AsherNoble/trueskate-ai-hardware/pcb/sources/user-encoder-installed.png

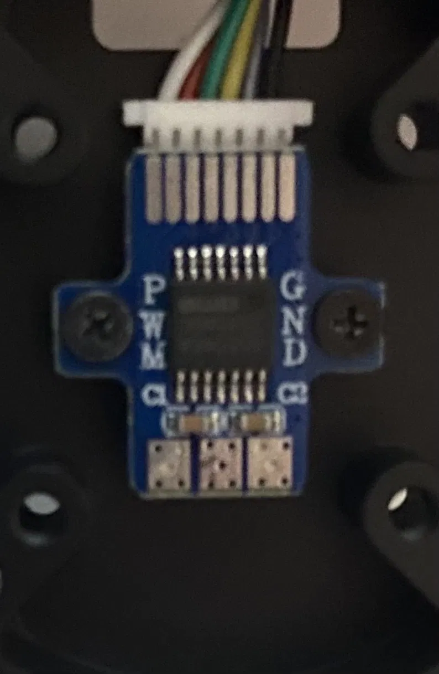
pcb/sources/user-encoder-installed.png
