AsherNoble/trueskate-ai-hardware/pcb/mockups/assembly-model/assembled-top-overview.png

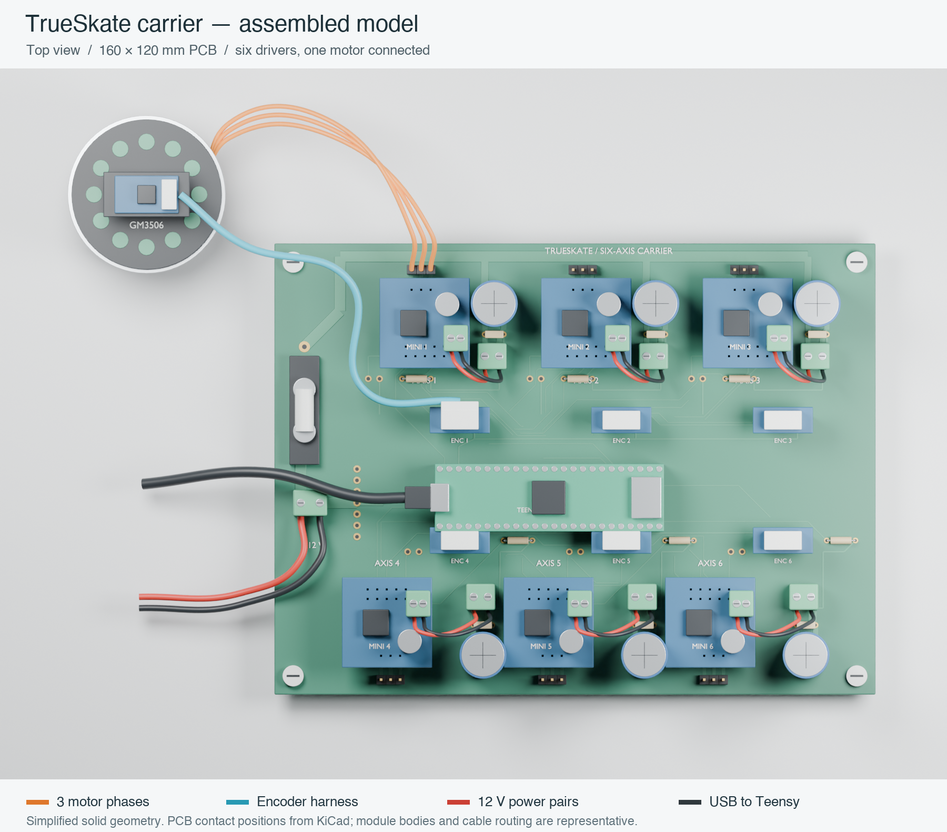
pcb/mockups/assembly-model/assembled-top-overview.png
