AsherNoble/trueskate-ai-hardware/pcb/review/README.md

# Current review package

- `drawings/`: schematic PDF, one-page net guide, 1:1 mechanical template and Mini drill overlay.
- `checks/`: ERC/DRC, connectivity, placement, safety-state and geometry evidence.
- [review-status.json](checks/review-status.json) records the checks and artifact hashes.

The editable source is in [design/](../design/README.md); images are in [renders/](../renders/README.md).
