AsherNoble/trueskate-ai-hardware/pcb/mockups/README.md

# Assembled carrier concept

**Historical revision:** these assembled mockups predate the exact 15-hole
Mini v1.0 direct-power footprint and relocated capacitors. Current board
geometry is in `pcb/trueskate-main-v1.kicad_pcb` and its review renders.

Superseded by the actual Blender assembly in `assembly-model/`. Use
`assembly-model/assembled-overview.png` and `assembly-model/trueskate-assembly.blend`.
The earlier image below is retained only as an abandoned concept.

Generated using the built-in image generation tool, 2026-10-18.
Reference inputs: ../3d-review.png, ../top-review.png,
../sources/user-mini-side.png, ../sources/user-encoder-installed.png.

Prompt brief: Create a realistic elevated three-quarter studio render of the
160 × 120 mm green TrueSkate carrier, populated with a Teensy 4.1, six
SimpleFOC Minis, six capacitors, sockets, headers, fuse, encoder adapters and
one GM3506 motor. Show USB, 12 V power, short paired driver power wires,
three motor phase wires and a separate six-conductor encoder cable.
Preserve reference board layout and use external labels. Caption it as an
illustrative concept, not a wiring guide. Revision prompt corrected USB mating,
encoder connection to ENC1 and removed capacitor-connected power wires.

This is an AI-generated visual mockup, not an assembled CAD model. Component
geometry, connector placement and some wire terminations are approximate.
In particular the top-row power terminals are duplicated/misplaced, motor phase
termination is partly obscured, and Teensy proportions are approximate.
Use the native KiCad files and docs/pcb/nets.md for assembly, not this image.
No manufacturing source or fabrication ZIP was changed.
