AsherNoble/trueskate-ai-hardware/docs/pcb/mechanical.md

# Current mechanical layout

150 × 140 × 1.6 mm; upper A2/A3/A5, lower A1/A4/A6 at 35 mm pitch. Four Ø3.2 mm M3 holes: (4,4), (146,4), (146,136), (4,136) mm. Teensy USB shell is flush at X=0, SD end at PCB X=61.66 mm. Reserve X=61.66…81.66, Y=62.5…77.5 mm for card access.

See the [3+3 report](3plus3-layout.md), [SD drawing](../../pcb/review/drawings/sd-access.svg) and [1:1 fit drawing](../../pcb/review/drawings/mechanical-fit-review.pdf). Actual socket, card, cable and enclosure fit still require checking.
