AsherNoble/trueskate-ai-hardware/pcb/manufacturing/validation/drill-report.txt

Drill report for trueskate-main-v1.kicad_pcb
Created on 2026-10-25T18:21:48

Copper Layer Stackup:
    =============================================================
    L1 :  F.Cu                      front
    L2 :  B.Cu                      back

Drill file 'trueskate-main-v1-PTH.drl' contains
    plated through holes:
    =============================================================
    T1  0.300mm  0.0118"  (500 holes))
    T2  0.600mm  0.0236"  (8 holes))
    T3  0.800mm  0.0315"  (84 holes))
    T4  1.000mm  0.0394"  (68 holes))
    T5  1.021mm  0.0402"  (18 holes))
    T6  1.100mm  0.0433"  (2 holes))
    T7  1.101mm  0.0433"  (72 holes))
    T8  1.200mm  0.0472"  (12 holes))
    T9  1.300mm  0.0512"  (2 holes))
    T10  1.400mm  0.0551"  (3 holes))
    T11  1.650mm  0.0650"  (4 holes))

    Total plated holes count 773

Drill file 'trueskate-main-v1-NPTH.drl' contains
    unplated through holes:
    =============================================================
    T1  3.200mm  0.1260"  (4 holes))

    Total unplated holes count 4
