AsherNoble/trueskate-ai-hardware/pcb/sources/README.md

# Design references

Manufacturer drawings, tagged SimpleFOC Mini source, derived Mini geometry and
user-supplied reference photographs are kept here. `jlc-two-layer-1oz/` contains
the current quote evidence and settings. Prior four-layer quotes and stopped
thermal calculations are in [archive/](../archive/README.md).

The source records retain their original file names, revision identifiers and
provenance. They are references, not manufacturing exports for this carrier.
