AsherNoble/trueskate-ai-hardware/pcb/3d-review.png

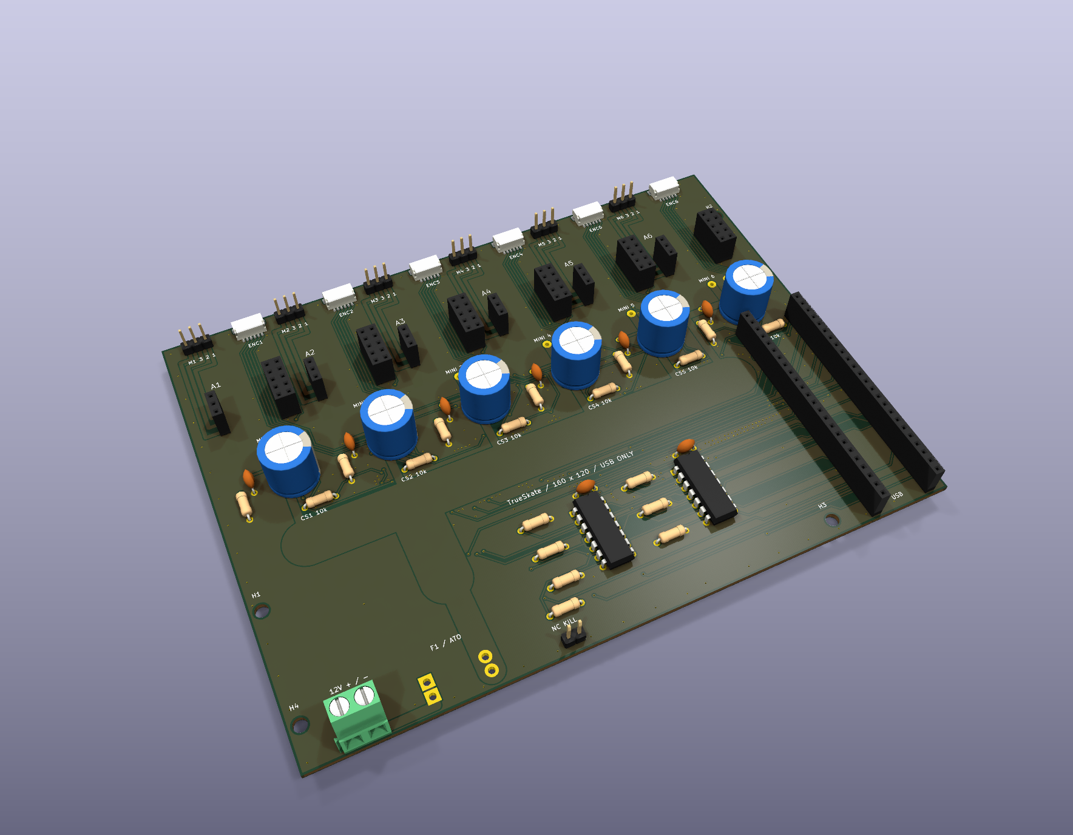
pcb/3d-review.png
