AsherNoble/trueskate-ai-hardware/pcb/bottom-review.png

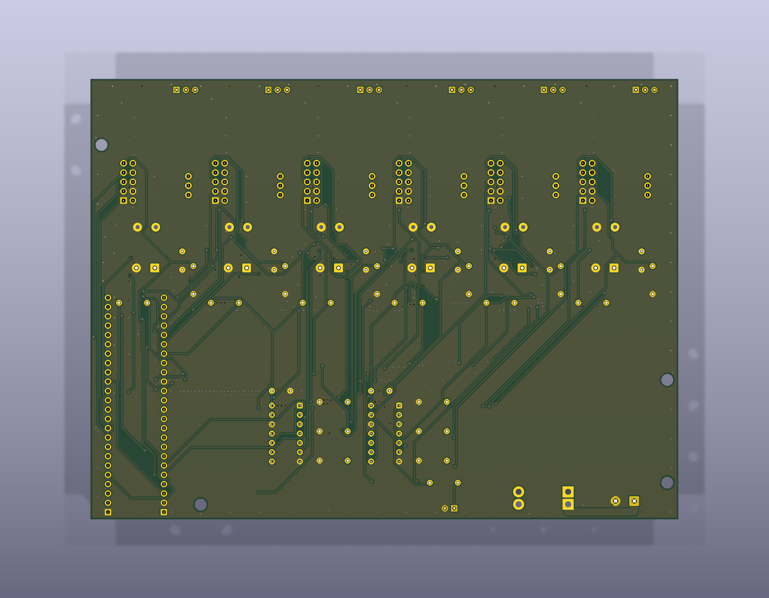
pcb/bottom-review.png
