AsherNoble/trueskate-ai-hardware/pcb/l2-ground-review.png

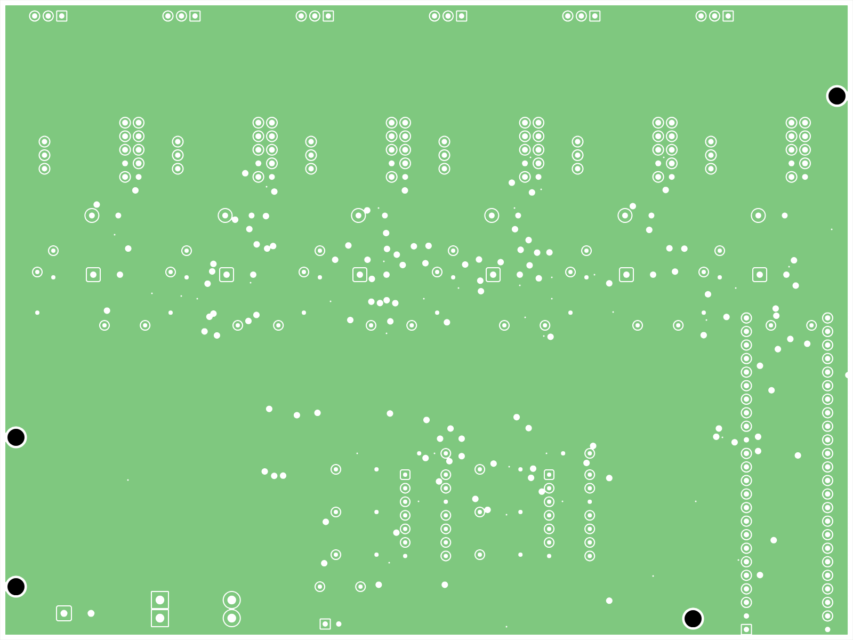
pcb/l2-ground-review.png
