AsherNoble/trueskate-ai-hardware/pcb/mini-drill-overlay.png

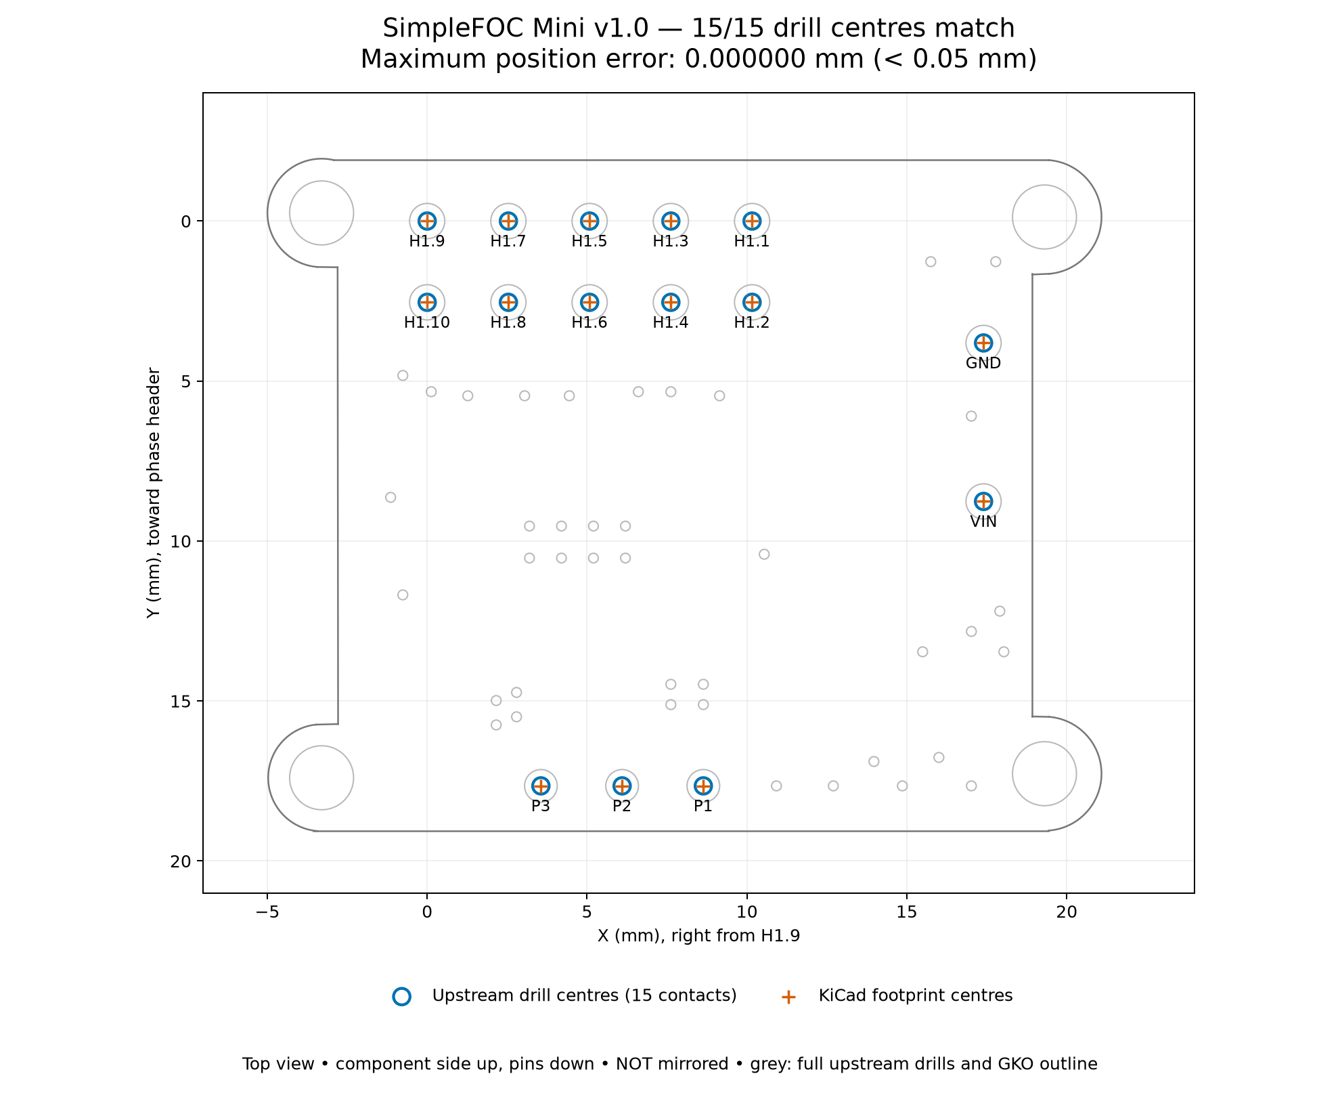
pcb/mini-drill-overlay.png
