AsherNoble/trueskate-ai-hardware/pcb/renders/bare/3d-review.png

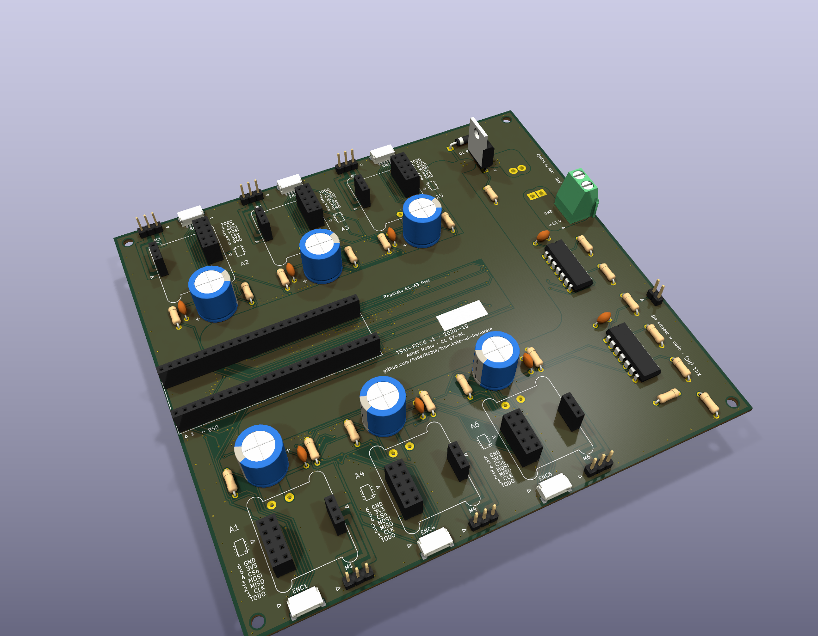
pcb/renders/bare/3d-review.png
