AsherNoble/trueskate-ai-hardware/pcb/renders/bare/bottom-review.png

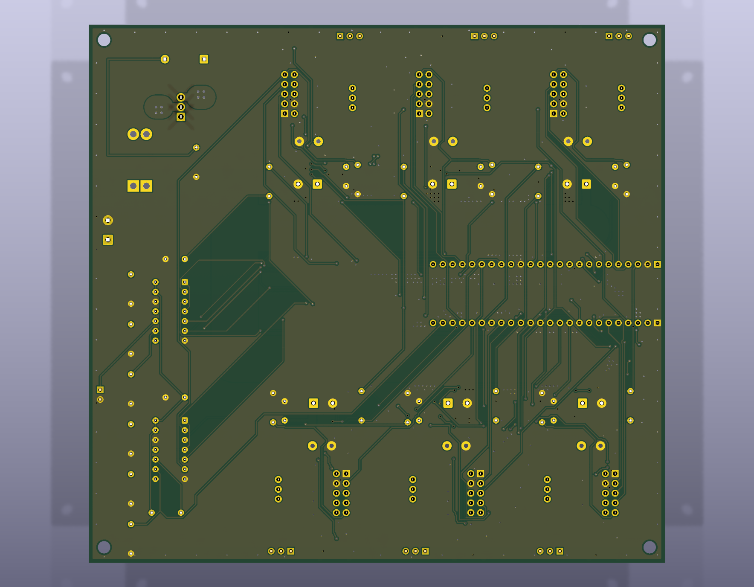
pcb/renders/bare/bottom-review.png
