AsherNoble/trueskate-ai-hardware/pcb/renders/bare/top-review.png

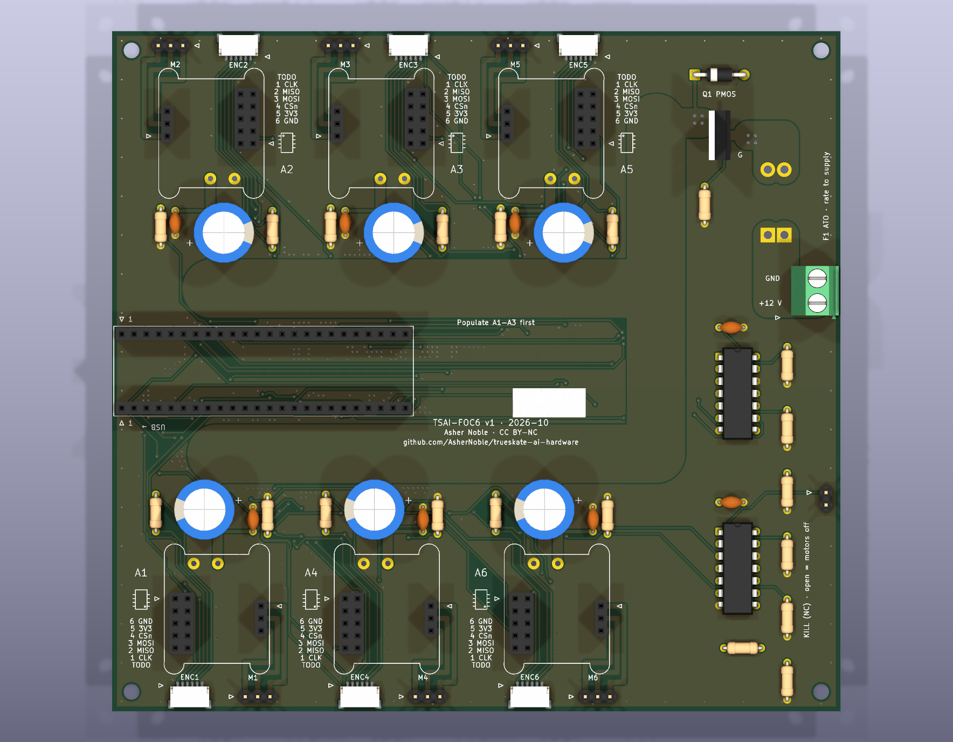
pcb/renders/bare/top-review.png
