AsherNoble/trueskate-ai-hardware/pcb/renders/copper/return-path-gaps.png

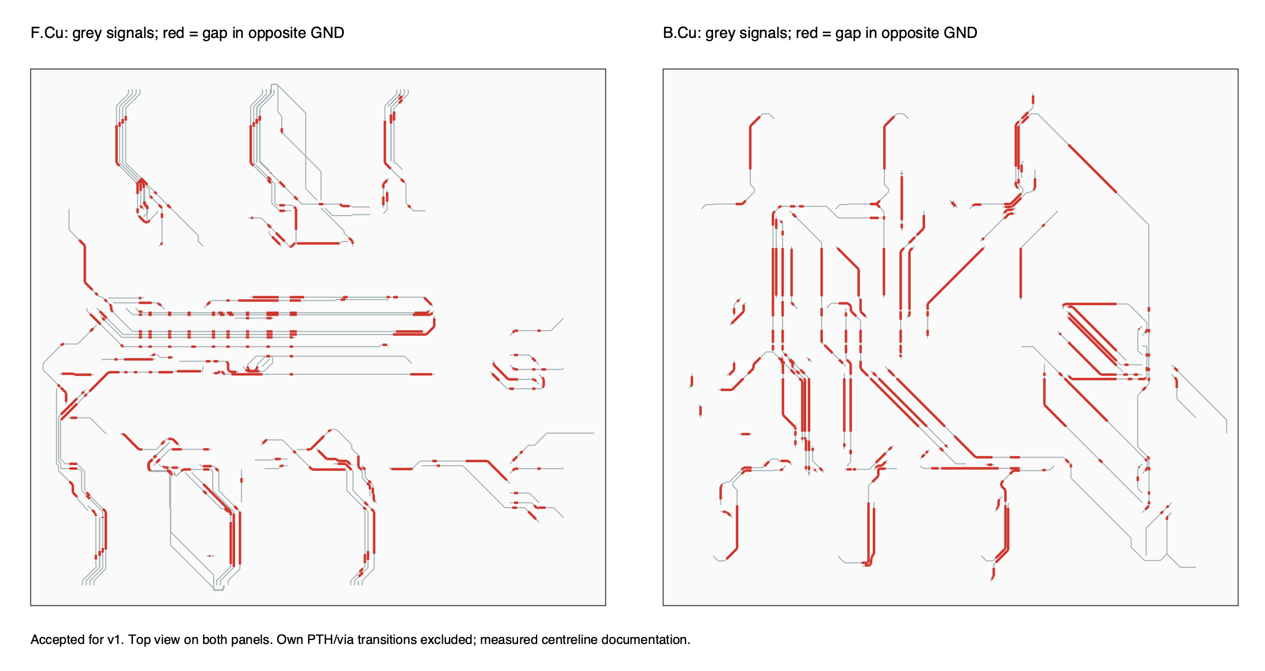
pcb/renders/copper/return-path-gaps.png
