AsherNoble/trueskate-ai-hardware/pcb/renders/populated-bottom.png

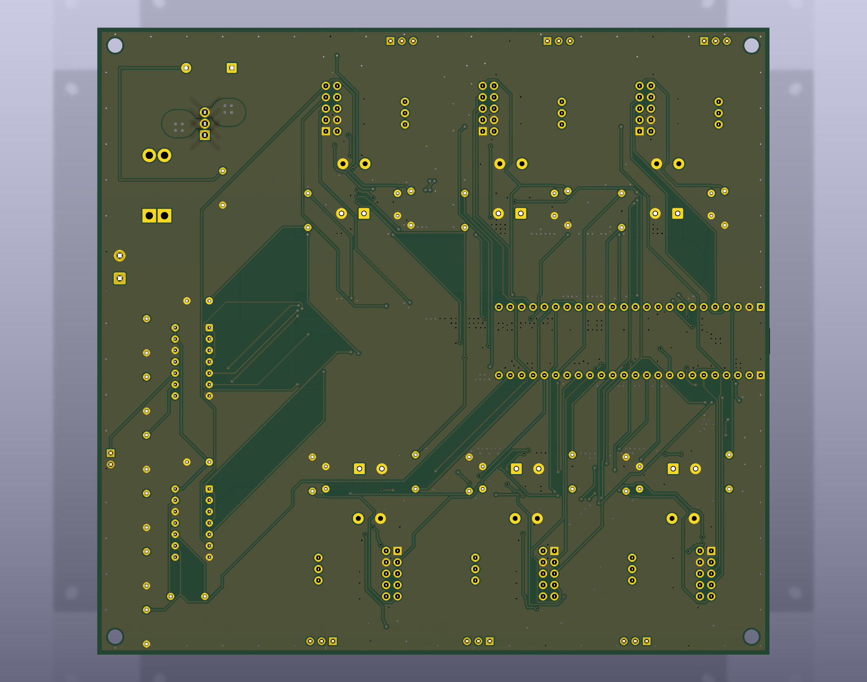
pcb/renders/populated-bottom.png
