AsherNoble/trueskate-ai-hardware/pcb/renders/populated-perspective.png

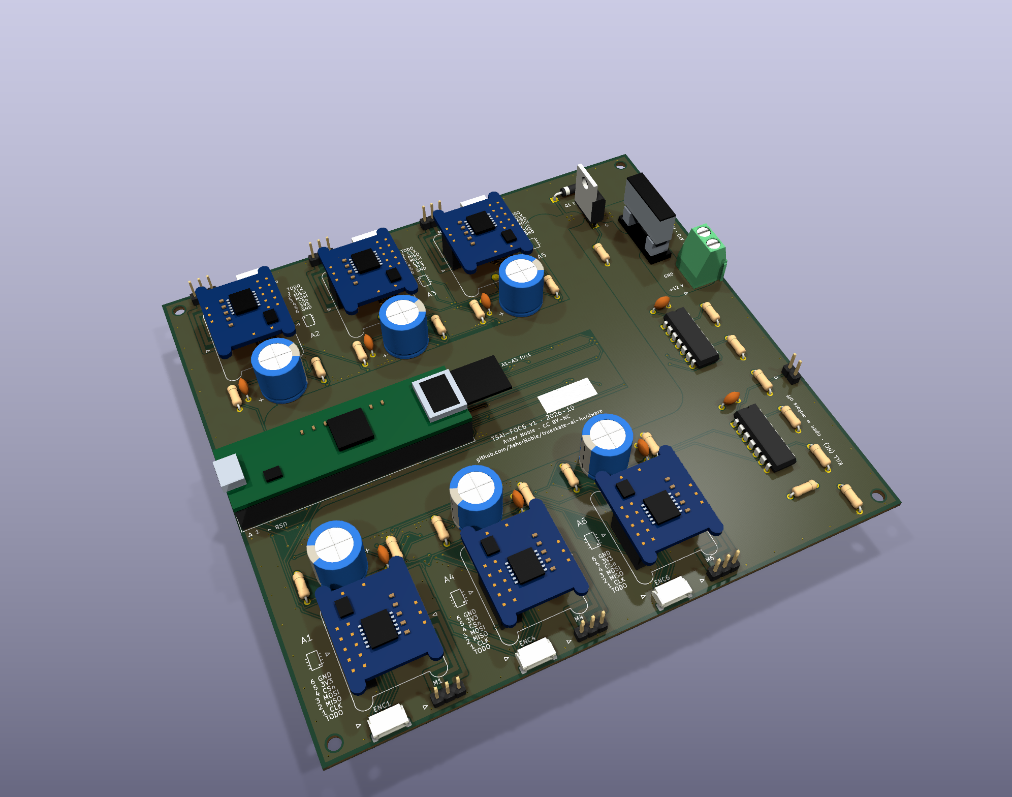
pcb/renders/populated-perspective.png
