AsherNoble/trueskate-ai-hardware/pcb/renders/populated-rear.png

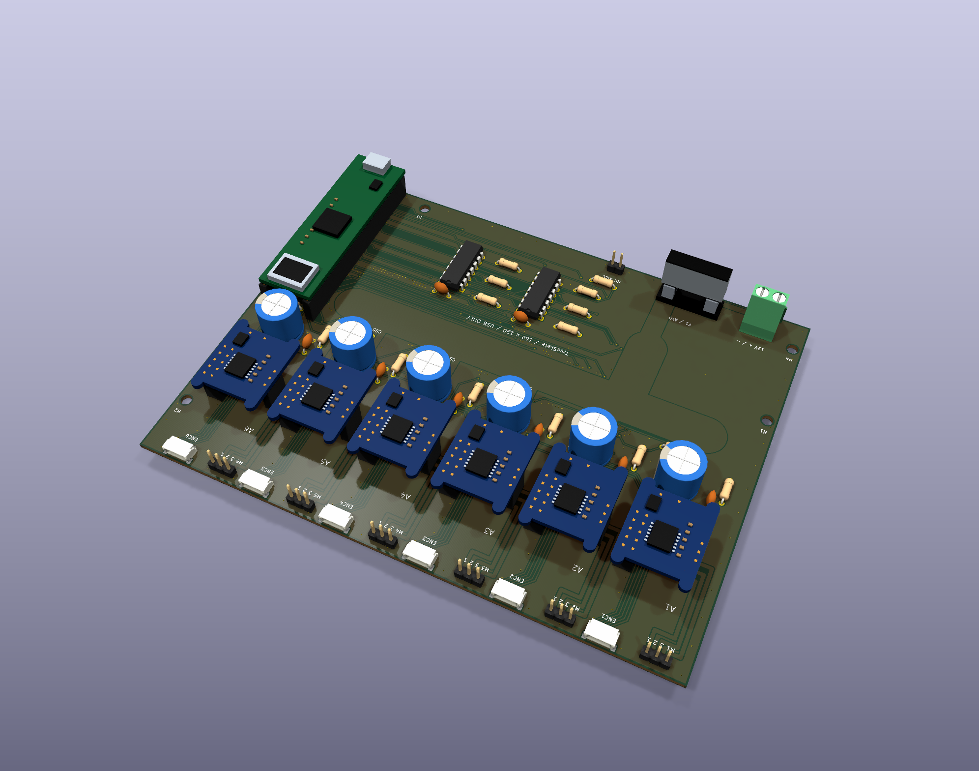
pcb/renders/populated-rear.png
