AsherNoble/trueskate-ai-hardware/pcb/renders/populated-top.png

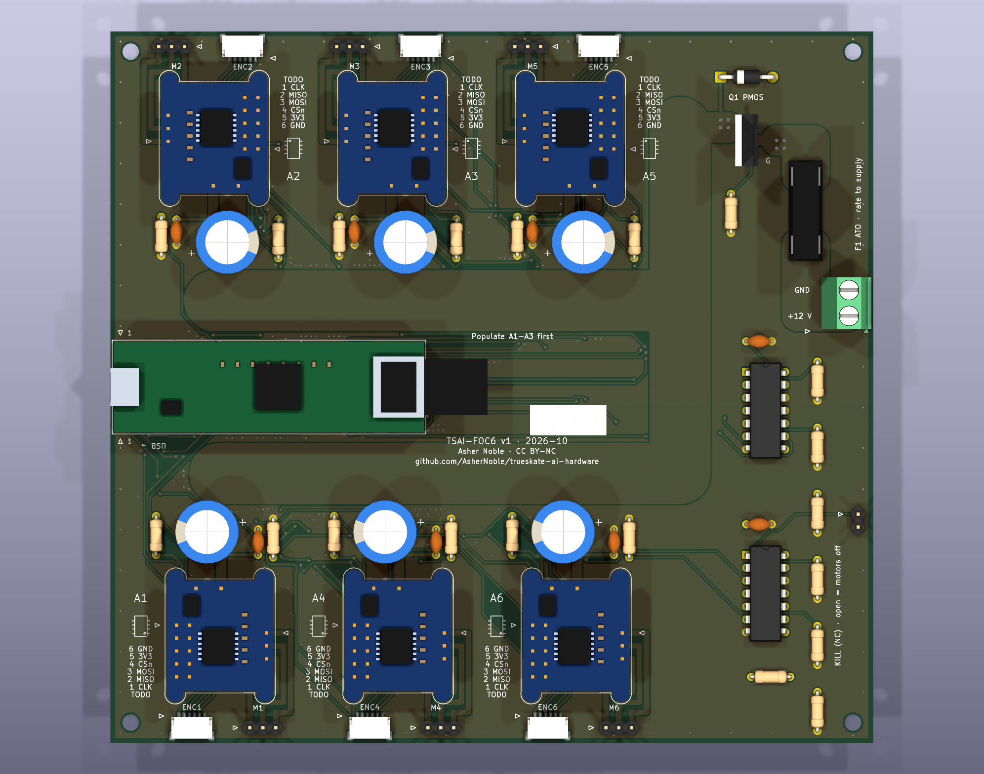
pcb/renders/populated-top.png
