AsherNoble/trueskate-ai-hardware/pcb/review/drawings/sd-access.png

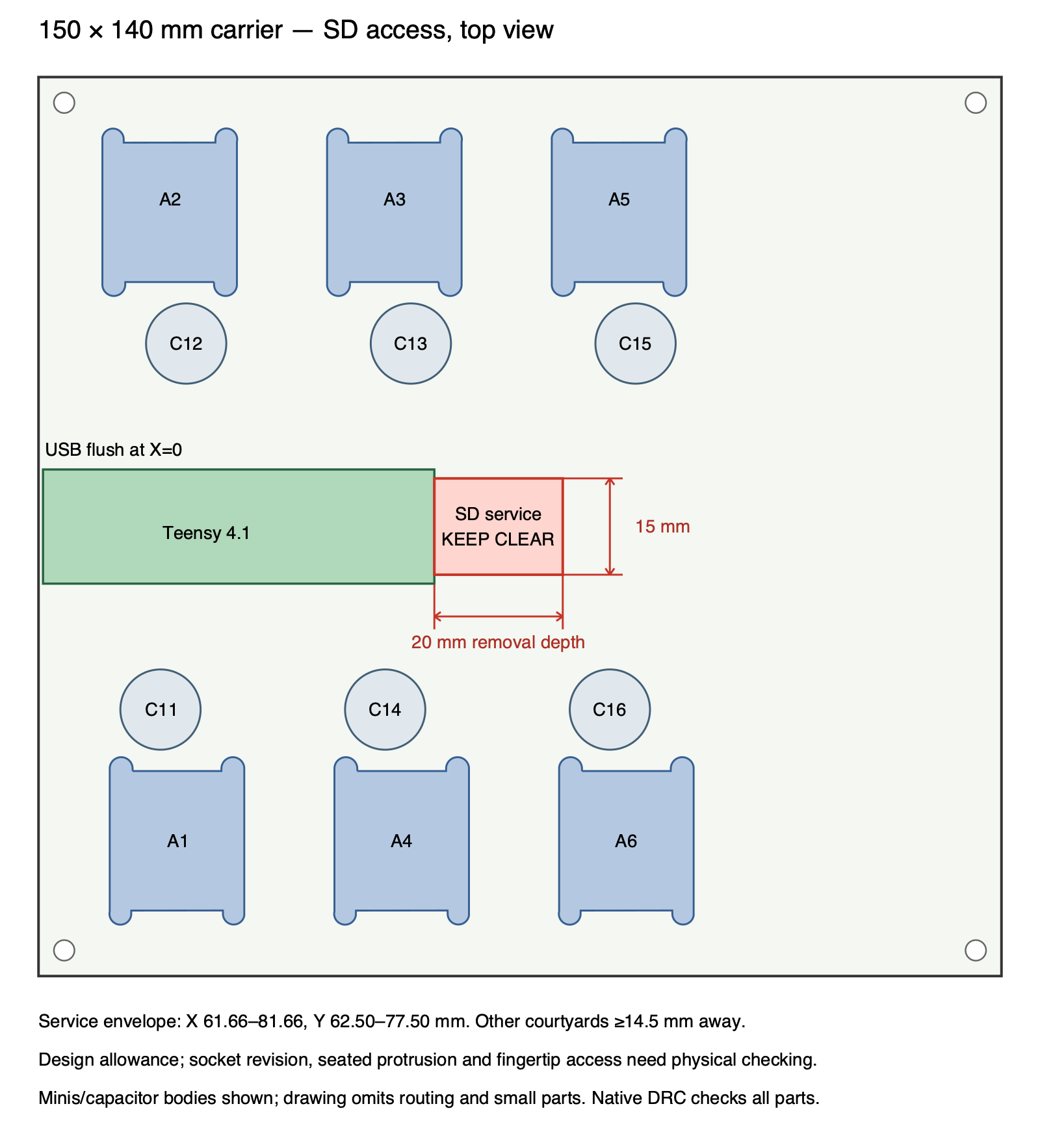
pcb/review/drawings/sd-access.png
