AsherNoble/trueskate-ai-hardware/pcb/sources/iflight-encoder-labels.png

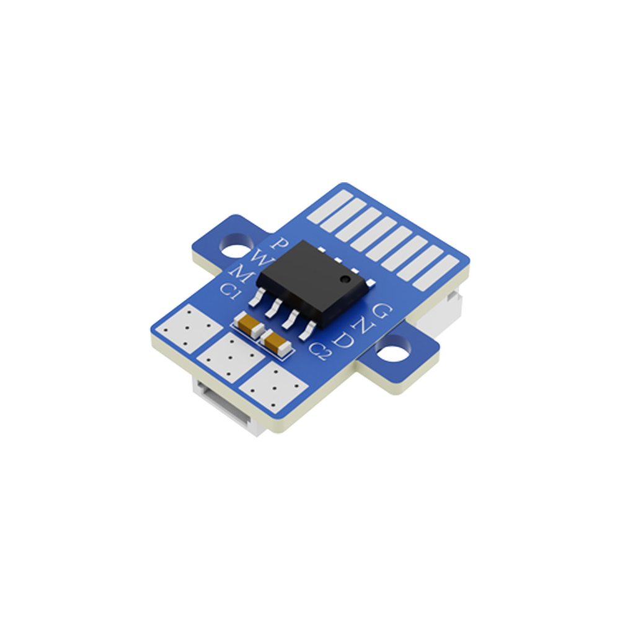
pcb/sources/iflight-encoder-labels.png
