AsherNoble/trueskate-ai-hardware/pcb/sources/iflight-encoder.png

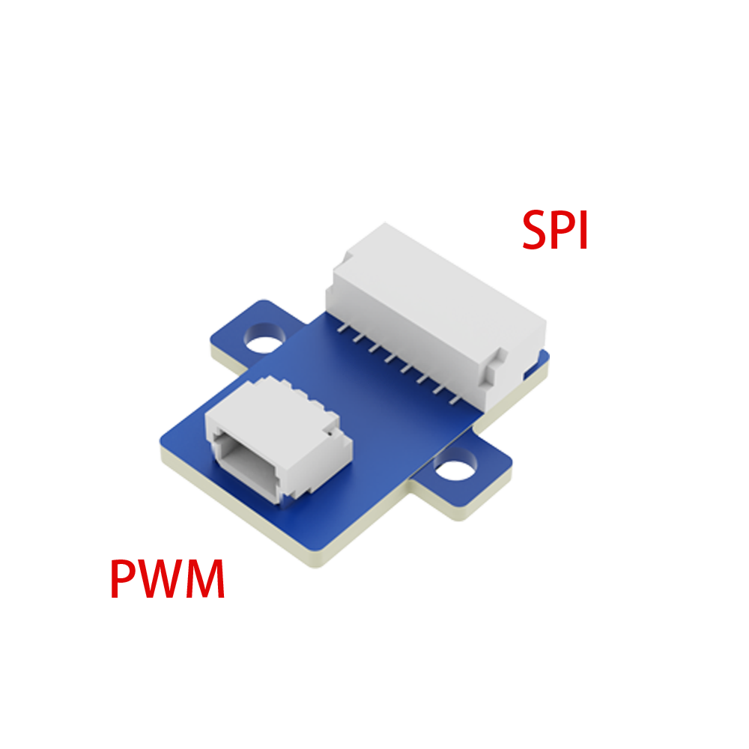
pcb/sources/iflight-encoder.png
