AsherNoble/trueskate-ai-hardware/pcb/sources/jlc-3plus3/150x100.png

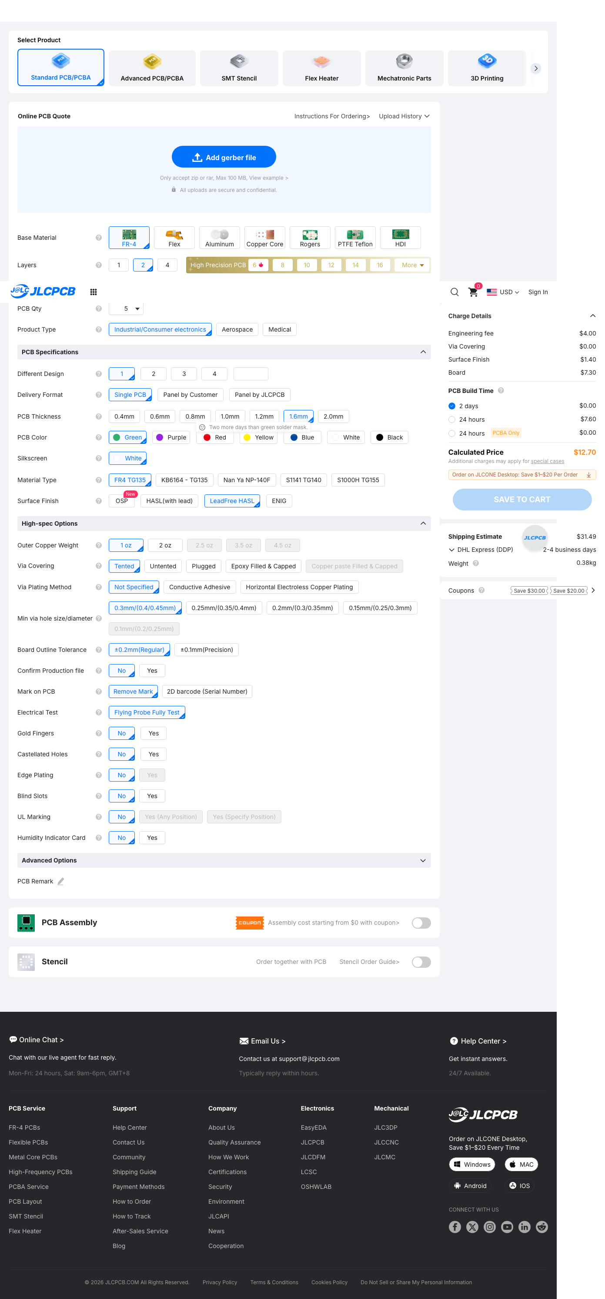
pcb/sources/jlc-3plus3/150x100.png
