AsherNoble/trueskate-ai-hardware/pcb/sources/user-encoder-chip.png

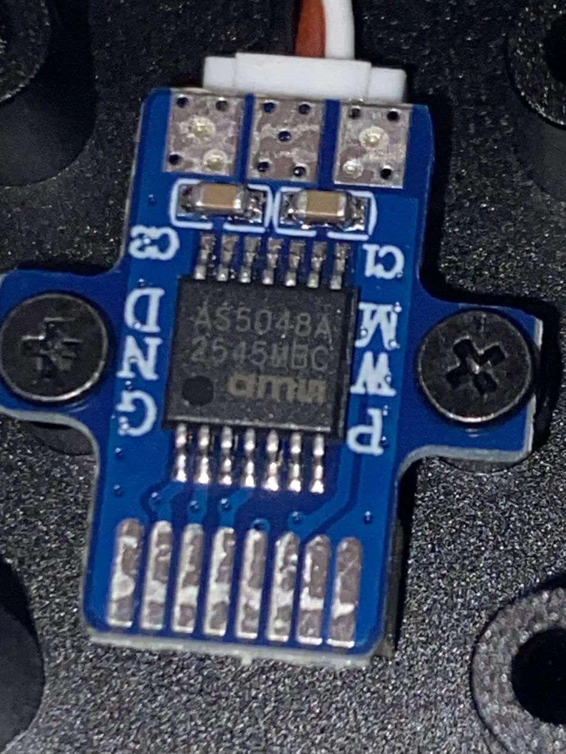
pcb/sources/user-encoder-chip.png
