AsherNoble/trueskate-ai-hardware/pcb/sources/user-encoder-connectors.png

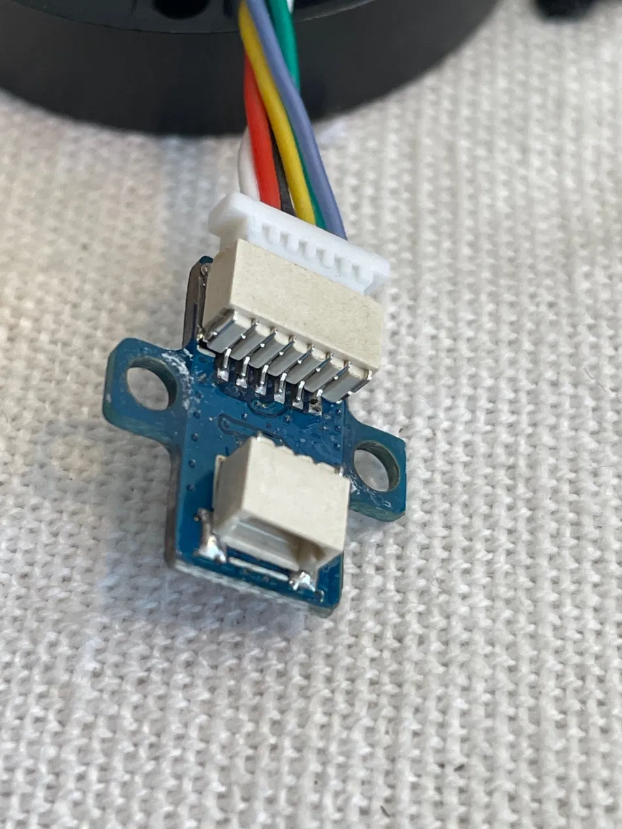
pcb/sources/user-encoder-connectors.png
