AsherNoble/trueskate-ai-hardware/pcb/sources/user-mini-side.png

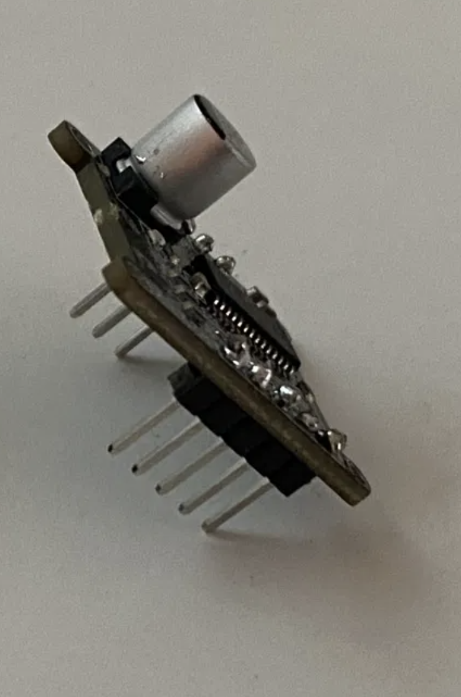
pcb/sources/user-mini-side.png
