AsherNoble/trueskate-ai-hardware/pcb/top-review.png

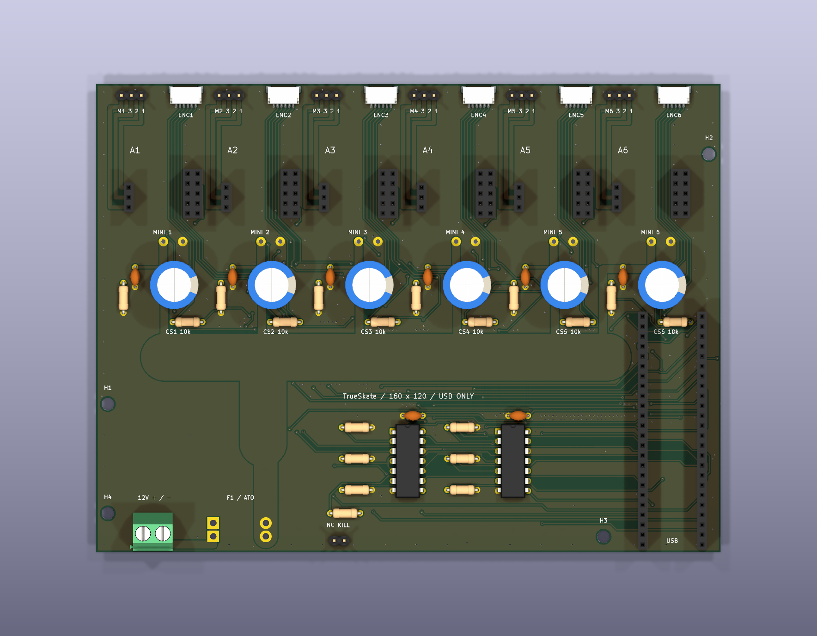
pcb/top-review.png
