AsherNoble/trueskate-ai-hardware/pcb/bom-diff.md

# BOM diff from f5fce90

| Change | Reference(s) | Details |
|---|---|---|
| Changed | F1 | ATO fuse holder / fuse TBD → Keystone 3557-2 ATO holder; Hand |

F1 changes to one Keystone3557-2 complete standard-ATO holder (C352820); both fuse contacts are included in that single part. No fuse amperage is specified. Six bulk capacitors and six ceramics move outside the GKO+0.5mm Mini courtyard; their quantities and MPNs do not change. CS pull-ups move behind the Minis to free the encoder lanes. Resistors are specified as 10k, 5% or better. No Teensy pin changes.
