AsherNoble/trueskate-ai-hardware/docs/pcb/sourcing.md

# Current sourcing

Current part references and assembly assignments are in [the BOM](../../pcb/bom/bom-review.csv).
J31–J36: JST SM06B-SRSS-TB, JLC part C7588156; verify availability and exact suffix
when quoting. U1/U2: TI SN74HC125N DIP-14, LCSC C2890 (quantity 2). Powered-off EN is not datasheet-guaranteed; see [carrier review](carrier.md). F1: Keystone3557-2 (C352820), quantity1 ATO holder.
All non-JST board components are hand-soldered THT. No order or manufacturing upload
has been made. The single power receptacle MPN and matched seating height still need
mechanical selection. Fuse rated to the connected supply.
