AsherNoble/trueskate-ai-hardware/docs/pcb/bom.md

# Current BOM

Use [bom-review.csv](../../pcb/bom/bom-review.csv) and [BOM diff](../../pcb/bom/bom-diff.md).
Only J31–J36 are JLC-assembled SMD. All remaining fitted board parts are hand-soldered THT.
F1 is now an ATO holder; no fuse rating is specified. Twelve single machine-pin receptacles
are retained as a separate procurement row. Plug-in boards, external NC switch and
verified mating encoder harnesses are additional system items. Cost entries are estimates.
