AsherNoble/trueskate-ai-hardware/pcb/bom/trueskate-main-v1-sourcing-BOM.xlsx

TrueSkate · Sourcing BOM
One complete six-axis carrier · 15 grouped items · 73 units · Unit costs are estimates in USD.
Edit column A: select a cell, then use its dropdown to choose Have or Don’t have. Blank = unchecked. Extra details: unhide H–I.
Have / Don’t have | Quantity | Item | LCSC | USD each | References | Notes | Assembly | Footprint
Have | 2 | Teensy 4.1 FEMALE 1x24 |  | $1.50 | J1, J2 | J1 (Teensy 4.1 FEMALE 1x24): Physical pin legend: GND,0,1,2,3,4,5,6,7,8,9,10,11,12,3V3,24,25,26,27,28,29,30,31,32 J2 (Teensy 4.1 FEMALE 1x24): Physical pin legend: VIN,GND,3V3,23,22,21,20,19,18,17,16,15,14,13,GND,41,40,39,38,37,36,35,34,33 | Hand | TrueSkate:Edge_PinSocket_1x24_P2.54mm_Vertical
Have | 6 | Mini v1.0 / 15-hole socket |  | $0.70 | J11, J12, J13, J14, J15, J16 | Optional axis; female 2x5 + female 1x3 + two >=3A single receptacles; matched mating height | Hand | TrueSkate:SimpleFOC_Mini_v1.0
 | 6 | MOTOR PHASES male 1x3 |  | $0.10 | J21, J22, J23, J24, J25, J26 | Optional axis; outward cable clearance at front edge | Hand | TrueSkate:Edge_PinHeader_1x03_P2.54mm_Vertical
 | 6 | SM06B-SRSS-TB | C160405 | $0.90 | J31, J32, J33, J34, J35, J36 | Optional axis; side entry opens toward front (-Y); SH harness pin order UNVERIFIED; JLC assembly uses JST SM06B-SRSS-TB(LF)(SN), replacing out-of-stock supplier code C7588156; same package; hand-soldered by user; no JLC assembly | Hand | TrueSkate:Edge_JST_SH_SM06B-SRSS-TB_1x06-1MP_P1.00mm_Horizontal
 | 19 | 10k resistor, 5% or better |  | $0.05 | R21, R31, R22, R32, R23, R33, R24, R34, R25, R35, R26, R36, R1, R41, R42, R43, R44, R45, R46 | R21, R22, R23, R24, R25, R26 (10k EN pull-down): Optional axis; fit with Mini; 10k, 5% or better R31, R32, R33, R34, R35, R36 (10k CS pull-up): Optional axis; fit with encoder; 10k, 5% or better R1 (10k /OE pull-up): ; 10k, 5% or better R41, R42, R43, R44, R45, R46 (10k EN command pull-down): Shared buffer input bias; may omit with corresponding axis; 10k, 5% or better | Hand | TrueSkate:Edge_R_Axial_DIN0207_L6.3mm_D2.5mm_P7.62mm_Horizontal
Have | 6 | 1000uF 35V EEUFR1V102B | C128476 | $0.00 | C11, C12, C13, C14, C15, C16 | Optional axis; owned Panasonic diameter12.5mm height20mm pitch5mm | Hand / owned | TrueSkate:Edge_CP_Radial_D12.5mm_P5.00mm
 | 8 | 100nF 50V ceramic | C2979769 | $0.13 | C21, C22, C23, C24, C25, C26, C1, C2 | Optional axis; Vishay K104K10X7RF5UH5 C1, C2: buffer bypass; grouped with the specified Vishay K104K10X7RF5UH5 for sourcing (original bypass rows specify 100nF and the same footprint, without an LCSC code). | Hand | TrueSkate:Edge_C_Disc_D5.0mm_W2.5mm_P5.00mm
 | 1 | 12V INPUT + / - |  | $2.00 | J5 | Phoenix1715721 17.5A nominal; verify wire size and applicable rating | Hand | TrueSkate:Edge_TerminalBlock_Phoenix_MKDS-1,5-2-5.08_1x02_P5.08mm_Horizontal
 | 1 | Keystone 3557-2 ATO holder | C352820 | $1.68 | F1 | One complete holder includes both contacts for one standard ATO fuse; fuse purchased separately | Hand | TrueSkate:Keystone_3557-2_ATO
 | 1 | NC KILL SWITCH |  | $0.10 | J6 | Open loop disables every Mini; closed loop permits firmware EN | Hand | TrueSkate:Edge_PinHeader_1x02_P2.54mm_Vertical
 | 2 | SN74LV125AN |  | $1.00 | U1, U2 | Shared mandatory kill buffer; pins1/4/10=/OE,13 disabled; TI SCES124O | Hand | TrueSkate:Edge_DIP-14_W7.62mm
 | 1 | IRF4905PBF | C2564 | $0.62 | Q1 | Infineon TO-220AB; G,D(tab),S; -55V; 20mOhm max at -10V; 74A case rating; no heat sink below ~5A continuous; 12A is copper sizing only | Hand | TrueSkate:Edge_TO-220-3_Vertical
 | 1 | 10k gate pull-down | C433778 | $0.01 | R2 | TyoHM RD1/4W10KJT/BA1; 0.25W,5%; gate bias; 10k, 5% or better | Hand | TrueSkate:Edge_R_Axial_DIN0207_L6.3mm_D2.5mm_P7.62mm_Horizontal
 | 1 | 1N4742A 12V | C2545 | $0.03 | D1 | ST(Semtech); DO-41 12V 1W; band/cathode pad1 to source, anode pad2 to gate | Hand | TrueSkate:Edge_D_DO-41_SOD81_P10.16mm_Horizontal
 | 12 | Single machine-pin receptacle |  | $0.50 | J11-J16 VIN/GND | >=3 A/contact; body/tail fits 1.101 mm finished hole; compatible pin and matching seated height; MPN pending mechanical selection | Hand | Included in SimpleFOC_Mini_v1.0
