AsherNoble/trueskate-ai-hardware/pcb/manufacturing/assembly-options/full-carrier-planning/BOM-NOT-FOR-UPLOAD.csv

Physical reference | PCB reference | Qty per board | Qty for 5 | Required part | Existing footprint | Selected stocked LCSC | Status | Existing or candidate code (not stock approval)
J1 | J1 | 1 | 5 | Teensy 4.1 FEMALE 1x24 | TrueSkate:Edge_PinSocket_1x24_P2.54mm_Vertical |  | UNRESOLVED: exact stocked compatible part not verified; do not order
J2 | J2 | 1 | 5 | Teensy 4.1 FEMALE 1x24 | TrueSkate:Edge_PinSocket_1x24_P2.54mm_Vertical |  | UNRESOLVED: exact stocked compatible part not verified; do not order
J11_CTRL | J11 | 1 | 5 | Female 2x5 2.54mm; matched Mini socket height | TrueSkate:SimpleFOC_Mini_v1.0 |  | UNRESOLVED: exact stocked compatible part not verified; do not order
J11_PHASE | J11 | 1 | 5 | Female 1x3 2.54mm; matched Mini socket height | TrueSkate:SimpleFOC_Mini_v1.0 |  | UNRESOLVED: exact stocked compatible part not verified; do not order
J11_VIN | J11 | 1 | 5 | Single machine-pin receptacle >=3A; matched height; 0.64mm square mating pin | TrueSkate:SimpleFOC_Mini_v1.0 |  | UNRESOLVED: exact stocked compatible part not verified; do not order
J11_GND | J11 | 1 | 5 | Single machine-pin receptacle >=3A; matched height; 0.64mm square mating pin | TrueSkate:SimpleFOC_Mini_v1.0 |  | UNRESOLVED: exact stocked compatible part not verified; do not order
J21 | J21 | 1 | 5 | MOTOR PHASES male 1x3 | TrueSkate:Edge_PinHeader_1x03_P2.54mm_Vertical |  | UNRESOLVED: exact stocked compatible part not verified; do not order
J31 | J31 | 1 | 5 | SM06B-SRSS-TB | TrueSkate:Edge_JST_SH_SM06B-SRSS-TB_1x06-1MP_P1.00mm_Horizontal | C160405 | Selected: stocked JST | C160405
R21 | R21 | 1 | 5 | 10k EN pull-down | TrueSkate:Edge_R_Axial_DIN0207_L6.3mm_D2.5mm_P7.62mm_Horizontal |  | UNRESOLVED: exact stocked compatible part not verified; do not order
R31 | R31 | 1 | 5 | 10k CS pull-up | TrueSkate:Edge_R_Axial_DIN0207_L6.3mm_D2.5mm_P7.62mm_Horizontal |  | UNRESOLVED: exact stocked compatible part not verified; do not order
C11 | C11 | 1 | 5 | 1000uF 35V EEUFR1V102B | TrueSkate:Edge_CP_Radial_D12.5mm_P5.00mm |  | UNRESOLVED: exact stocked compatible part not verified; do not order | C128476
C21 | C21 | 1 | 5 | 100nF 50V ceramic | TrueSkate:Edge_C_Disc_D5.0mm_W2.5mm_P5.00mm |  | UNRESOLVED: exact stocked compatible part not verified; do not order | C2979769
J12_CTRL | J12 | 1 | 5 | Female 2x5 2.54mm; matched Mini socket height | TrueSkate:SimpleFOC_Mini_v1.0 |  | UNRESOLVED: exact stocked compatible part not verified; do not order
J12_PHASE | J12 | 1 | 5 | Female 1x3 2.54mm; matched Mini socket height | TrueSkate:SimpleFOC_Mini_v1.0 |  | UNRESOLVED: exact stocked compatible part not verified; do not order
J12_VIN | J12 | 1 | 5 | Single machine-pin receptacle >=3A; matched height; 0.64mm square mating pin | TrueSkate:SimpleFOC_Mini_v1.0 |  | UNRESOLVED: exact stocked compatible part not verified; do not order
J12_GND | J12 | 1 | 5 | Single machine-pin receptacle >=3A; matched height; 0.64mm square mating pin | TrueSkate:SimpleFOC_Mini_v1.0 |  | UNRESOLVED: exact stocked compatible part not verified; do not order
J22 | J22 | 1 | 5 | MOTOR PHASES male 1x3 | TrueSkate:Edge_PinHeader_1x03_P2.54mm_Vertical |  | UNRESOLVED: exact stocked compatible part not verified; do not order
J32 | J32 | 1 | 5 | SM06B-SRSS-TB | TrueSkate:Edge_JST_SH_SM06B-SRSS-TB_1x06-1MP_P1.00mm_Horizontal | C160405 | Selected: stocked JST | C160405
R22 | R22 | 1 | 5 | 10k EN pull-down | TrueSkate:Edge_R_Axial_DIN0207_L6.3mm_D2.5mm_P7.62mm_Horizontal |  | UNRESOLVED: exact stocked compatible part not verified; do not order
R32 | R32 | 1 | 5 | 10k CS pull-up | TrueSkate:Edge_R_Axial_DIN0207_L6.3mm_D2.5mm_P7.62mm_Horizontal |  | UNRESOLVED: exact stocked compatible part not verified; do not order
C12 | C12 | 1 | 5 | 1000uF 35V EEUFR1V102B | TrueSkate:Edge_CP_Radial_D12.5mm_P5.00mm |  | UNRESOLVED: exact stocked compatible part not verified; do not order | C128476
C22 | C22 | 1 | 5 | 100nF 50V ceramic | TrueSkate:Edge_C_Disc_D5.0mm_W2.5mm_P5.00mm |  | UNRESOLVED: exact stocked compatible part not verified; do not order | C2979769
J13_CTRL | J13 | 1 | 5 | Female 2x5 2.54mm; matched Mini socket height | TrueSkate:SimpleFOC_Mini_v1.0 |  | UNRESOLVED: exact stocked compatible part not verified; do not order
J13_PHASE | J13 | 1 | 5 | Female 1x3 2.54mm; matched Mini socket height | TrueSkate:SimpleFOC_Mini_v1.0 |  | UNRESOLVED: exact stocked compatible part not verified; do not order
J13_VIN | J13 | 1 | 5 | Single machine-pin receptacle >=3A; matched height; 0.64mm square mating pin | TrueSkate:SimpleFOC_Mini_v1.0 |  | UNRESOLVED: exact stocked compatible part not verified; do not order
J13_GND | J13 | 1 | 5 | Single machine-pin receptacle >=3A; matched height; 0.64mm square mating pin | TrueSkate:SimpleFOC_Mini_v1.0 |  | UNRESOLVED: exact stocked compatible part not verified; do not order
J23 | J23 | 1 | 5 | MOTOR PHASES male 1x3 | TrueSkate:Edge_PinHeader_1x03_P2.54mm_Vertical |  | UNRESOLVED: exact stocked compatible part not verified; do not order
J33 | J33 | 1 | 5 | SM06B-SRSS-TB | TrueSkate:Edge_JST_SH_SM06B-SRSS-TB_1x06-1MP_P1.00mm_Horizontal | C160405 | Selected: stocked JST | C160405
R23 | R23 | 1 | 5 | 10k EN pull-down | TrueSkate:Edge_R_Axial_DIN0207_L6.3mm_D2.5mm_P7.62mm_Horizontal |  | UNRESOLVED: exact stocked compatible part not verified; do not order
R33 | R33 | 1 | 5 | 10k CS pull-up | TrueSkate:Edge_R_Axial_DIN0207_L6.3mm_D2.5mm_P7.62mm_Horizontal |  | UNRESOLVED: exact stocked compatible part not verified; do not order
C13 | C13 | 1 | 5 | 1000uF 35V EEUFR1V102B | TrueSkate:Edge_CP_Radial_D12.5mm_P5.00mm |  | UNRESOLVED: exact stocked compatible part not verified; do not order | C128476
C23 | C23 | 1 | 5 | 100nF 50V ceramic | TrueSkate:Edge_C_Disc_D5.0mm_W2.5mm_P5.00mm |  | UNRESOLVED: exact stocked compatible part not verified; do not order | C2979769
J14_CTRL | J14 | 1 | 5 | Female 2x5 2.54mm; matched Mini socket height | TrueSkate:SimpleFOC_Mini_v1.0 |  | UNRESOLVED: exact stocked compatible part not verified; do not order
J14_PHASE | J14 | 1 | 5 | Female 1x3 2.54mm; matched Mini socket height | TrueSkate:SimpleFOC_Mini_v1.0 |  | UNRESOLVED: exact stocked compatible part not verified; do not order
J14_VIN | J14 | 1 | 5 | Single machine-pin receptacle >=3A; matched height; 0.64mm square mating pin | TrueSkate:SimpleFOC_Mini_v1.0 |  | UNRESOLVED: exact stocked compatible part not verified; do not order
J14_GND | J14 | 1 | 5 | Single machine-pin receptacle >=3A; matched height; 0.64mm square mating pin | TrueSkate:SimpleFOC_Mini_v1.0 |  | UNRESOLVED: exact stocked compatible part not verified; do not order
J24 | J24 | 1 | 5 | MOTOR PHASES male 1x3 | TrueSkate:Edge_PinHeader_1x03_P2.54mm_Vertical |  | UNRESOLVED: exact stocked compatible part not verified; do not order
J34 | J34 | 1 | 5 | SM06B-SRSS-TB | TrueSkate:Edge_JST_SH_SM06B-SRSS-TB_1x06-1MP_P1.00mm_Horizontal | C160405 | Selected: stocked JST | C160405
R24 | R24 | 1 | 5 | 10k EN pull-down | TrueSkate:Edge_R_Axial_DIN0207_L6.3mm_D2.5mm_P7.62mm_Horizontal |  | UNRESOLVED: exact stocked compatible part not verified; do not order
R34 | R34 | 1 | 5 | 10k CS pull-up | TrueSkate:Edge_R_Axial_DIN0207_L6.3mm_D2.5mm_P7.62mm_Horizontal |  | UNRESOLVED: exact stocked compatible part not verified; do not order
C14 | C14 | 1 | 5 | 1000uF 35V EEUFR1V102B | TrueSkate:Edge_CP_Radial_D12.5mm_P5.00mm |  | UNRESOLVED: exact stocked compatible part not verified; do not order | C128476
C24 | C24 | 1 | 5 | 100nF 50V ceramic | TrueSkate:Edge_C_Disc_D5.0mm_W2.5mm_P5.00mm |  | UNRESOLVED: exact stocked compatible part not verified; do not order | C2979769
J15_CTRL | J15 | 1 | 5 | Female 2x5 2.54mm; matched Mini socket height | TrueSkate:SimpleFOC_Mini_v1.0 |  | UNRESOLVED: exact stocked compatible part not verified; do not order
J15_PHASE | J15 | 1 | 5 | Female 1x3 2.54mm; matched Mini socket height | TrueSkate:SimpleFOC_Mini_v1.0 |  | UNRESOLVED: exact stocked compatible part not verified; do not order
J15_VIN | J15 | 1 | 5 | Single machine-pin receptacle >=3A; matched height; 0.64mm square mating pin | TrueSkate:SimpleFOC_Mini_v1.0 |  | UNRESOLVED: exact stocked compatible part not verified; do not order
J15_GND | J15 | 1 | 5 | Single machine-pin receptacle >=3A; matched height; 0.64mm square mating pin | TrueSkate:SimpleFOC_Mini_v1.0 |  | UNRESOLVED: exact stocked compatible part not verified; do not order
J25 | J25 | 1 | 5 | MOTOR PHASES male 1x3 | TrueSkate:Edge_PinHeader_1x03_P2.54mm_Vertical |  | UNRESOLVED: exact stocked compatible part not verified; do not order
J35 | J35 | 1 | 5 | SM06B-SRSS-TB | TrueSkate:Edge_JST_SH_SM06B-SRSS-TB_1x06-1MP_P1.00mm_Horizontal | C160405 | Selected: stocked JST | C160405
R25 | R25 | 1 | 5 | 10k EN pull-down | TrueSkate:Edge_R_Axial_DIN0207_L6.3mm_D2.5mm_P7.62mm_Horizontal |  | UNRESOLVED: exact stocked compatible part not verified; do not order
R35 | R35 | 1 | 5 | 10k CS pull-up | TrueSkate:Edge_R_Axial_DIN0207_L6.3mm_D2.5mm_P7.62mm_Horizontal |  | UNRESOLVED: exact stocked compatible part not verified; do not order
C15 | C15 | 1 | 5 | 1000uF 35V EEUFR1V102B | TrueSkate:Edge_CP_Radial_D12.5mm_P5.00mm |  | UNRESOLVED: exact stocked compatible part not verified; do not order | C128476
C25 | C25 | 1 | 5 | 100nF 50V ceramic | TrueSkate:Edge_C_Disc_D5.0mm_W2.5mm_P5.00mm |  | UNRESOLVED: exact stocked compatible part not verified; do not order | C2979769
J16_CTRL | J16 | 1 | 5 | Female 2x5 2.54mm; matched Mini socket height | TrueSkate:SimpleFOC_Mini_v1.0 |  | UNRESOLVED: exact stocked compatible part not verified; do not order
J16_PHASE | J16 | 1 | 5 | Female 1x3 2.54mm; matched Mini socket height | TrueSkate:SimpleFOC_Mini_v1.0 |  | UNRESOLVED: exact stocked compatible part not verified; do not order
J16_VIN | J16 | 1 | 5 | Single machine-pin receptacle >=3A; matched height; 0.64mm square mating pin | TrueSkate:SimpleFOC_Mini_v1.0 |  | UNRESOLVED: exact stocked compatible part not verified; do not order
J16_GND | J16 | 1 | 5 | Single machine-pin receptacle >=3A; matched height; 0.64mm square mating pin | TrueSkate:SimpleFOC_Mini_v1.0 |  | UNRESOLVED: exact stocked compatible part not verified; do not order
J26 | J26 | 1 | 5 | MOTOR PHASES male 1x3 | TrueSkate:Edge_PinHeader_1x03_P2.54mm_Vertical |  | UNRESOLVED: exact stocked compatible part not verified; do not order
J36 | J36 | 1 | 5 | SM06B-SRSS-TB | TrueSkate:Edge_JST_SH_SM06B-SRSS-TB_1x06-1MP_P1.00mm_Horizontal | C160405 | Selected: stocked JST | C160405
R26 | R26 | 1 | 5 | 10k EN pull-down | TrueSkate:Edge_R_Axial_DIN0207_L6.3mm_D2.5mm_P7.62mm_Horizontal |  | UNRESOLVED: exact stocked compatible part not verified; do not order
R36 | R36 | 1 | 5 | 10k CS pull-up | TrueSkate:Edge_R_Axial_DIN0207_L6.3mm_D2.5mm_P7.62mm_Horizontal |  | UNRESOLVED: exact stocked compatible part not verified; do not order
C16 | C16 | 1 | 5 | 1000uF 35V EEUFR1V102B | TrueSkate:Edge_CP_Radial_D12.5mm_P5.00mm |  | UNRESOLVED: exact stocked compatible part not verified; do not order | C128476
C26 | C26 | 1 | 5 | 100nF 50V ceramic | TrueSkate:Edge_C_Disc_D5.0mm_W2.5mm_P5.00mm |  | UNRESOLVED: exact stocked compatible part not verified; do not order | C2979769
J5 | J5 | 1 | 5 | 12V INPUT + / - | TrueSkate:Edge_TerminalBlock_Phoenix_MKDS-1,5-2-5.08_1x02_P5.08mm_Horizontal |  | UNRESOLVED: exact stocked compatible part not verified; do not order
F1 | F1 | 1 | 5 | Keystone 3557-2 ATO holder | TrueSkate:Keystone_3557-2_ATO |  | UNRESOLVED: exact stocked compatible part not verified; do not order | C352820
J6 | J6 | 1 | 5 | NC KILL SWITCH | TrueSkate:Edge_PinHeader_1x02_P2.54mm_Vertical |  | UNRESOLVED: exact stocked compatible part not verified; do not order
R1 | R1 | 1 | 5 | 10k /OE pull-up | TrueSkate:Edge_R_Axial_DIN0207_L6.3mm_D2.5mm_P7.62mm_Horizontal |  | UNRESOLVED: exact stocked compatible part not verified; do not order
U1 | U1 | 1 | 5 | SN74HC125N | TrueSkate:Edge_DIP-14_W7.62mm |  | UNRESOLVED: exact stocked compatible part not verified; do not order | C2890
C1 | C1 | 1 | 5 | 100nF buffer bypass | TrueSkate:Edge_C_Disc_D5.0mm_W2.5mm_P5.00mm |  | UNRESOLVED: exact stocked compatible part not verified; do not order
R41 | R41 | 1 | 5 | 10k EN command pull-down | TrueSkate:Edge_R_Axial_DIN0207_L6.3mm_D2.5mm_P7.62mm_Horizontal |  | UNRESOLVED: exact stocked compatible part not verified; do not order
R42 | R42 | 1 | 5 | 10k EN command pull-down | TrueSkate:Edge_R_Axial_DIN0207_L6.3mm_D2.5mm_P7.62mm_Horizontal |  | UNRESOLVED: exact stocked compatible part not verified; do not order
R43 | R43 | 1 | 5 | 10k EN command pull-down | TrueSkate:Edge_R_Axial_DIN0207_L6.3mm_D2.5mm_P7.62mm_Horizontal |  | UNRESOLVED: exact stocked compatible part not verified; do not order
U2 | U2 | 1 | 5 | SN74HC125N | TrueSkate:Edge_DIP-14_W7.62mm |  | UNRESOLVED: exact stocked compatible part not verified; do not order | C2890
C2 | C2 | 1 | 5 | 100nF buffer bypass | TrueSkate:Edge_C_Disc_D5.0mm_W2.5mm_P5.00mm |  | UNRESOLVED: exact stocked compatible part not verified; do not order
R44 | R44 | 1 | 5 | 10k EN command pull-down | TrueSkate:Edge_R_Axial_DIN0207_L6.3mm_D2.5mm_P7.62mm_Horizontal |  | UNRESOLVED: exact stocked compatible part not verified; do not order
R45 | R45 | 1 | 5 | 10k EN command pull-down | TrueSkate:Edge_R_Axial_DIN0207_L6.3mm_D2.5mm_P7.62mm_Horizontal |  | UNRESOLVED: exact stocked compatible part not verified; do not order
R46 | R46 | 1 | 5 | 10k EN command pull-down | TrueSkate:Edge_R_Axial_DIN0207_L6.3mm_D2.5mm_P7.62mm_Horizontal |  | UNRESOLVED: exact stocked compatible part not verified; do not order
Q1 | Q1 | 1 | 5 | IRF4905PBF | TrueSkate:Edge_TO-220-3_Vertical |  | UNRESOLVED: exact stocked compatible part not verified; do not order | C2564
R2 | R2 | 1 | 5 | 10k gate pull-down | TrueSkate:Edge_R_Axial_DIN0207_L6.3mm_D2.5mm_P7.62mm_Horizontal |  | UNRESOLVED: exact stocked compatible part not verified; do not order | C433778
D1 | D1 | 1 | 5 | 1N4742A 12V | TrueSkate:Edge_D_DO-41_SOD81_P10.16mm_Horizontal |  | UNRESOLVED: exact stocked compatible part not verified; do not order | C2545
