AsherNoble/trueskate-ai-hardware/pcb/manufacturing/assembly-options/jst-only/BOM.csv

Comment | Designator | Footprint | LCSC Part #
SM06B-SRSS-TB(LF)(SN) | J31,J32,J33,J34,J35,J36 | JST_SH_SM06B-SRSS-TB_1x06-1MP_P1.00mm_Horizontal | C160405
