AsherNoble/trueskate-ai-hardware/pcb/manufacturing/assembly-options/full-carrier-planning/PLACEMENTS-NOT-FOR-UPLOAD.csv

Physical reference | PCB reference | Pad centroid X mm | Pad centroid Y mm | Native rotation CCW deg | Layer | Native pad numbers | Qualification
J1 | J1 | 31.1800 | -77.6200 | 90 | Top | 1,2,3,4,5,6,7,8,9,10,11,12,13,14,15,16,17,18,19,20,21,22,23,24 | Pad centroid only; body centroid and JLC zero-angle NOT validated
J2 | J2 | 31.1800 | -62.3800 | 90 | Top | 1,2,3,4,5,6,7,8,9,10,11,12,13,14,15,16,17,18,19,20,21,22,23,24 | Pad centroid only; body centroid and JLC zero-angle NOT validated
J11_CTRL | J11 | 14.2700 | -121.9200 | 90 | Top | 1,2,3,4,5,6,7,8,9,10 | Pad centroid only; body centroid and JLC zero-angle NOT validated
J11_PHASE | J11 | 30.6530 | -120.9040 | 90 | Top | P1,P2,P3 | Pad centroid only; body centroid and JLC zero-angle NOT validated
J11_VIN | J11 | 21.7630 | -109.6010 | 90 | Top | VIN | Pad centroid only; body centroid and JLC zero-angle NOT validated
J11_GND | J11 | 16.8100 | -109.6010 | 90 | Top | GND | Pad centroid only; body centroid and JLC zero-angle NOT validated
J21 | J21 | 29.9600 | -137.0000 | 90 | Top | 1,2,3 | Pad centroid only; body centroid and JLC zero-angle NOT validated
J31 | J31 | 16.0000 | -135.6688 | 0 | Top | 1,2,3,4,5,6,MP,MP | Pad centroid only; body centroid and JLC zero-angle NOT validated
R21 | R21 | 32.0000 | -99.6900 | 90 | Top | 1,2 | Pad centroid only; body centroid and JLC zero-angle NOT validated
R31 | R31 | 9.0000 | -99.1900 | 90 | Top | 1,2 | Pad centroid only; body centroid and JLC zero-angle NOT validated
C11 | C11 | 19.0000 | -98.5000 | 180 | Top | 1,2 | Pad centroid only; body centroid and JLC zero-angle NOT validated
C21 | C21 | 29.0000 | -100.5000 | 90 | Top | 1,2 | Pad centroid only; body centroid and JLC zero-angle NOT validated
J12_CTRL | J12 | 27.7300 | -18.0800 | 270 | Top | 1,2,3,4,5,6,7,8,9,10 | Pad centroid only; body centroid and JLC zero-angle NOT validated
J12_PHASE | J12 | 11.3470 | -19.0960 | 270 | Top | P1,P2,P3 | Pad centroid only; body centroid and JLC zero-angle NOT validated
J12_VIN | J12 | 20.2370 | -30.3990 | 270 | Top | VIN | Pad centroid only; body centroid and JLC zero-angle NOT validated
J12_GND | J12 | 25.1900 | -30.3990 | 270 | Top | GND | Pad centroid only; body centroid and JLC zero-angle NOT validated
J22 | J22 | 12.0400 | -3.0000 | 270 | Top | 1,2,3 | Pad centroid only; body centroid and JLC zero-angle NOT validated
J32 | J32 | 26.0000 | -4.3312 | 180 | Top | 1,2,3,4,5,6,MP,MP | Pad centroid only; body centroid and JLC zero-angle NOT validated
R22 | R22 | 10.0000 | -40.3100 | 270 | Top | 1,2 | Pad centroid only; body centroid and JLC zero-angle NOT validated
R32 | R32 | 33.0000 | -40.8100 | 270 | Top | 1,2 | Pad centroid only; body centroid and JLC zero-angle NOT validated
C12 | C12 | 23.0000 | -41.5000 | 0 | Top | 1,2 | Pad centroid only; body centroid and JLC zero-angle NOT validated
C22 | C22 | 13.0000 | -39.5000 | 270 | Top | 1,2 | Pad centroid only; body centroid and JLC zero-angle NOT validated
J13_CTRL | J13 | 62.7300 | -18.0800 | 270 | Top | 1,2,3,4,5,6,7,8,9,10 | Pad centroid only; body centroid and JLC zero-angle NOT validated
J13_PHASE | J13 | 46.3470 | -19.0960 | 270 | Top | P1,P2,P3 | Pad centroid only; body centroid and JLC zero-angle NOT validated
J13_VIN | J13 | 55.2370 | -30.3990 | 270 | Top | VIN | Pad centroid only; body centroid and JLC zero-angle NOT validated
J13_GND | J13 | 60.1900 | -30.3990 | 270 | Top | GND | Pad centroid only; body centroid and JLC zero-angle NOT validated
J23 | J23 | 47.0400 | -3.0000 | 270 | Top | 1,2,3 | Pad centroid only; body centroid and JLC zero-angle NOT validated
J33 | J33 | 61.0000 | -4.3312 | 180 | Top | 1,2,3,4,5,6,MP,MP | Pad centroid only; body centroid and JLC zero-angle NOT validated
R23 | R23 | 45.0000 | -40.3100 | 270 | Top | 1,2 | Pad centroid only; body centroid and JLC zero-angle NOT validated
R33 | R33 | 68.0000 | -40.8100 | 270 | Top | 1,2 | Pad centroid only; body centroid and JLC zero-angle NOT validated
C13 | C13 | 58.0000 | -41.5000 | 0 | Top | 1,2 | Pad centroid only; body centroid and JLC zero-angle NOT validated
C23 | C23 | 48.0000 | -39.5000 | 270 | Top | 1,2 | Pad centroid only; body centroid and JLC zero-angle NOT validated
J14_CTRL | J14 | 49.2700 | -121.9200 | 90 | Top | 1,2,3,4,5,6,7,8,9,10 | Pad centroid only; body centroid and JLC zero-angle NOT validated
J14_PHASE | J14 | 65.6530 | -120.9040 | 90 | Top | P1,P2,P3 | Pad centroid only; body centroid and JLC zero-angle NOT validated
J14_VIN | J14 | 56.7630 | -109.6010 | 90 | Top | VIN | Pad centroid only; body centroid and JLC zero-angle NOT validated
J14_GND | J14 | 51.8100 | -109.6010 | 90 | Top | GND | Pad centroid only; body centroid and JLC zero-angle NOT validated
J24 | J24 | 64.9600 | -137.0000 | 90 | Top | 1,2,3 | Pad centroid only; body centroid and JLC zero-angle NOT validated
J34 | J34 | 51.0000 | -135.6688 | 0 | Top | 1,2,3,4,5,6,MP,MP | Pad centroid only; body centroid and JLC zero-angle NOT validated
R24 | R24 | 67.0000 | -99.6900 | 90 | Top | 1,2 | Pad centroid only; body centroid and JLC zero-angle NOT validated
R34 | R34 | 44.0000 | -99.1900 | 90 | Top | 1,2 | Pad centroid only; body centroid and JLC zero-angle NOT validated
C14 | C14 | 54.0000 | -98.5000 | 180 | Top | 1,2 | Pad centroid only; body centroid and JLC zero-angle NOT validated
C24 | C24 | 64.0000 | -100.5000 | 90 | Top | 1,2 | Pad centroid only; body centroid and JLC zero-angle NOT validated
J15_CTRL | J15 | 97.7300 | -18.0800 | 270 | Top | 1,2,3,4,5,6,7,8,9,10 | Pad centroid only; body centroid and JLC zero-angle NOT validated
J15_PHASE | J15 | 81.3470 | -19.0960 | 270 | Top | P1,P2,P3 | Pad centroid only; body centroid and JLC zero-angle NOT validated
J15_VIN | J15 | 90.2370 | -30.3990 | 270 | Top | VIN | Pad centroid only; body centroid and JLC zero-angle NOT validated
J15_GND | J15 | 95.1900 | -30.3990 | 270 | Top | GND | Pad centroid only; body centroid and JLC zero-angle NOT validated
J25 | J25 | 82.0400 | -3.0000 | 270 | Top | 1,2,3 | Pad centroid only; body centroid and JLC zero-angle NOT validated
J35 | J35 | 96.0000 | -4.3312 | 180 | Top | 1,2,3,4,5,6,MP,MP | Pad centroid only; body centroid and JLC zero-angle NOT validated
R25 | R25 | 80.0000 | -40.3100 | 270 | Top | 1,2 | Pad centroid only; body centroid and JLC zero-angle NOT validated
R35 | R35 | 103.0000 | -40.8100 | 270 | Top | 1,2 | Pad centroid only; body centroid and JLC zero-angle NOT validated
C15 | C15 | 93.0000 | -41.5000 | 0 | Top | 1,2 | Pad centroid only; body centroid and JLC zero-angle NOT validated
C25 | C25 | 83.0000 | -39.5000 | 270 | Top | 1,2 | Pad centroid only; body centroid and JLC zero-angle NOT validated
J16_CTRL | J16 | 84.2700 | -121.9200 | 90 | Top | 1,2,3,4,5,6,7,8,9,10 | Pad centroid only; body centroid and JLC zero-angle NOT validated
J16_PHASE | J16 | 100.6530 | -120.9040 | 90 | Top | P1,P2,P3 | Pad centroid only; body centroid and JLC zero-angle NOT validated
J16_VIN | J16 | 91.7630 | -109.6010 | 90 | Top | VIN | Pad centroid only; body centroid and JLC zero-angle NOT validated
J16_GND | J16 | 86.8100 | -109.6010 | 90 | Top | GND | Pad centroid only; body centroid and JLC zero-angle NOT validated
J26 | J26 | 99.9600 | -137.0000 | 90 | Top | 1,2,3 | Pad centroid only; body centroid and JLC zero-angle NOT validated
J36 | J36 | 86.0000 | -135.6688 | 0 | Top | 1,2,3,4,5,6,MP,MP | Pad centroid only; body centroid and JLC zero-angle NOT validated
R26 | R26 | 102.0000 | -99.6900 | 90 | Top | 1,2 | Pad centroid only; body centroid and JLC zero-angle NOT validated
R36 | R36 | 79.0000 | -99.1900 | 90 | Top | 1,2 | Pad centroid only; body centroid and JLC zero-angle NOT validated
C16 | C16 | 89.0000 | -98.5000 | 180 | Top | 1,2 | Pad centroid only; body centroid and JLC zero-angle NOT validated
C26 | C26 | 99.0000 | -100.5000 | 90 | Top | 1,2 | Pad centroid only; body centroid and JLC zero-angle NOT validated
J5 | J5 | 145.0000 | -53.4600 | 90 | Top | 1,2 | Pad centroid only; body centroid and JLC zero-angle NOT validated
F1 | F1 | 136.7000 | -35.2650 | 90 | Top | 1,1,2,2 | Pad centroid only; body centroid and JLC zero-angle NOT validated
J6 | J6 | 147.0000 | -96.2700 | 0 | Top | 1,2 | Pad centroid only; body centroid and JLC zero-angle NOT validated
R1 | R1 | 129.8100 | -127.0000 | 0 | Top | 1,2 | Pad centroid only; body centroid and JLC zero-angle NOT validated
U1 | U1 | 128.8100 | -74.6200 | 0 | Top | 1,2,3,4,5,6,7,8,9,10,11,12,13,14 | Pad centroid only; body centroid and JLC zero-angle NOT validated
C1 | C1 | 127.5000 | -61.0000 | 0 | Top | 1,2 | Pad centroid only; body centroid and JLC zero-angle NOT validated
R41 | R41 | 139.0000 | -68.8100 | 270 | Top | 1,2 | Pad centroid only; body centroid and JLC zero-angle NOT validated
R42 | R42 | 139.0000 | -81.8100 | 270 | Top | 1,2 | Pad centroid only; body centroid and JLC zero-angle NOT validated
R43 | R43 | 139.0000 | -94.8100 | 270 | Top | 1,2 | Pad centroid only; body centroid and JLC zero-angle NOT validated
U2 | U2 | 128.8100 | -110.6200 | 0 | Top | 1,2,3,4,5,6,7,8,9,10,11,12,13,14 | Pad centroid only; body centroid and JLC zero-angle NOT validated
C2 | C2 | 127.5000 | -97.0000 | 0 | Top | 1,2 | Pad centroid only; body centroid and JLC zero-angle NOT validated
R44 | R44 | 139.0000 | -107.8100 | 270 | Top | 1,2 | Pad centroid only; body centroid and JLC zero-angle NOT validated
R45 | R45 | 139.0000 | -120.8100 | 270 | Top | 1,2 | Pad centroid only; body centroid and JLC zero-angle NOT validated
R46 | R46 | 139.0000 | -133.8100 | 270 | Top | 1,2 | Pad centroid only; body centroid and JLC zero-angle NOT validated
Q1 | Q1 | 126.0000 | -21.4600 | 90 | Top | 1,2,3 | Pad centroid only; body centroid and JLC zero-angle NOT validated
R2 | R2 | 122.0000 | -35.8100 | 270 | Top | 1,2 | Pad centroid only; body centroid and JLC zero-angle NOT validated
D1 | D1 | 125.0800 | -9.0000 | 0 | Top | 1,2 | Pad centroid only; body centroid and JLC zero-angle NOT validated
