AsherNoble/trueskate-ai-hardware/(list of files, cad)

Other CAD files:
pcb/archive/mockups/assembly-model/trueskate-assembly.blend
