AsherNoble/trueskate-ai-hardware/pcb/manufacturing/assembly-options/bare-pcb/README.md

Use the shared ../../trueskate-main-v1-2layer-1oz-JLCPCB.zip. Select PCB assembly OFF; no BOM/CPL is needed.
