AsherNoble/trueskate-ai-hardware/pcb/archive/fabrication/README.md

# Historical fabrication snapshots

`2026-10-18/` predates the SimpleFOC_Mini_v1.0 direct-power footprint.
Its Gerbers, drills and order package do not represent the current board.
Do not use them for the new revision. No manufacturing package was regenerated
as part of the direct-power change; use the current review artifacts first.
