AsherNoble/trueskate-ai-hardware/firmware/bench/flick_test/data/step_2v.png

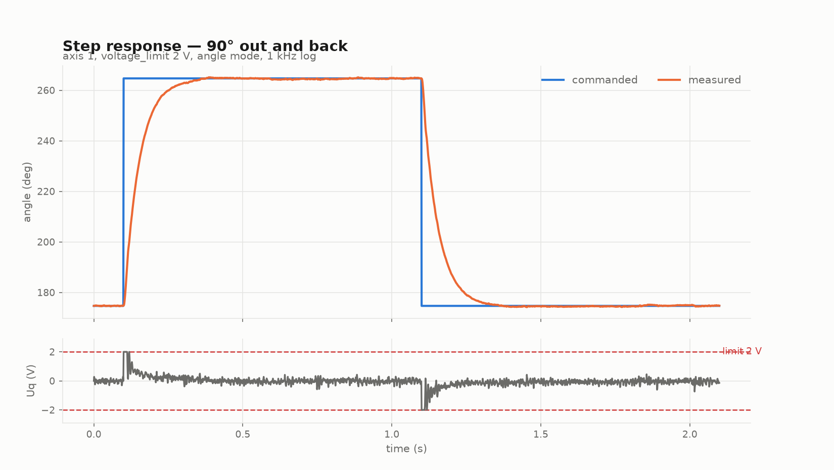
firmware/bench/flick_test/data/step_2v.png
