AsherNoble/trueskate-ai-hardware/pcb/manufacturing/preview/bottom.png

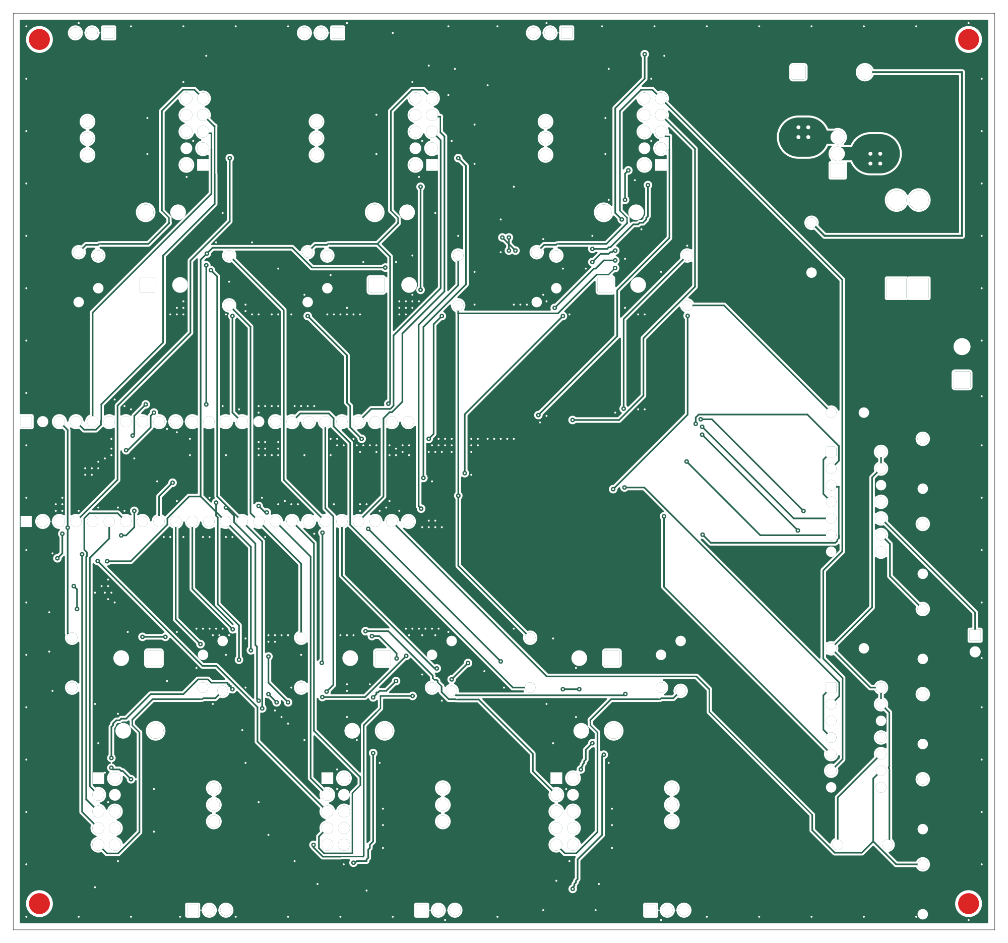
pcb/manufacturing/preview/bottom.png
