AsherNoble/trueskate-ai-hardware/pcb/manufacturing/preview/top.png

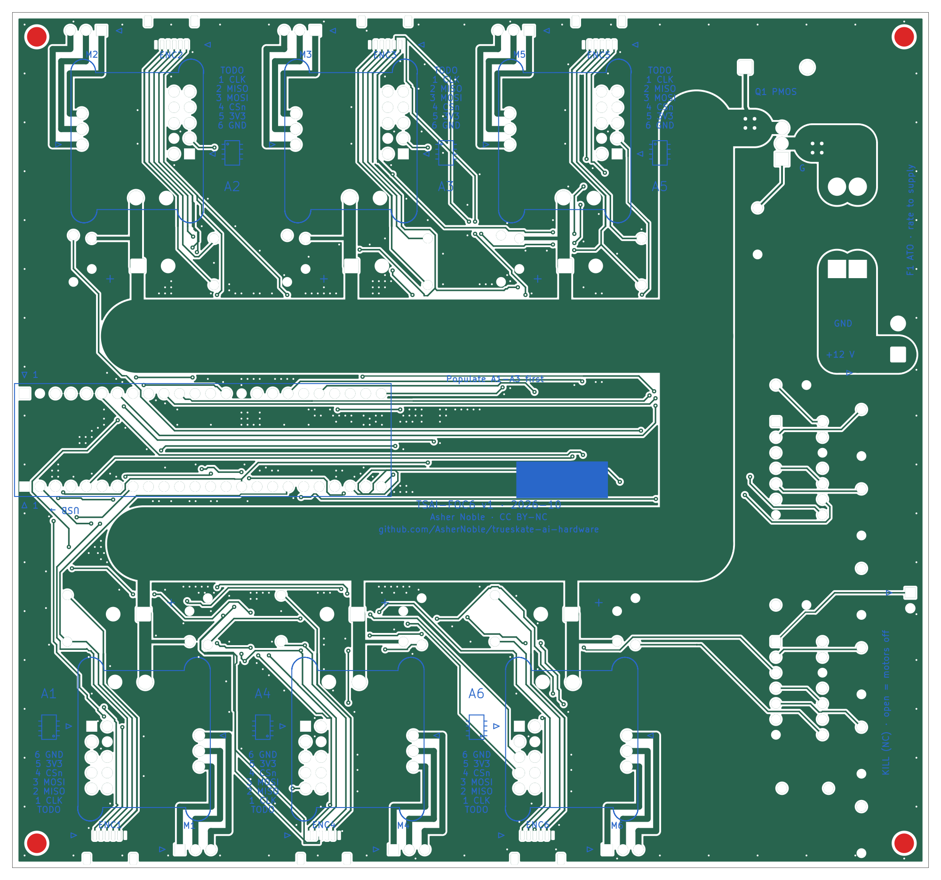
pcb/manufacturing/preview/top.png
