AsherNoble/trueskate-ai-hardware/pcb/mockups/assembled-carrier-one-motor.png

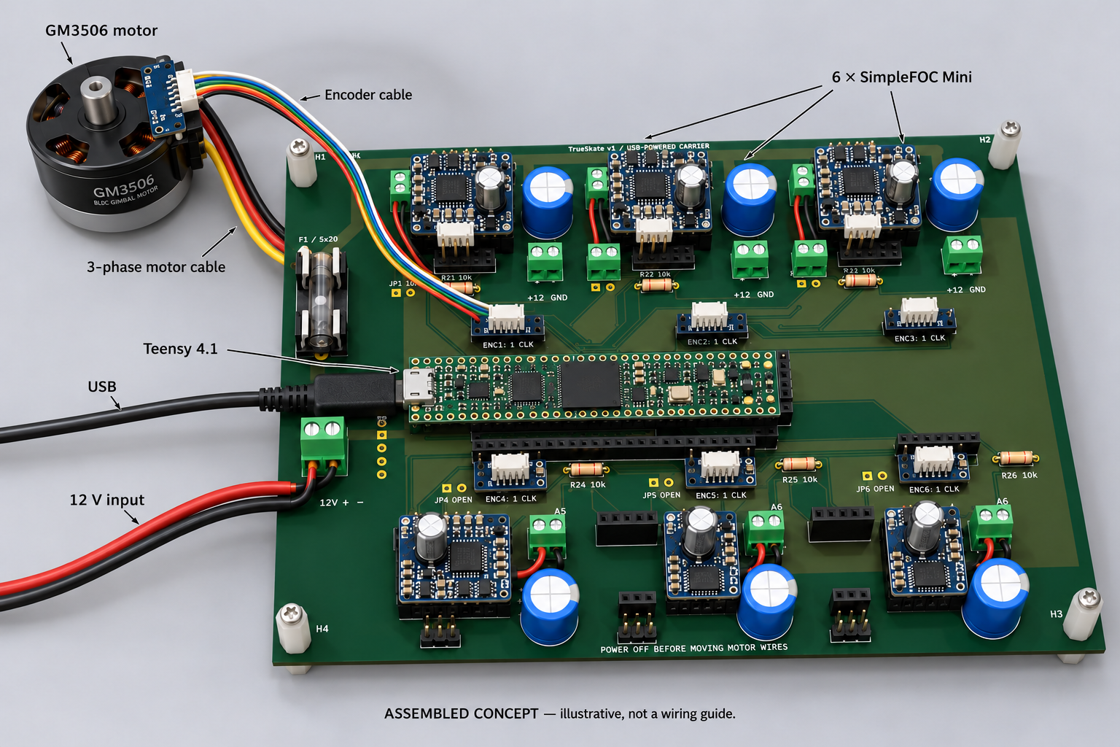
pcb/mockups/assembled-carrier-one-motor.png
