AsherNoble/trueskate-ai-hardware/pcb/mockups/assembly-model/assembled-components-labelled.png

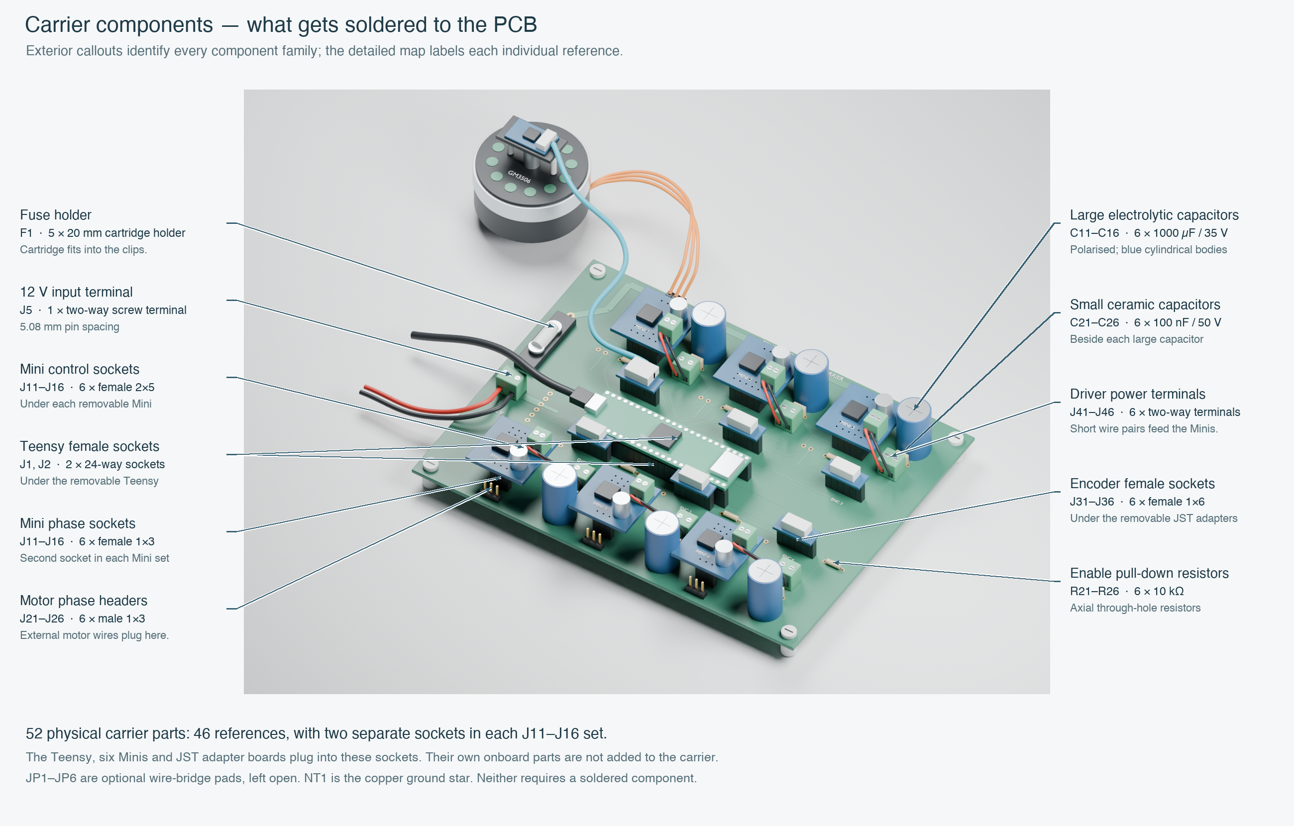
pcb/mockups/assembly-model/assembled-components-labelled.png
