AsherNoble/trueskate-ai-hardware/pcb/mockups/assembly-model/assembly-perspective.png

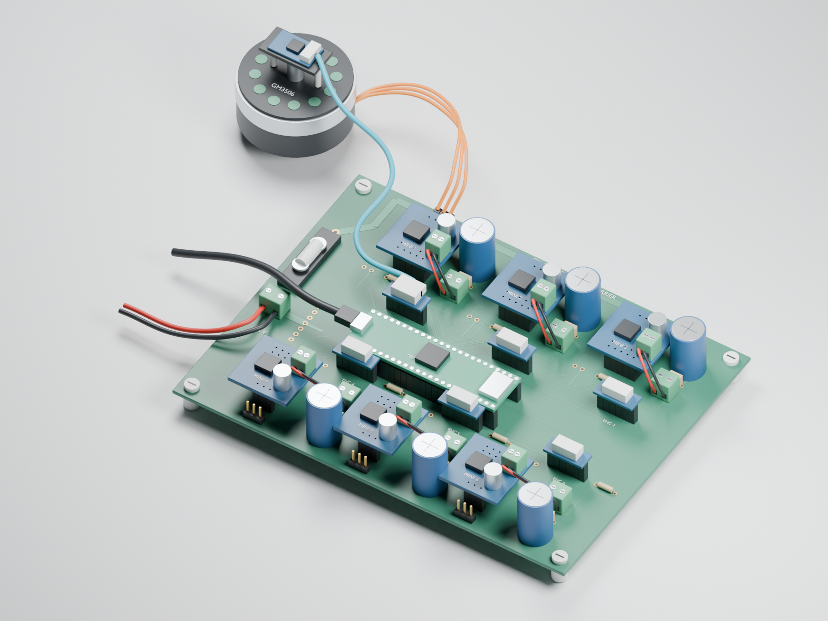
pcb/mockups/assembly-model/assembly-perspective.png
