AsherNoble/trueskate-ai-hardware/pcb/mockups/assembly-model/soldered-components-map.png

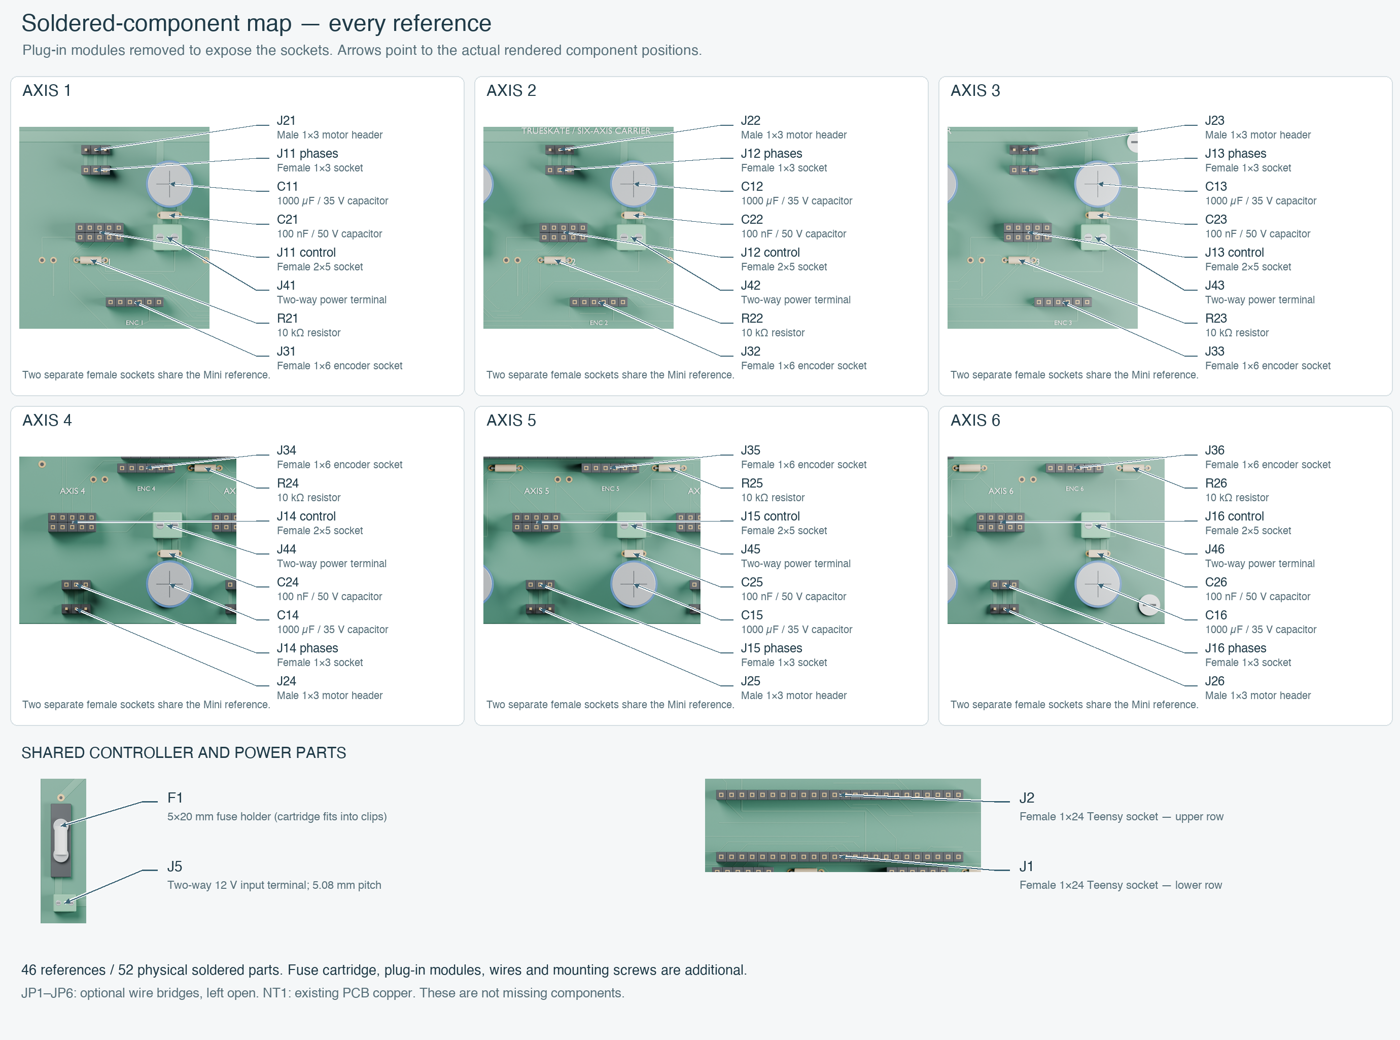
pcb/mockups/assembly-model/soldered-components-map.png
