AsherNoble/trueskate-ai-hardware/firmware/bench/flick_test/data/flick20_2v.csv

R: 20 flicks back to back | voltage_limit 2.00 V
# run=flick20 voltage_limit=2.00 velocity_limit=50.0 samples=13469 rate=1000Hz
t_ms | phase | flick | target_deg | angle_deg | vel_rpm | uq_v
0.040 | 3 | 0 | 175.5176 | 175.5395 | 0.639 | -0.2310
1.001 | 3 | 0 | 175.5176 | 175.4956 | 0.837 | -0.0589
2.000 | 3 | 0 | 175.5176 | 175.4956 | 0.456 | -0.0572
3.038 | 3 | 0 | 175.5176 | 175.4956 | 4.189 | -0.1828
4.037 | 3 | 0 | 175.5176 | 175.5395 | 2.397 | -0.0842
5.037 | 3 | 0 | 175.5176 | 175.4297 | 1.195 | -0.0832
6.036 | 3 | 0 | 175.5176 | 175.4297 | -2.931 | 0.1889
7.035 | 3 | 0 | 175.5176 | 175.4297 | 0.064 | 0.0228
8.035 | 3 | 0 | 175.5176 | 175.3638 | -0.864 | 0.0282
9.034 | 3 | 0 | 175.5176 | 175.4077 | 0.957 | -0.0740
10.034 | 3 | 0 | 175.5176 | 175.4077 | 3.528 | -0.1770
11.033 | 3 | 0 | 175.5176 | 175.4297 | 5.973 | -0.3335
12.032 | 3 | 0 | 175.5176 | 175.3638 | 1.951 | -0.1038
13.032 | 3 | 0 | 175.5176 | 175.3858 | 2.251 | -0.1004
14.031 | 3 | 0 | 175.5176 | 175.4077 | 3.374 | -0.1502
15.030 | 3 | 0 | 175.5176 | 175.2979 | 0.727 | -0.0342
16.030 | 3 | 0 | 175.5176 | 175.2539 | -0.932 | 0.0522
17.029 | 3 | 0 | 175.5176 | 175.3638 | 0.432 | 0.0141
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
