AsherNoble/trueskate-ai-hardware/firmware/bench/flick_test/data/flick20_p160_4v.csv

R: 20 flicks back to back | voltage_limit 4.00 V
# run=flick20 voltage_limit=4.00 velocity_limit=200.0 p_angle=160.0 samples=7026 rate=1000Hz
t_ms | phase | flick | target_deg | angle_deg | vel_rpm | uq_v
0.039 | 3 | 0 | 174.9902 | 174.9683 | 0.940 | 0.7778
1.000 | 3 | 0 | 174.9902 | 174.9902 | 0.635 | -0.0747
2.038 | 3 | 0 | 174.9902 | 174.9902 | -0.733 | 0.0475
3.037 | 3 | 0 | 174.9902 | 174.9902 | -2.328 | 0.1254
4.036 | 3 | 0 | 174.9902 | 174.9683 | 2.502 | -0.1072
5.036 | 3 | 0 | 174.9902 | 174.9463 | 2.166 | -0.1099
6.035 | 3 | 0 | 174.9902 | 174.9683 | 2.296 | -0.0885
7.034 | 3 | 0 | 174.9902 | 174.9463 | 1.119 | -0.0430
8.034 | 3 | 0 | 174.9902 | 174.9902 | 0.605 | -0.0008
9.033 | 3 | 0 | 174.9902 | 174.9463 | 0.655 | -0.0061
10.032 | 3 | 0 | 174.9902 | 174.9243 | -0.043 | 0.0744
11.031 | 3 | 0 | 174.9902 | 174.9683 | -1.127 | 0.0998
12.030 | 3 | 0 | 174.9902 | 174.9683 | -0.687 | 0.0773
13.029 | 3 | 0 | 174.9902 | 175.0122 | -0.288 | -0.0351
14.029 | 3 | 0 | 174.9902 | 175.0562 | 3.569 | -0.3197
15.028 | 3 | 0 | 174.9902 | 174.9902 | 1.208 | -0.1149
16.027 | 3 | 0 | 174.9902 | 175.0122 | -0.987 | 0.0388
17.026 | 3 | 0 | 174.9902 | 174.9683 | 0.552 | -0.0326
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
