AsherNoble/trueskate-ai-hardware/firmware/bench/flick_test/data/flick_2v.csv

F: single flick | +60 deg out and back | voltage_limit 2.00 V
# run=flick voltage_limit=2.00 velocity_limit=50.0 samples=764 rate=1000Hz
t_ms | phase | flick | target_deg | angle_deg | vel_rpm | uq_v
0.040 | 3 | 0 | 175.1441 | 175.1441 | 3.273 | -0.1337
1.001 | 3 | 0 | 175.1441 | 175.1001 | 1.748 | -0.0975
2.000 | 3 | 0 | 175.1441 | 175.1001 | 2.381 | -0.1109
3.038 | 3 | 0 | 175.1441 | 175.1001 | 4.822 | -0.2283
4.037 | 3 | 0 | 175.1441 | 175.0342 | 4.669 | -0.2549
5.037 | 3 | 0 | 175.1441 | 175.0342 | 5.501 | -0.2968
6.036 | 3 | 0 | 175.1441 | 174.8804 | 0.670 | -0.0737
7.035 | 3 | 0 | 175.1441 | 174.8364 | -1.672 | 0.0980
8.035 | 3 | 0 | 175.1441 | 174.8804 | 0.883 | -0.0050
9.034 | 3 | 0 | 175.1441 | 174.8145 | -2.498 | 0.1644
10.034 | 3 | 0 | 175.1441 | 174.8804 | 2.263 | -0.0957
11.033 | 3 | 0 | 175.1441 | 174.8584 | 1.281 | -0.0598
12.032 | 3 | 0 | 175.1441 | 174.9023 | 4.767 | -0.2040
13.032 | 3 | 0 | 175.1441 | 174.9023 | 3.996 | -0.1639
14.031 | 3 | 0 | 175.1441 | 174.7925 | 2.578 | -0.1248
15.031 | 3 | 0 | 175.1441 | 174.7925 | 4.884 | -0.2637
16.030 | 3 | 0 | 175.1441 | 174.7705 | 1.423 | -0.0271
17.029 | 3 | 0 | 175.1441 | 174.7486 | -1.040 | 0.1322
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
