AsherNoble/trueskate-ai-hardware/firmware/bench/flick_test/data/flick_p160_2v.csv

F: single flick | +60 deg out and back | voltage_limit 2.00 V
# run=flick voltage_limit=2.00 velocity_limit=200.0 p_angle=160.0 samples=469 rate=1000Hz
t_ms | phase | flick | target_deg | angle_deg | vel_rpm | uq_v
0.040 | 3 | 0 | 174.9902 | 174.9683 | -1.469 | 0.0102
1.000 | 3 | 0 | 174.9902 | 174.9243 | -2.209 | 0.1879
2.000 | 3 | 0 | 174.9902 | 174.9902 | 0.302 | 0.0051
3.037 | 3 | 0 | 174.9902 | 174.9683 | -0.115 | 0.0189
4.036 | 3 | 0 | 174.9902 | 175.0342 | 1.120 | -0.1278
5.036 | 3 | 0 | 174.9902 | 175.0122 | -1.265 | 0.0533
6.035 | 3 | 0 | 174.9902 | 174.9902 | -0.404 | 0.0161
7.034 | 3 | 0 | 174.9902 | 175.0122 | 0.495 | -0.0806
8.033 | 3 | 0 | 174.9902 | 174.9683 | -0.783 | 0.0051
9.032 | 3 | 0 | 174.9902 | 174.9902 | -0.534 | -0.0068
10.032 | 3 | 0 | 174.9902 | 175.0122 | 0.114 | 0.0050
11.031 | 3 | 0 | 174.9902 | 174.9902 | 0.433 | -0.0051
12.030 | 3 | 0 | 174.9902 | 174.9902 | -0.634 | 0.0505
13.029 | 3 | 0 | 174.9902 | 174.9683 | -0.505 | 0.0499
14.028 | 3 | 0 | 174.9902 | 175.0122 | -1.010 | 0.0160
15.028 | 3 | 0 | 174.9902 | 175.0342 | -3.128 | 0.1203
16.027 | 3 | 0 | 174.9902 | 174.9902 | -3.818 | 0.1501
17.026 | 3 | 0 | 174.9902 | 175.0781 | -0.610 | -0.0374
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
