AsherNoble/trueskate-ai-hardware/firmware/bench/flick_test/data/flick_p160_4v.csv

F: single flick | +60 deg out and back | voltage_limit 4.00 V
# run=flick voltage_limit=4.00 velocity_limit=200.0 p_angle=160.0 samples=441 rate=1000Hz
t_ms | phase | flick | target_deg | angle_deg | vel_rpm | uq_v
0.039 | 3 | 0 | 175.1001 | 175.1001 | 0.072 | -0.0127
1.000 | 3 | 0 | 175.1001 | 175.1221 | -1.544 | 0.0535
2.038 | 3 | 0 | 175.1001 | 175.1221 | -0.724 | 0.0457
3.037 | 3 | 0 | 175.1001 | 175.1441 | 0.956 | -0.0840
4.036 | 3 | 0 | 175.1001 | 175.1441 | 1.923 | -0.1501
5.035 | 3 | 0 | 175.1001 | 175.1221 | 0.636 | -0.0781
6.034 | 3 | 0 | 175.1001 | 175.1001 | 0.158 | -0.0298
7.033 | 3 | 0 | 175.1001 | 175.1001 | 0.455 | -0.0401
8.033 | 3 | 0 | 175.1001 | 175.1221 | 0.047 | -0.0227
9.032 | 3 | 0 | 175.1001 | 175.0562 | -1.515 | 0.1271
10.031 | 3 | 0 | 175.1001 | 175.1880 | 1.051 | -0.0907
11.030 | 3 | 0 | 175.1001 | 175.1001 | -1.871 | 0.1119
12.029 | 3 | 0 | 175.1001 | 175.1441 | 2.555 | -0.2041
13.029 | 3 | 0 | 175.1001 | 175.1660 | 2.625 | -0.1944
14.028 | 3 | 0 | 175.1001 | 175.0781 | 0.541 | 0.0471
15.027 | 3 | 0 | 175.1001 | 175.0781 | 2.716 | -0.1334
16.026 | 3 | 0 | 175.1001 | 175.0562 | 0.133 | 0.0297
17.025 | 3 | 0 | 175.1001 | 175.0342 | 1.892 | -0.0504
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
