AsherNoble/trueskate-ai-hardware/firmware/bench/flick_test/data/flick_p160_6v.csv

F: single flick | +60 deg out and back | voltage_limit 6.00 V
# run=flick voltage_limit=6.00 velocity_limit=200.0 p_angle=160.0 samples=446 rate=1000Hz
t_ms | phase | flick | target_deg | angle_deg | vel_rpm | uq_v
0.040 | 3 | 0 | 175.1441 | 175.1441 | 0.017 | -0.3146
1.001 | 3 | 0 | 175.1441 | 175.1221 | 0.095 | 0.0297
2.000 | 3 | 0 | 175.1441 | 175.1441 | -1.713 | 0.1031
3.038 | 3 | 0 | 175.1441 | 175.1001 | -3.943 | 0.1898
4.037 | 3 | 0 | 175.1441 | 175.1660 | -4.081 | 0.2272
5.036 | 3 | 0 | 175.1441 | 175.1880 | -0.626 | -0.0642
6.036 | 3 | 0 | 175.1441 | 175.2319 | -3.530 | 0.1440
7.035 | 3 | 0 | 175.1441 | 175.2319 | -5.449 | 0.1617
8.034 | 3 | 0 | 175.1441 | 175.2979 | -1.042 | -0.1239
9.033 | 3 | 0 | 175.1441 | 175.3418 | 1.658 | -0.3317
10.032 | 3 | 0 | 175.1441 | 175.2979 | 0.123 | -0.1937
11.032 | 3 | 0 | 175.1441 | 175.1660 | -2.335 | 0.0554
12.031 | 3 | 0 | 175.1441 | 175.2100 | 1.538 | -0.2142
13.030 | 3 | 0 | 175.1441 | 175.1880 | -1.430 | 0.0929
14.030 | 3 | 0 | 175.1441 | 175.1221 | 1.554 | -0.1851
15.029 | 3 | 0 | 175.1441 | 175.1001 | -7.725 | 0.4658
16.028 | 3 | 0 | 175.1441 | 175.1880 | -1.803 | 0.0190
17.027 | 3 | 0 | 175.1441 | 175.2979 | 0.229 | -0.2045
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
