AsherNoble/trueskate-ai-hardware/firmware/bench/flick_test/data/flick20_2v.png

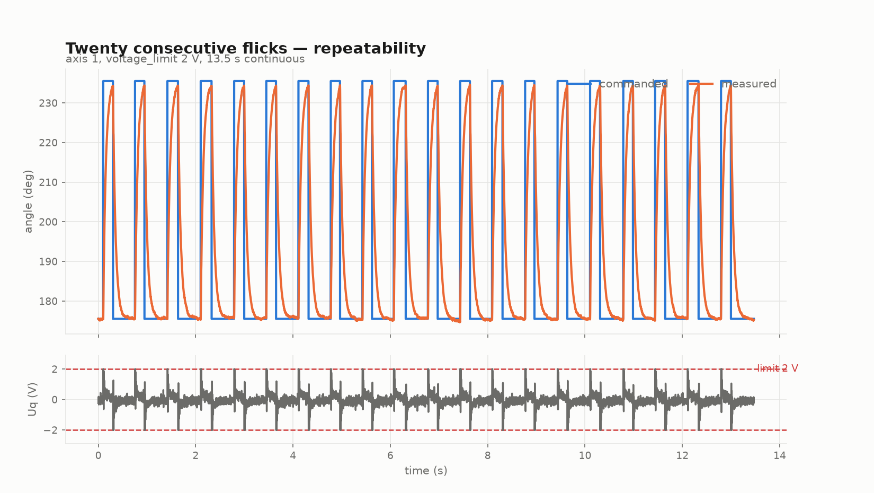
firmware/bench/flick_test/data/flick20_2v.png
