AsherNoble/trueskate-ai-hardware/firmware/bench/flick_test/data/flick_1_vs_20_p160.png

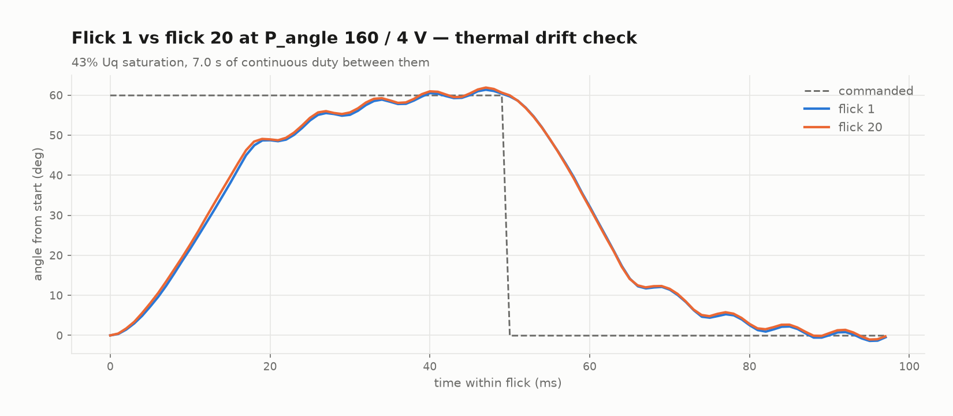
firmware/bench/flick_test/data/flick_1_vs_20_p160.png
