AsherNoble/trueskate-ai-hardware/firmware/bench/flick_test/data/flick_2v.png

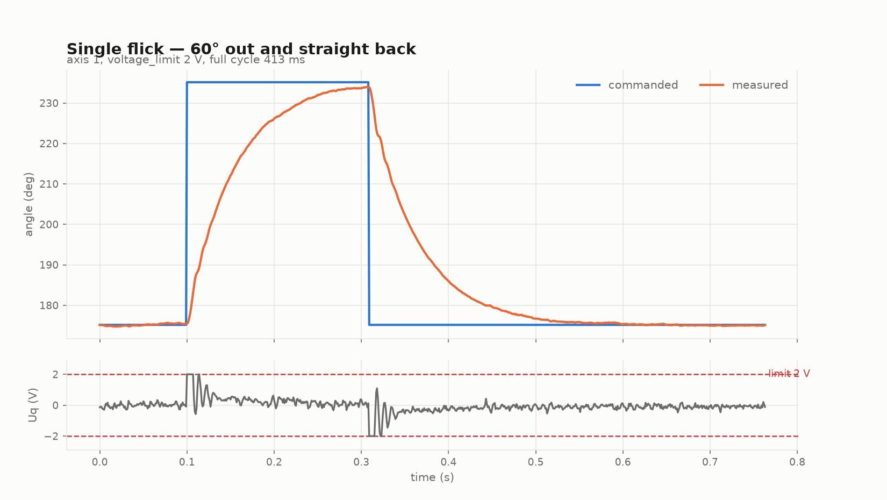
firmware/bench/flick_test/data/flick_2v.png
