AsherNoble/trueskate-ai-hardware/firmware/bench/flick_test/data/flick_p40_2v.png

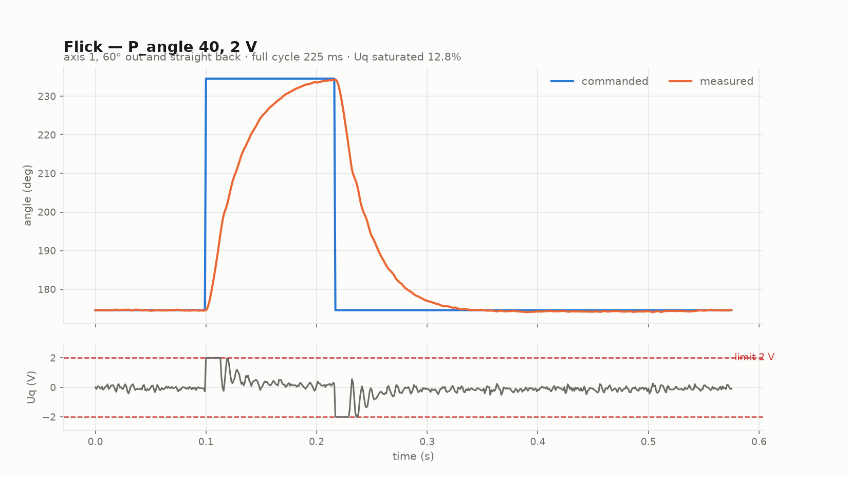
firmware/bench/flick_test/data/flick_p40_2v.png
