AsherNoble/trueskate-ai-hardware/firmware/bench/flick_test/data/flick_p40_4v.png

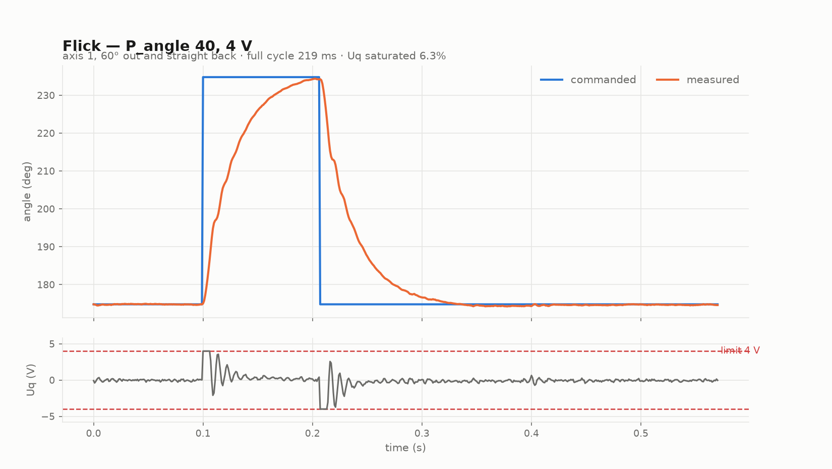
firmware/bench/flick_test/data/flick_p40_4v.png
