AsherNoble/trueskate-ai-hardware/firmware/bench/flick_test/data/flick_p160_2v.png

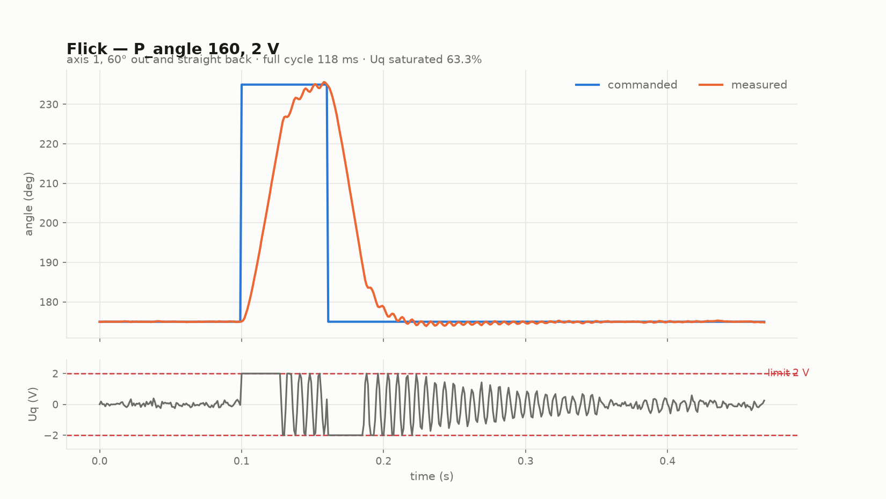
firmware/bench/flick_test/data/flick_p160_2v.png
