AsherNoble/trueskate-ai-hardware/firmware/bench/flick_test/data/flick_p160_4v.png

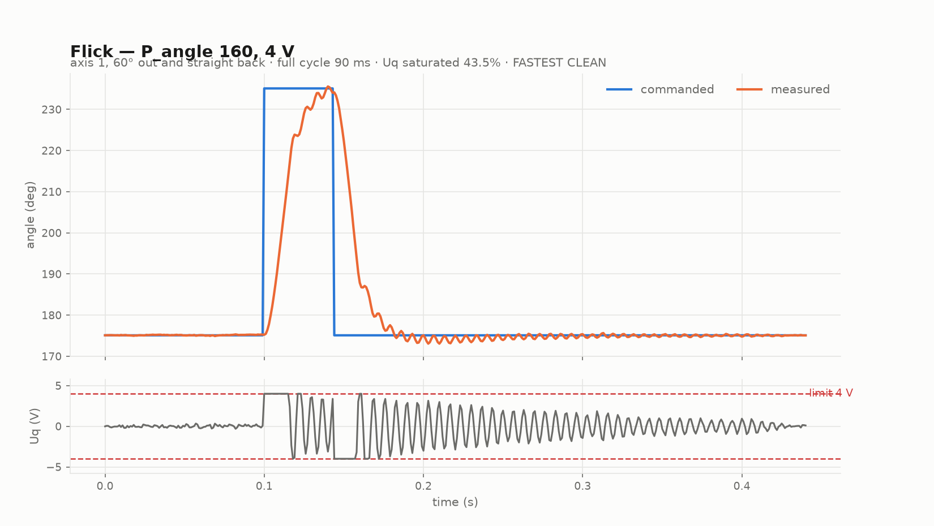
firmware/bench/flick_test/data/flick_p160_4v.png
