AsherNoble/trueskate-ai-hardware/firmware/bench/flick_test/data/sweep_overlay.png

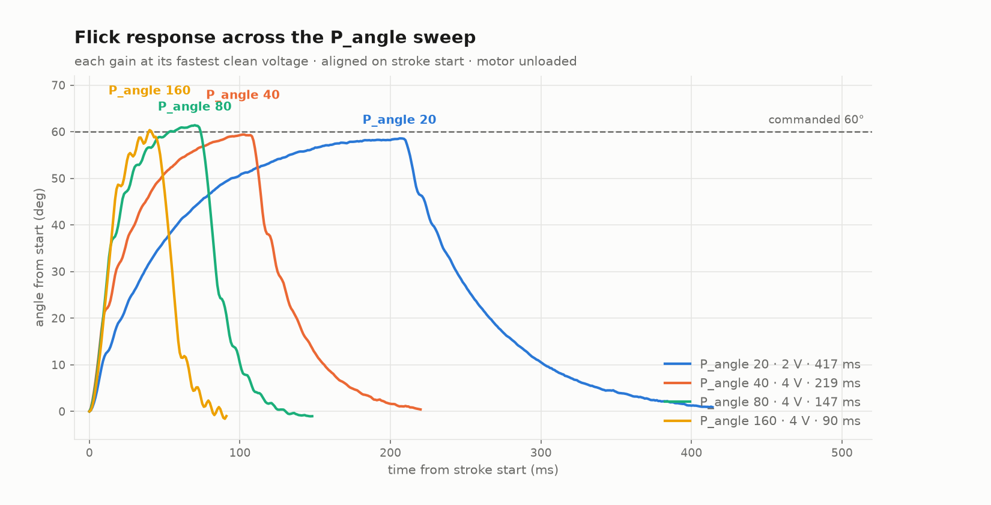
firmware/bench/flick_test/data/sweep_overlay.png
