AsherNoble/trueskate-ai-hardware/pcb/sources/copper-evaluation/stackup-light.png

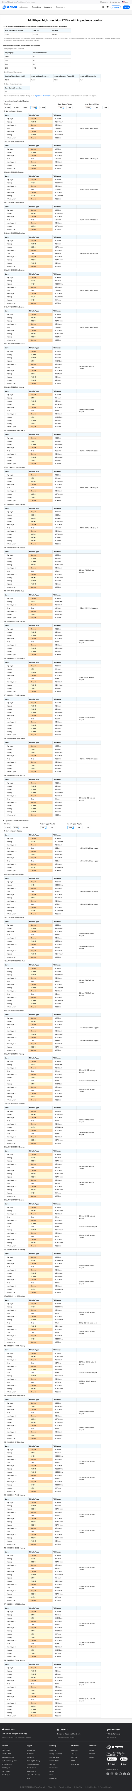
pcb/sources/copper-evaluation/stackup-light.png
