AsherNoble/trueskate-ai-hardware/pcb/mechanical-fit-review.pdf

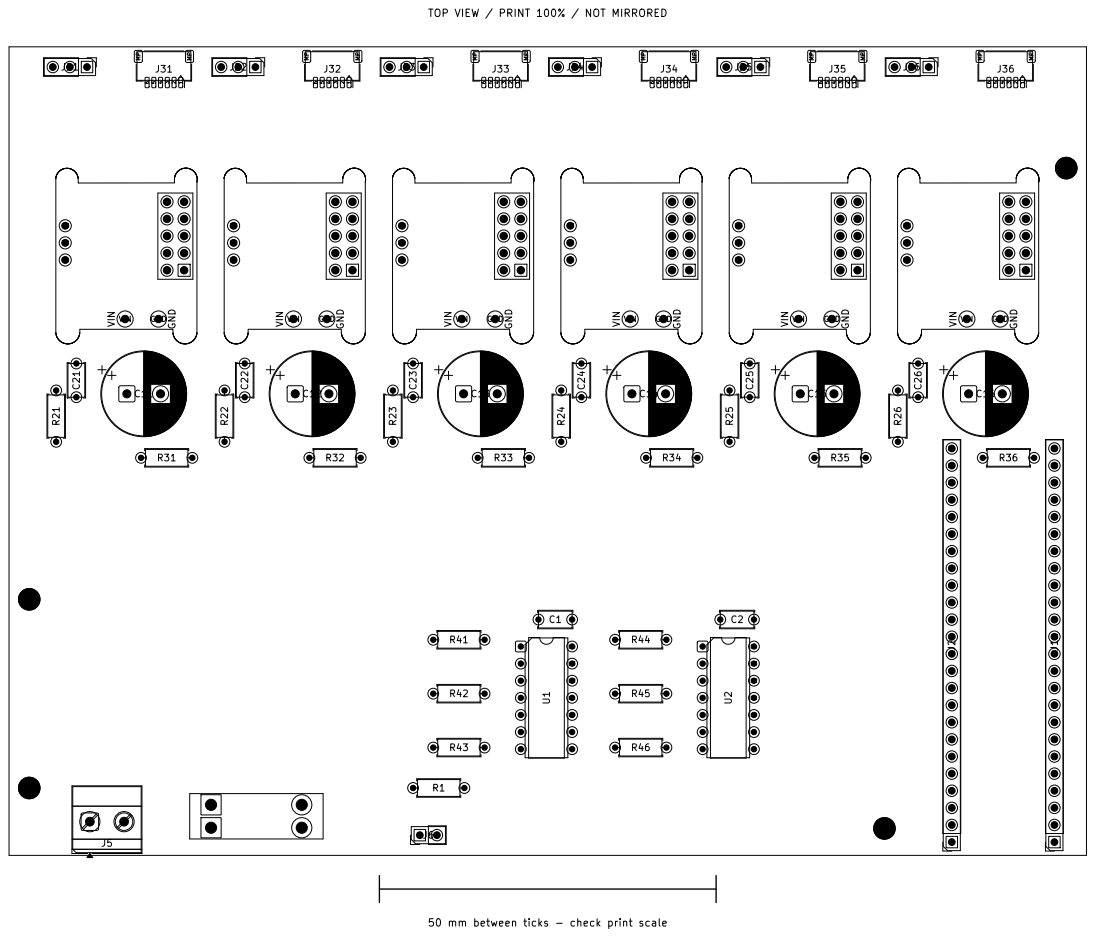
[picture p41: page 1]

50 mm between ticks - check print scale
