AsherNoble/trueskate-ai-hardware/pcb/schematic-review.pdf

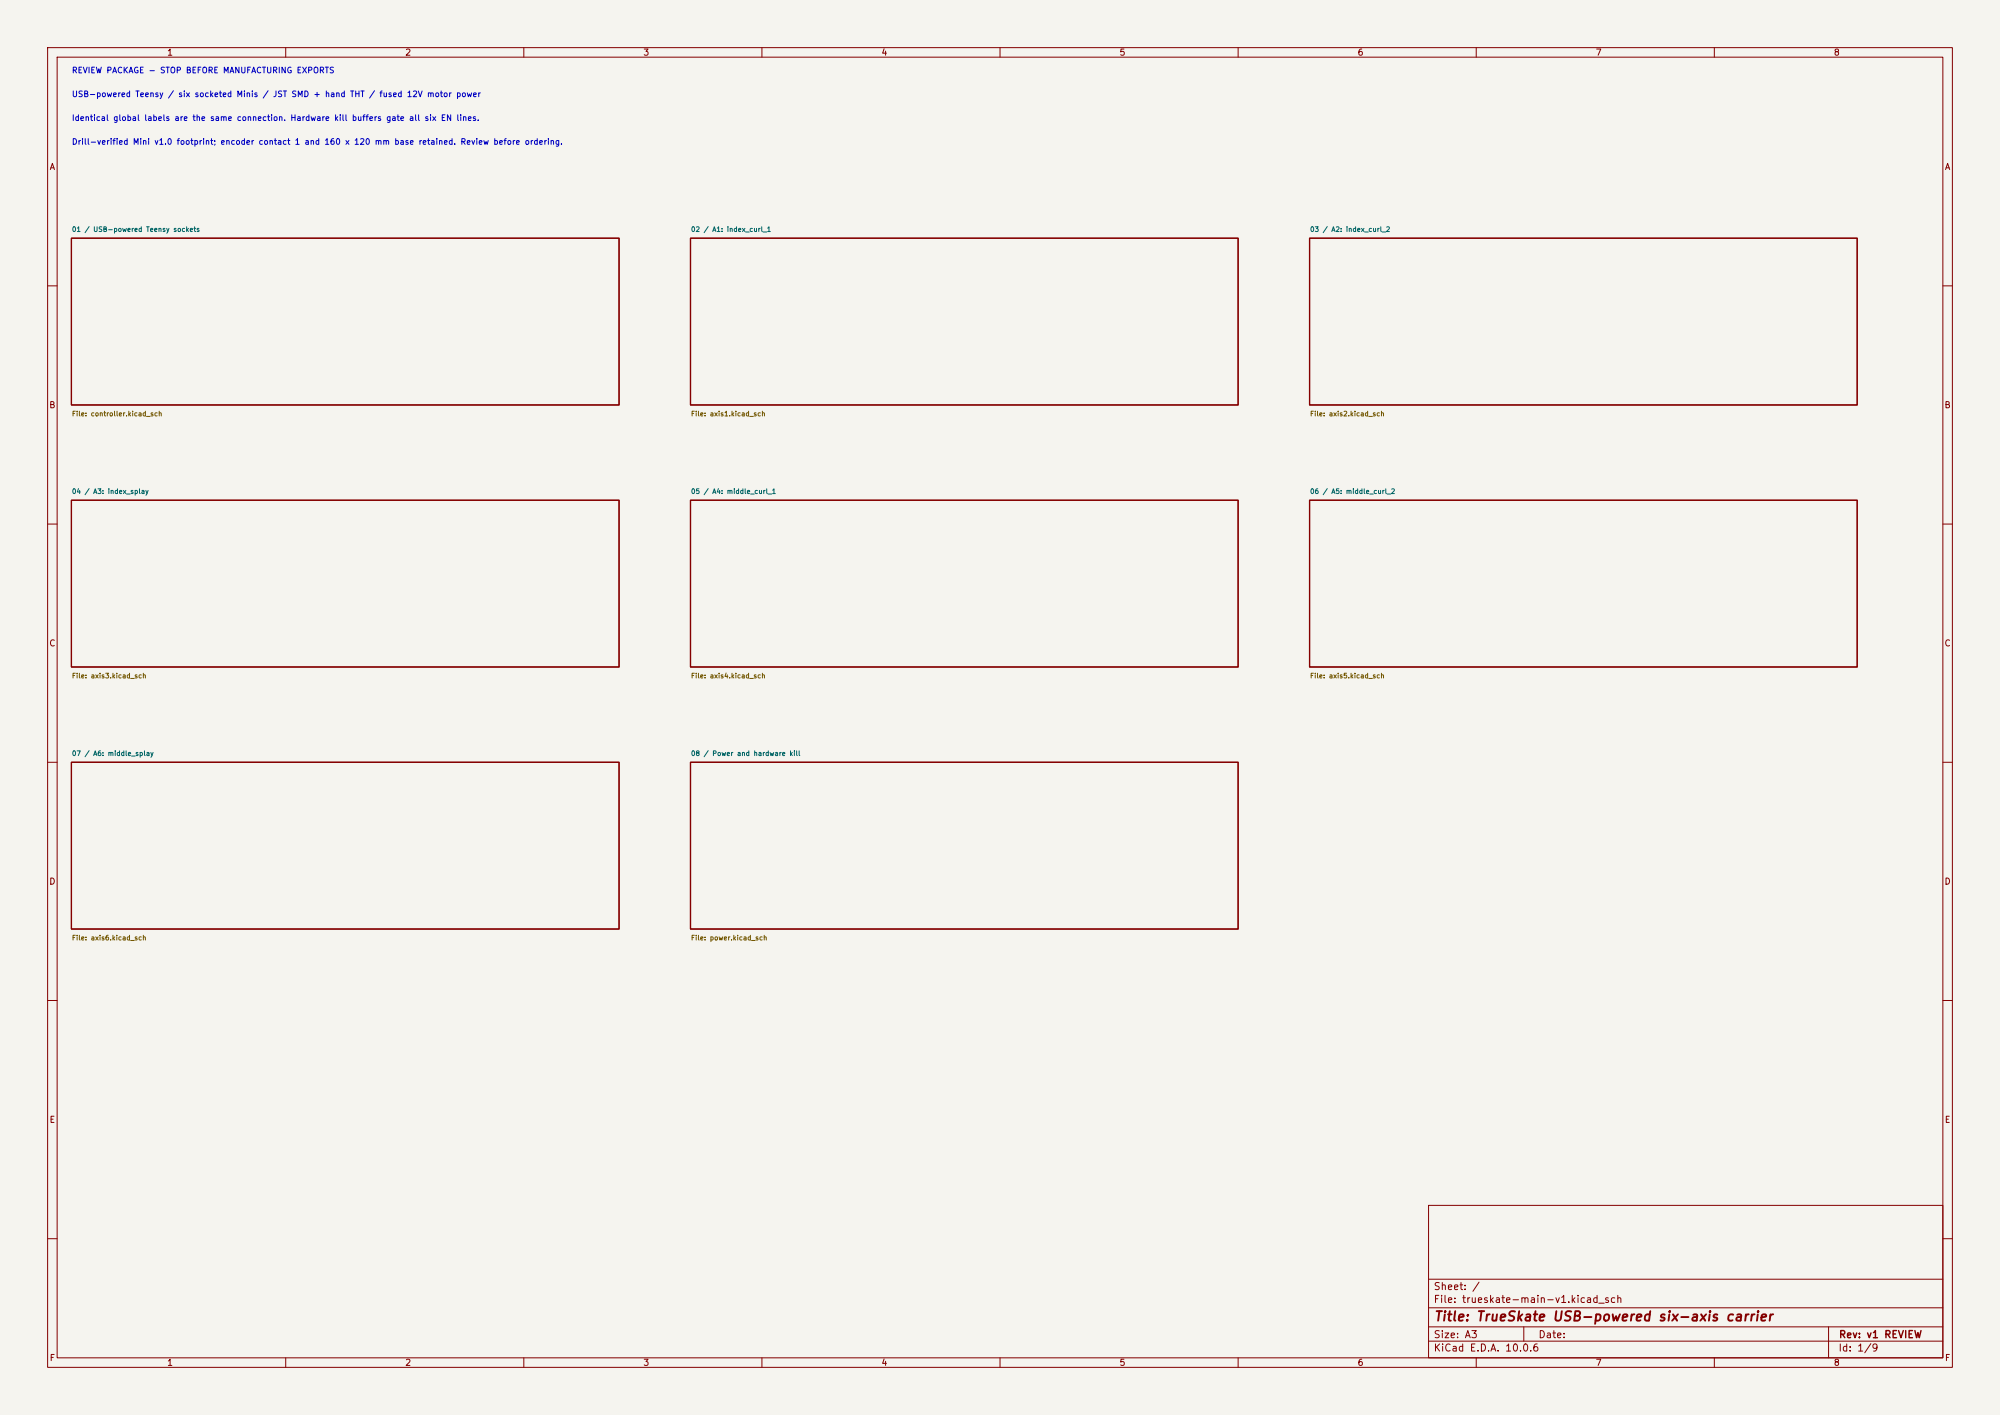
[picture p42: page 1]

01 / USB-powered Teensy sockets File: controller.kicad_sch 04 / A3: index_splay File: axis3.kicad_sch 07 / A6: middle_splay File: axis6.kicad_sch

REVIEW PACKAGE - STOP BEFORE MANUFACTURING EXPORTS USB-powered Teensy / six socketed Minis / JST SMD + hand THT / fused 12V motor power

Identical global labels are the same connection. Hardware kill buffers gate all six EN lines. Drill-verified Mini v1.0 footprint; encoder contact 1 and 160 x 120 mm base retained. Review before ordering.

File: axis5.kicad_sch 08 / Power and hardware kill File: power.kicad_sch

Sheet: /
File: trueskate-main-v1.kicad_sch
Title: TrueSkate USB-powered six-axis carrier

Size: A3 | Rev: v1 REVIEW | F Date:
KiCad E.D.A. 10.0.6 | Id: 1/9

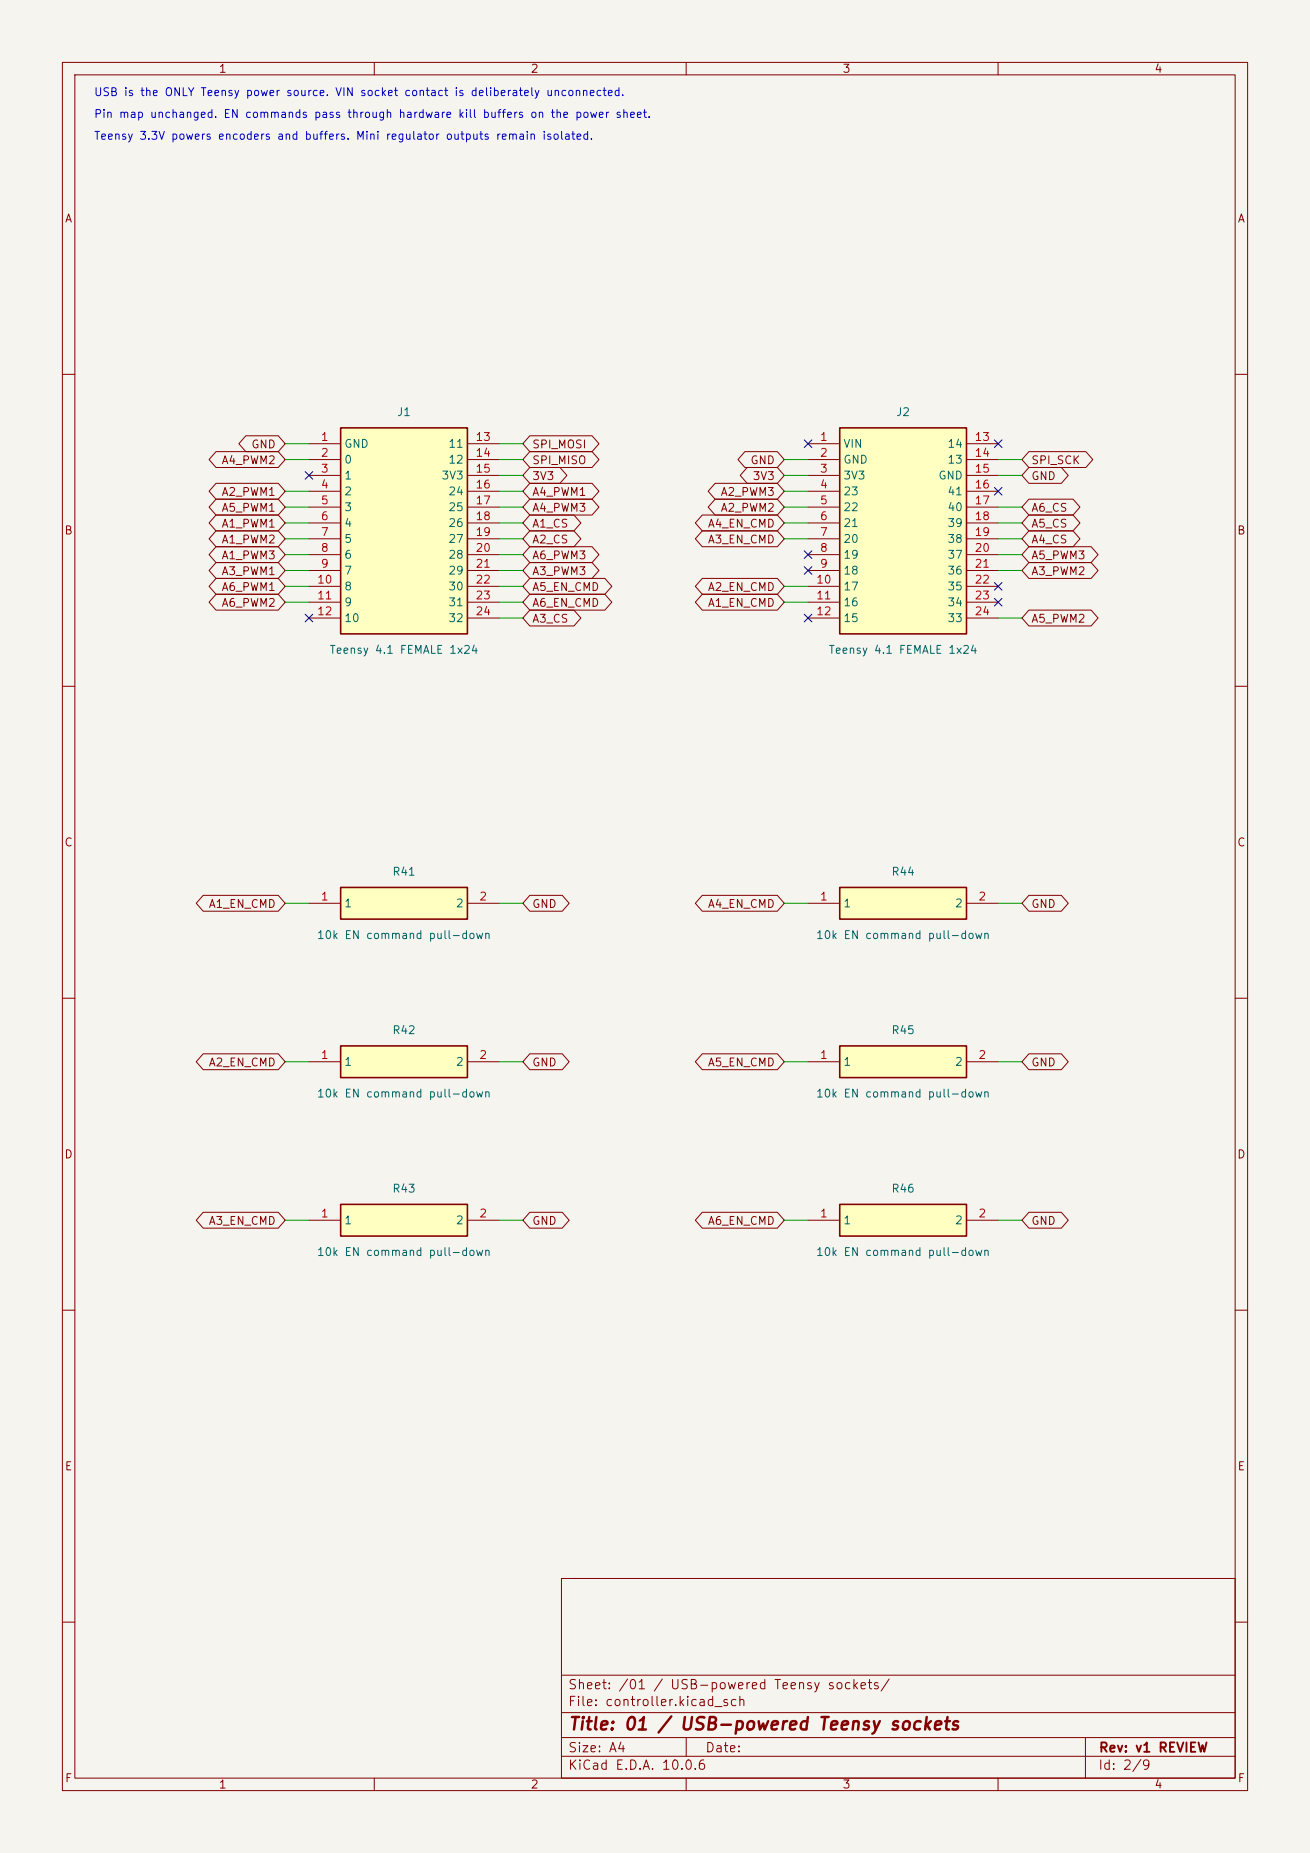
[picture p43: page 2]

A4_CS USB is the ONLY Teensy power source. VIN socket contact is deliberately unconnected. Pin map unchanged. EN commands pass through hardware kill buffers on the power sheet. Teensy 3.3V powers encoders and buffers. Mini regulator outputs remain isolated.

10k EN command pull-down 1

10k EN command pull-down

Sheet: /01 / USB-powered Teensy sockets/
File: controller.kicad_sch
Title: 01 / USB-powered Teensy sockets

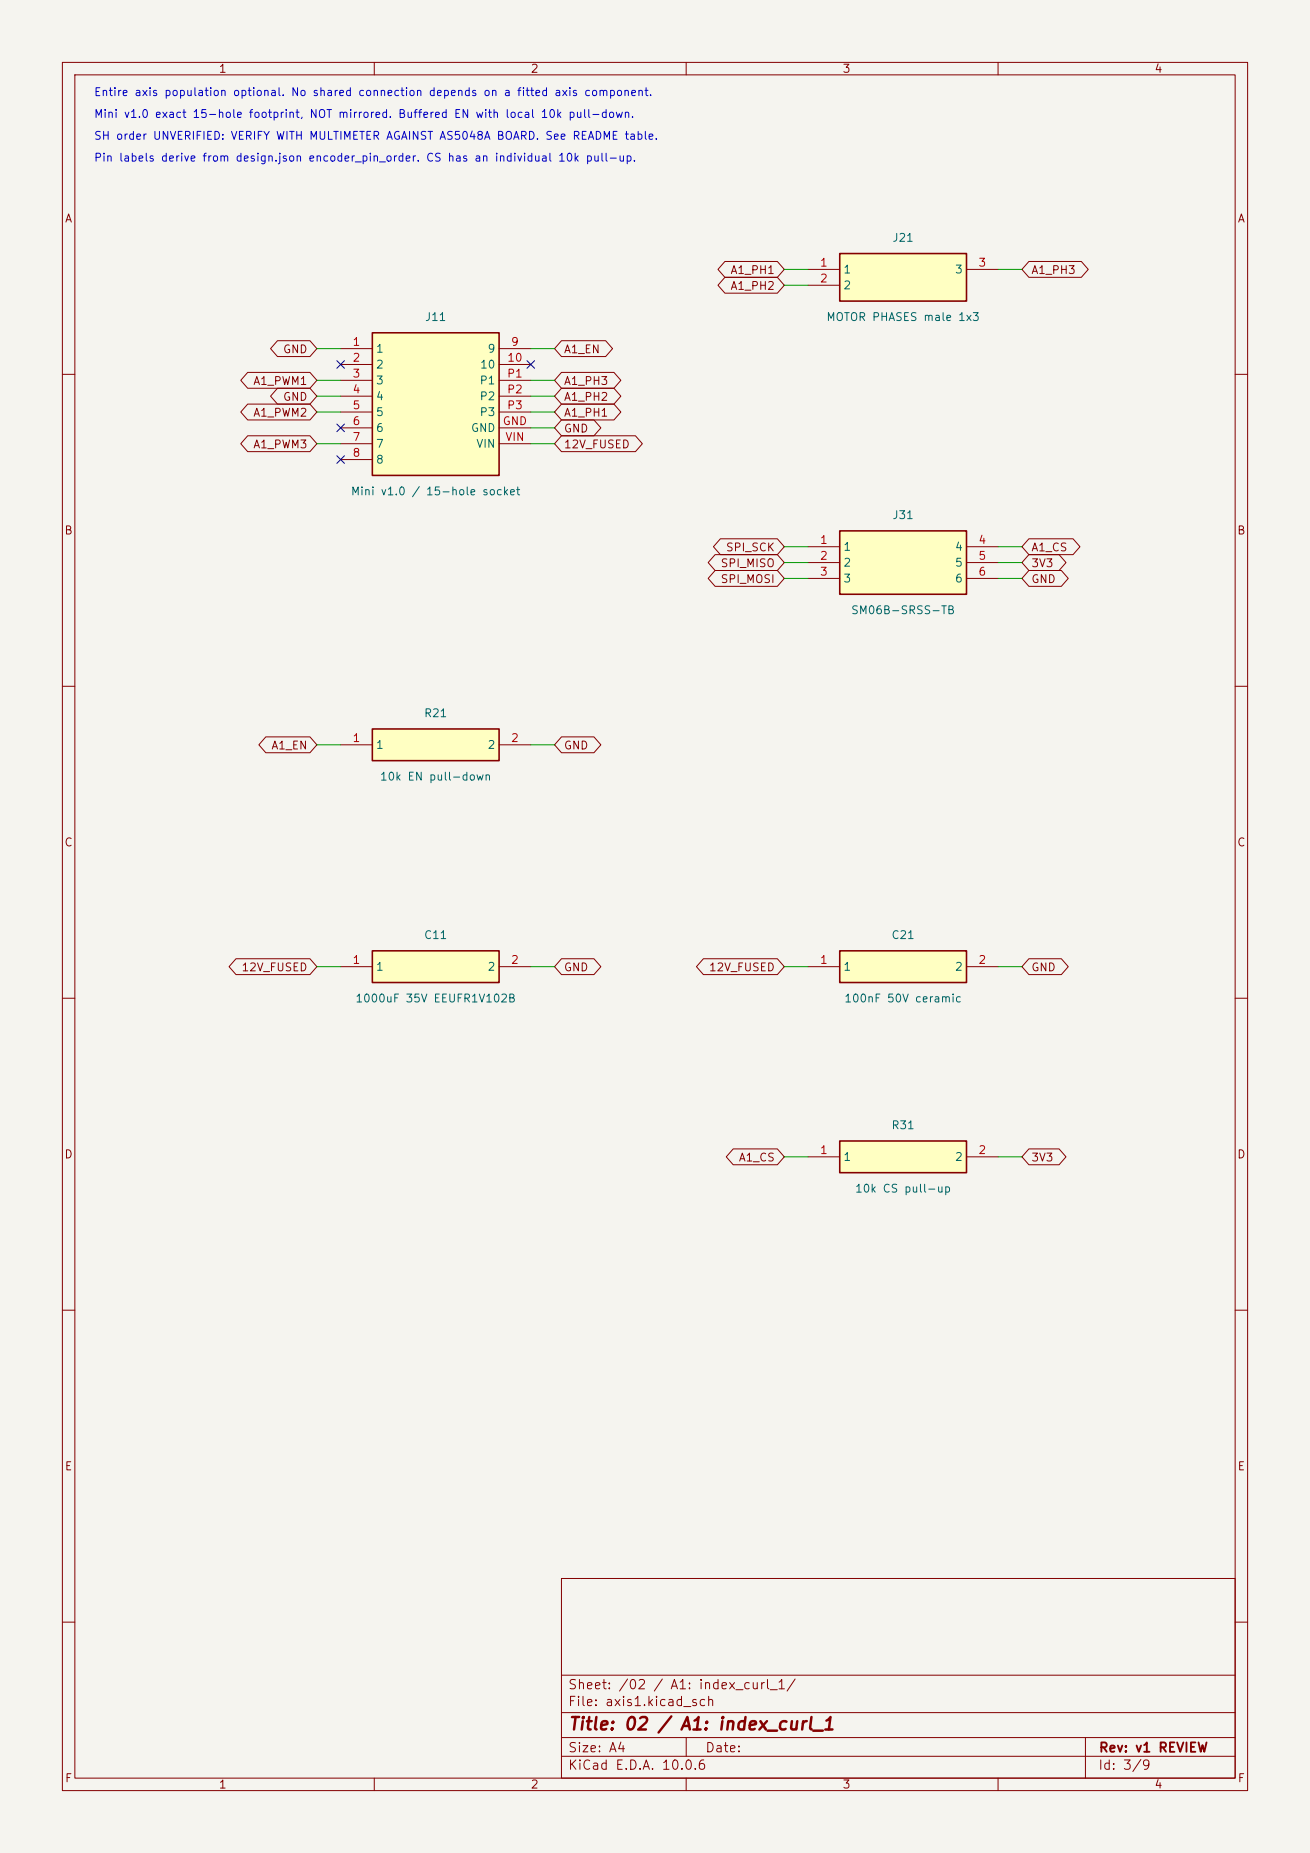
[picture p44: page 3]

Pin labels derive from design.json encoder_pin_order. CS has an individual 10k pull-up. SH order UNVERIFIED: VERIFY WITH MULTIMETER AGAINST AS5048A BOARD. See README table. Mini v1.0 exact 15-hole footprint, NOT mirrored. Buffered EN with local 10k pull-down. Entire axis population optional. No shared connection depends on a fitted axis component.
A1_PH2 GND

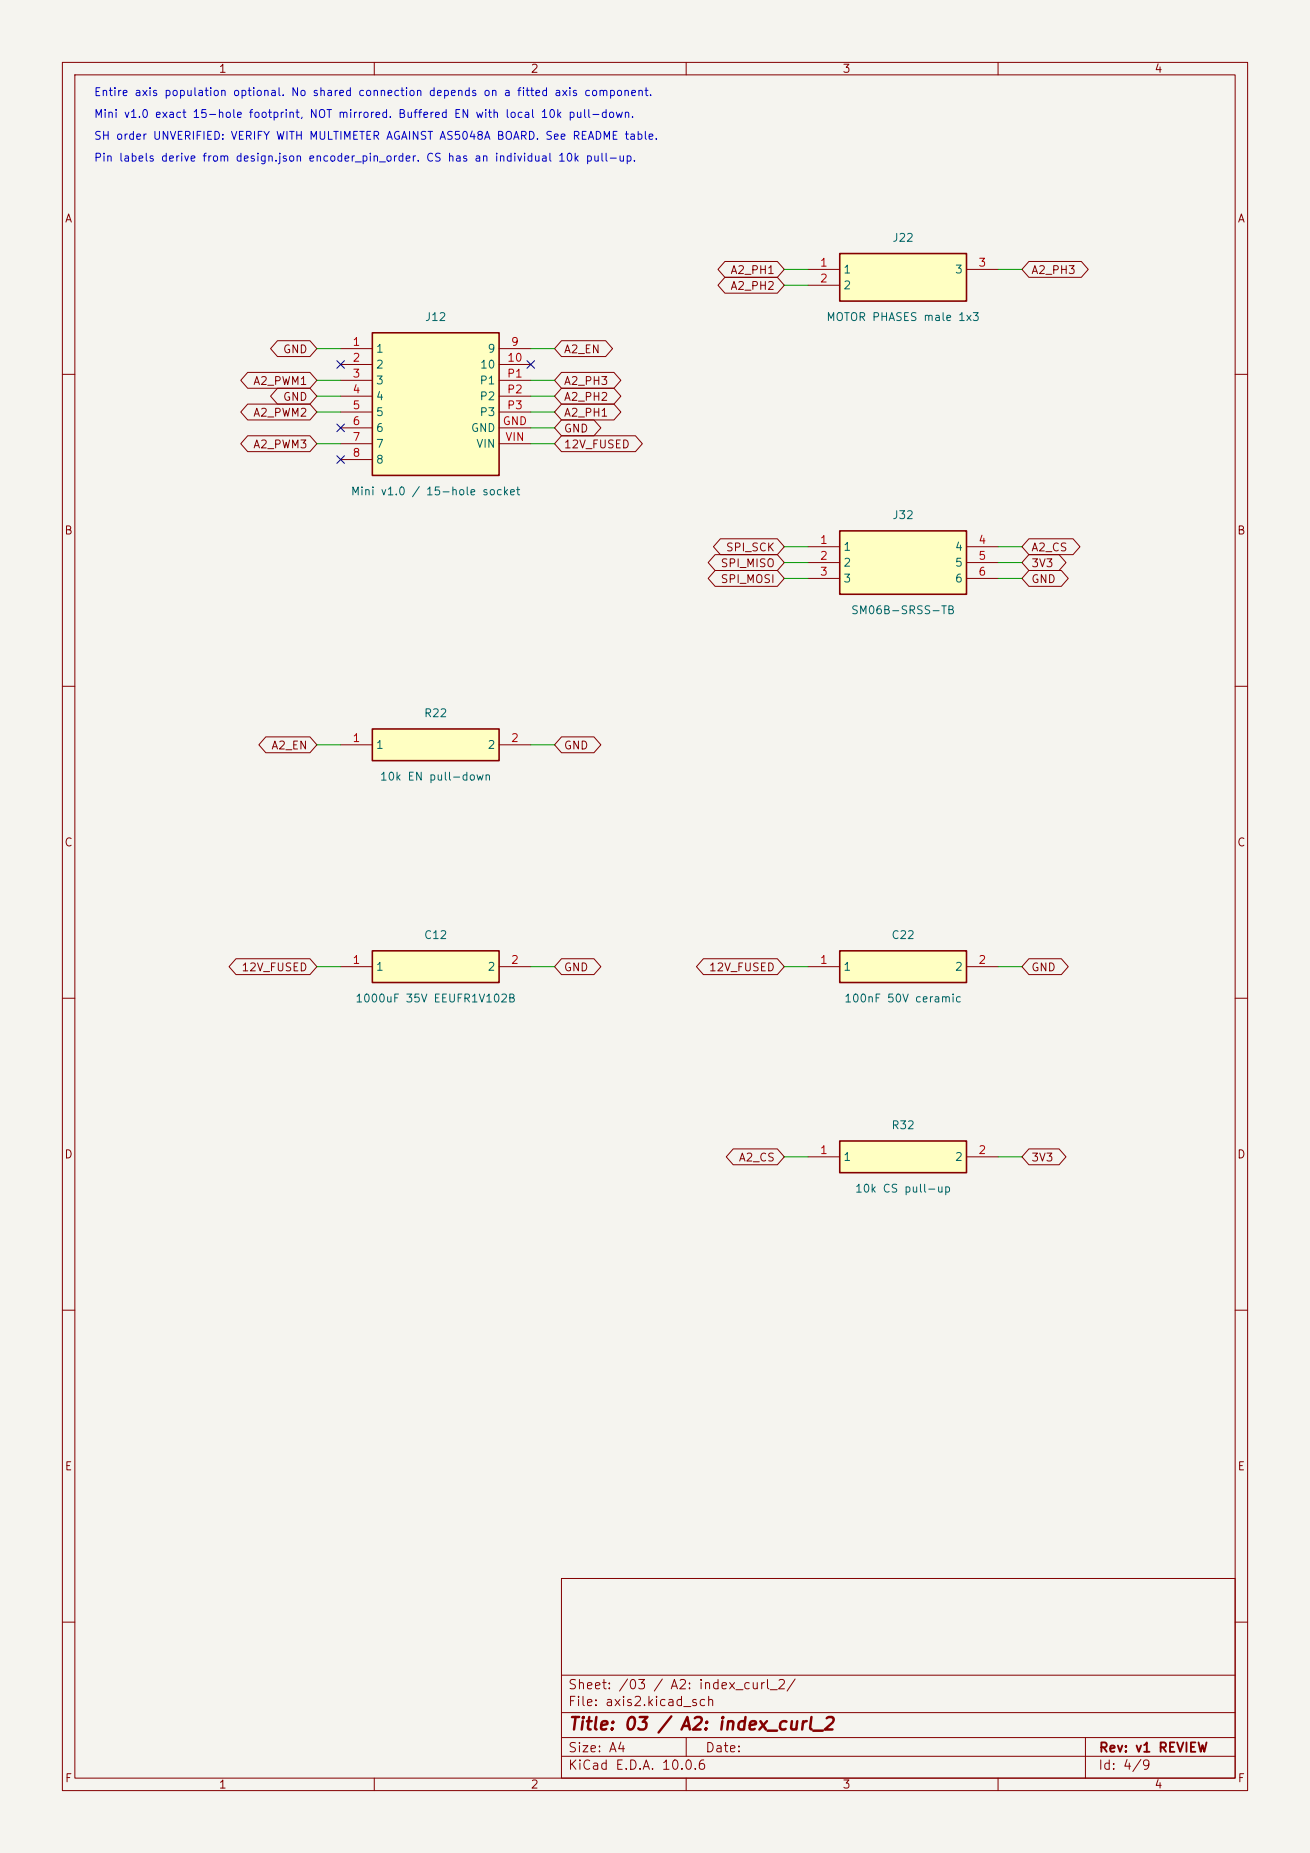
[picture p45: page 4]

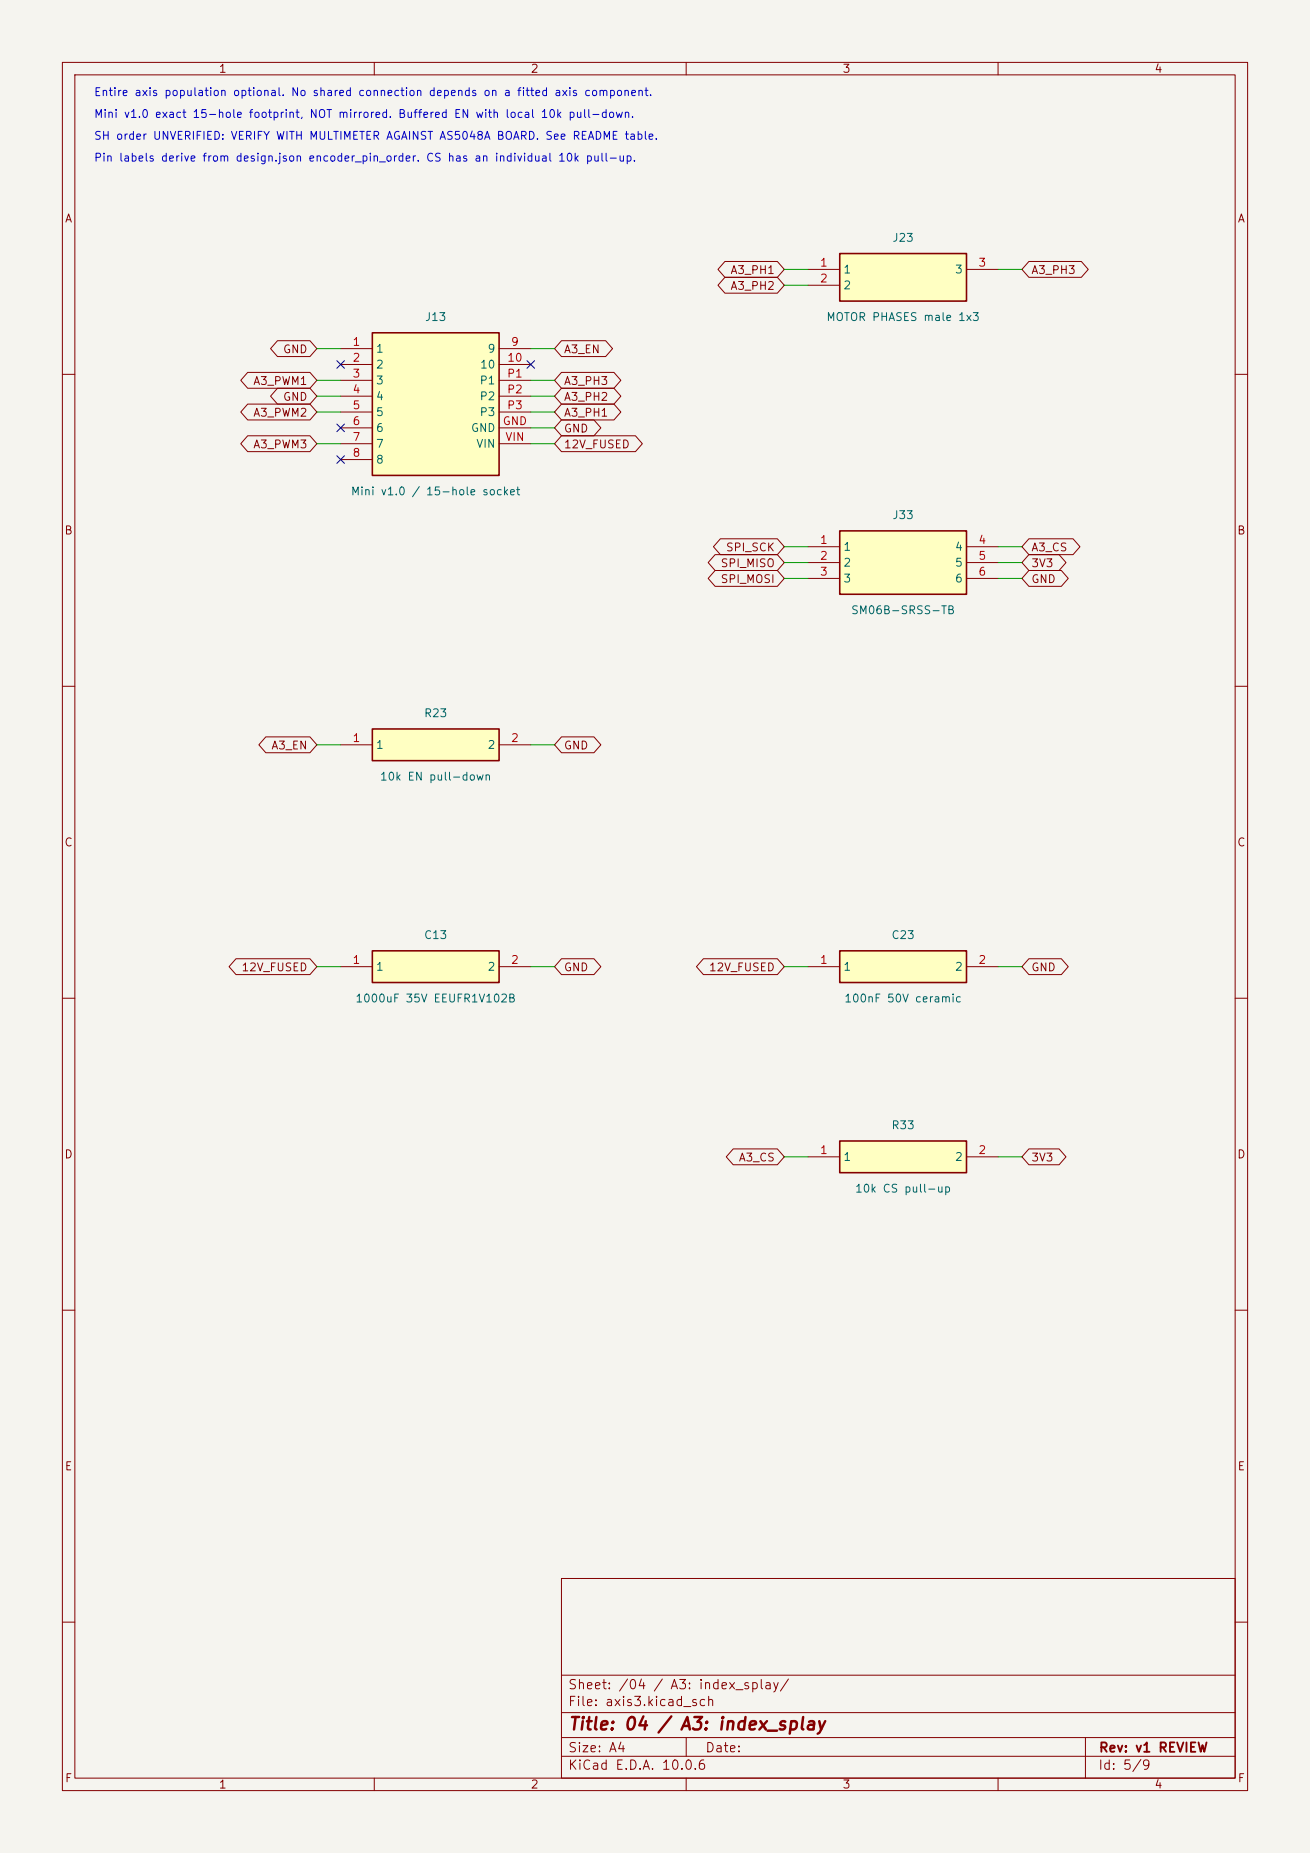
[picture p46: page 5]

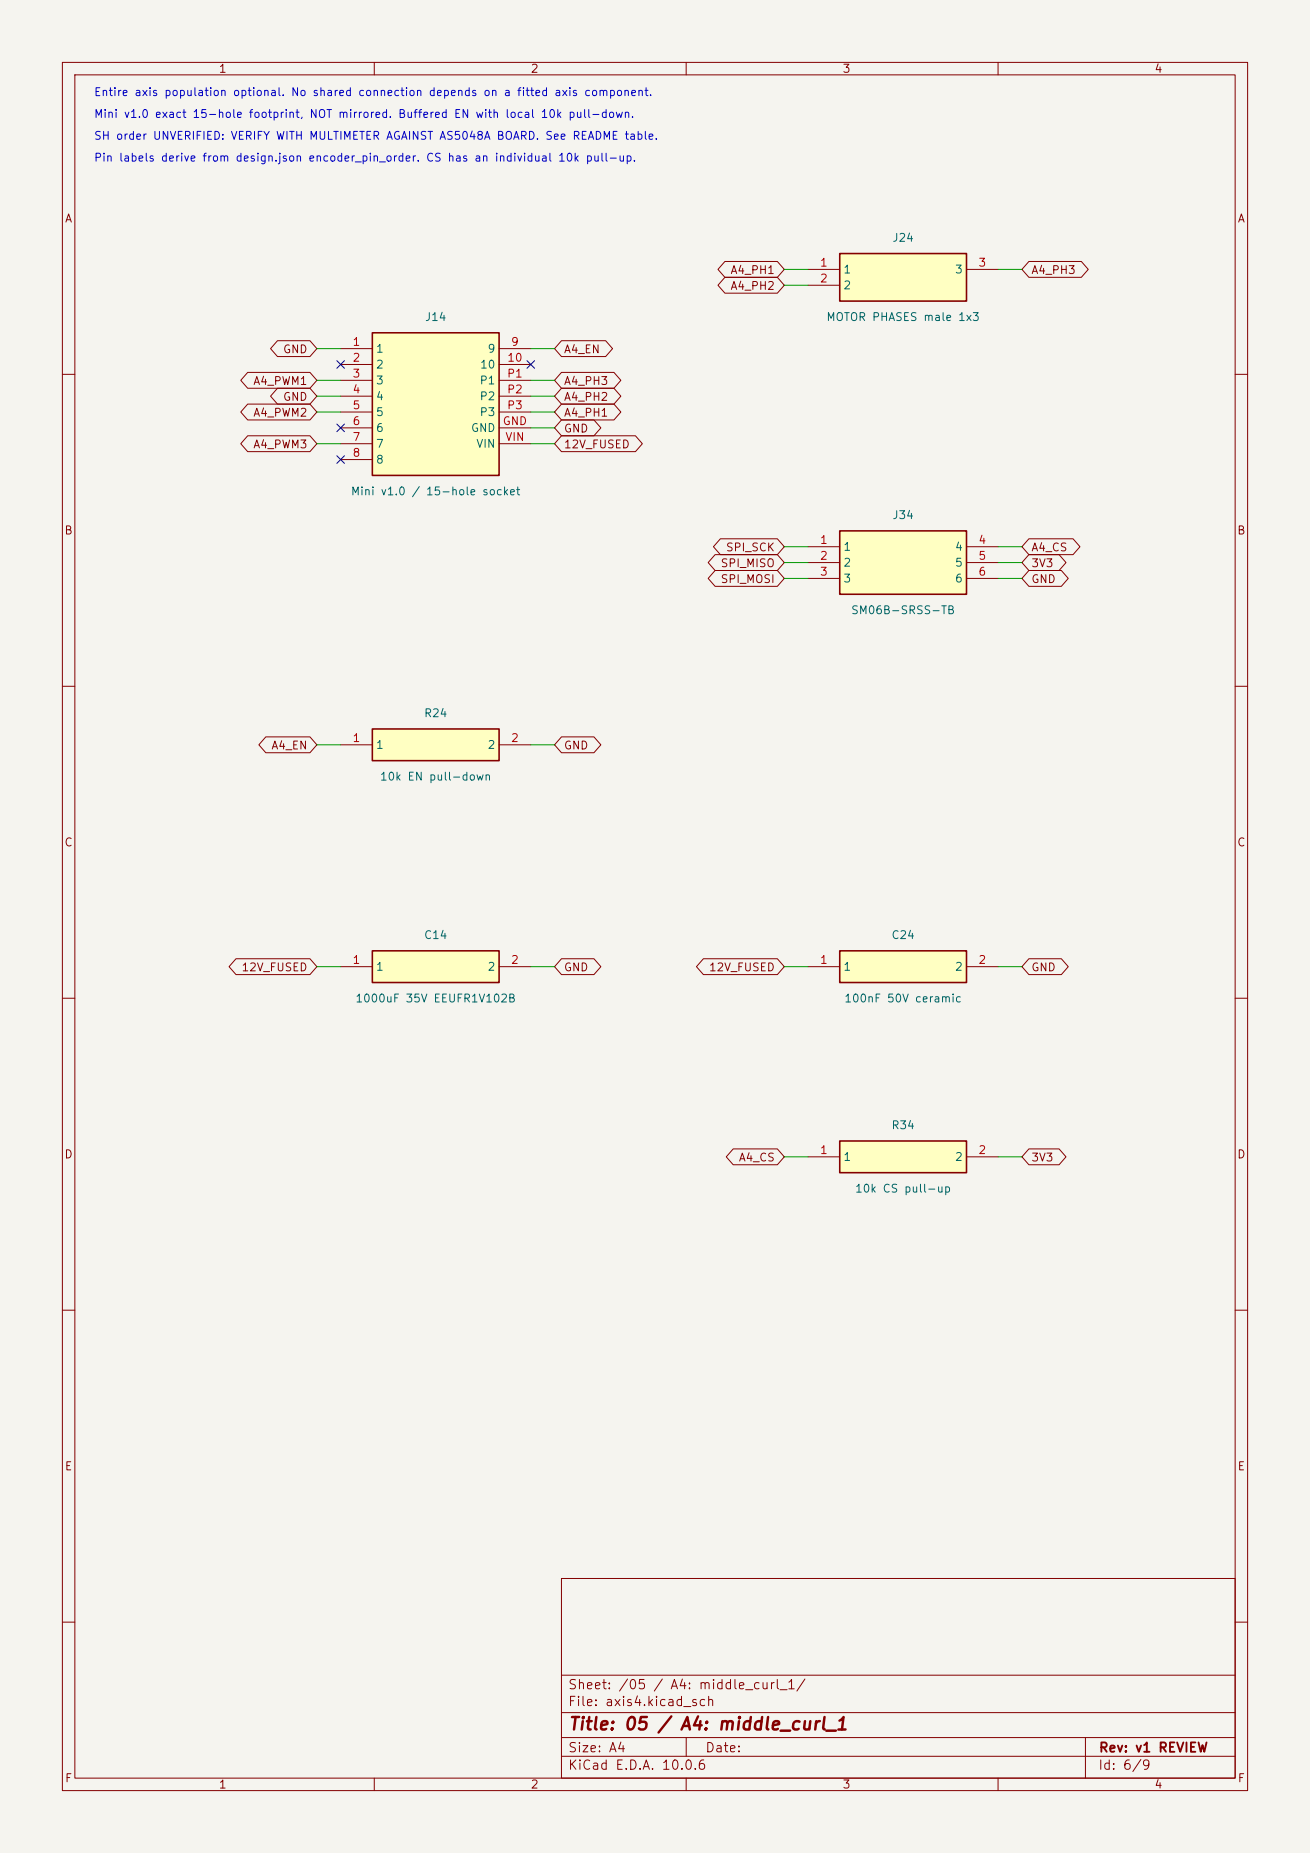
[picture p47: page 6]

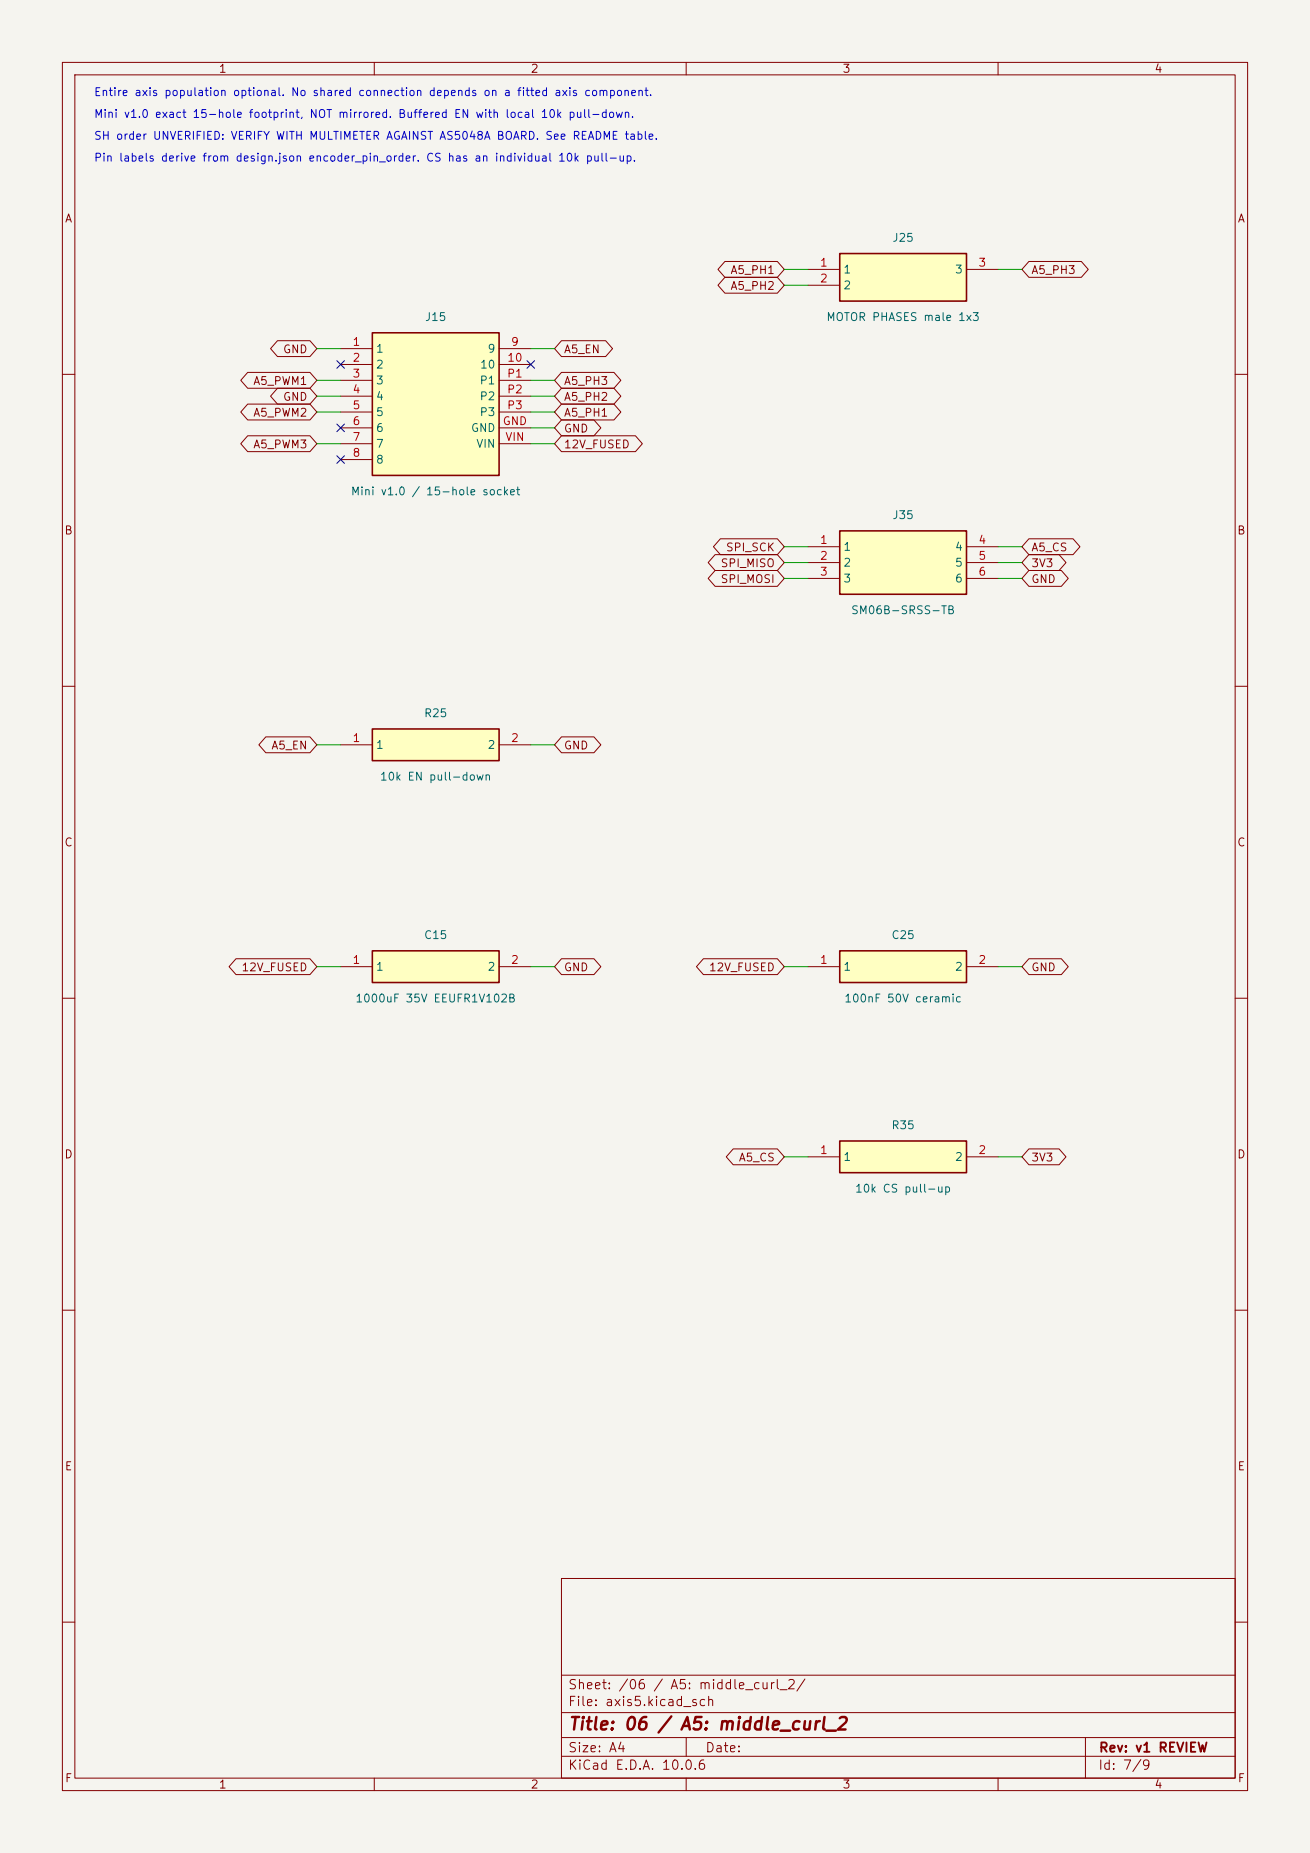
[picture p48: page 7]

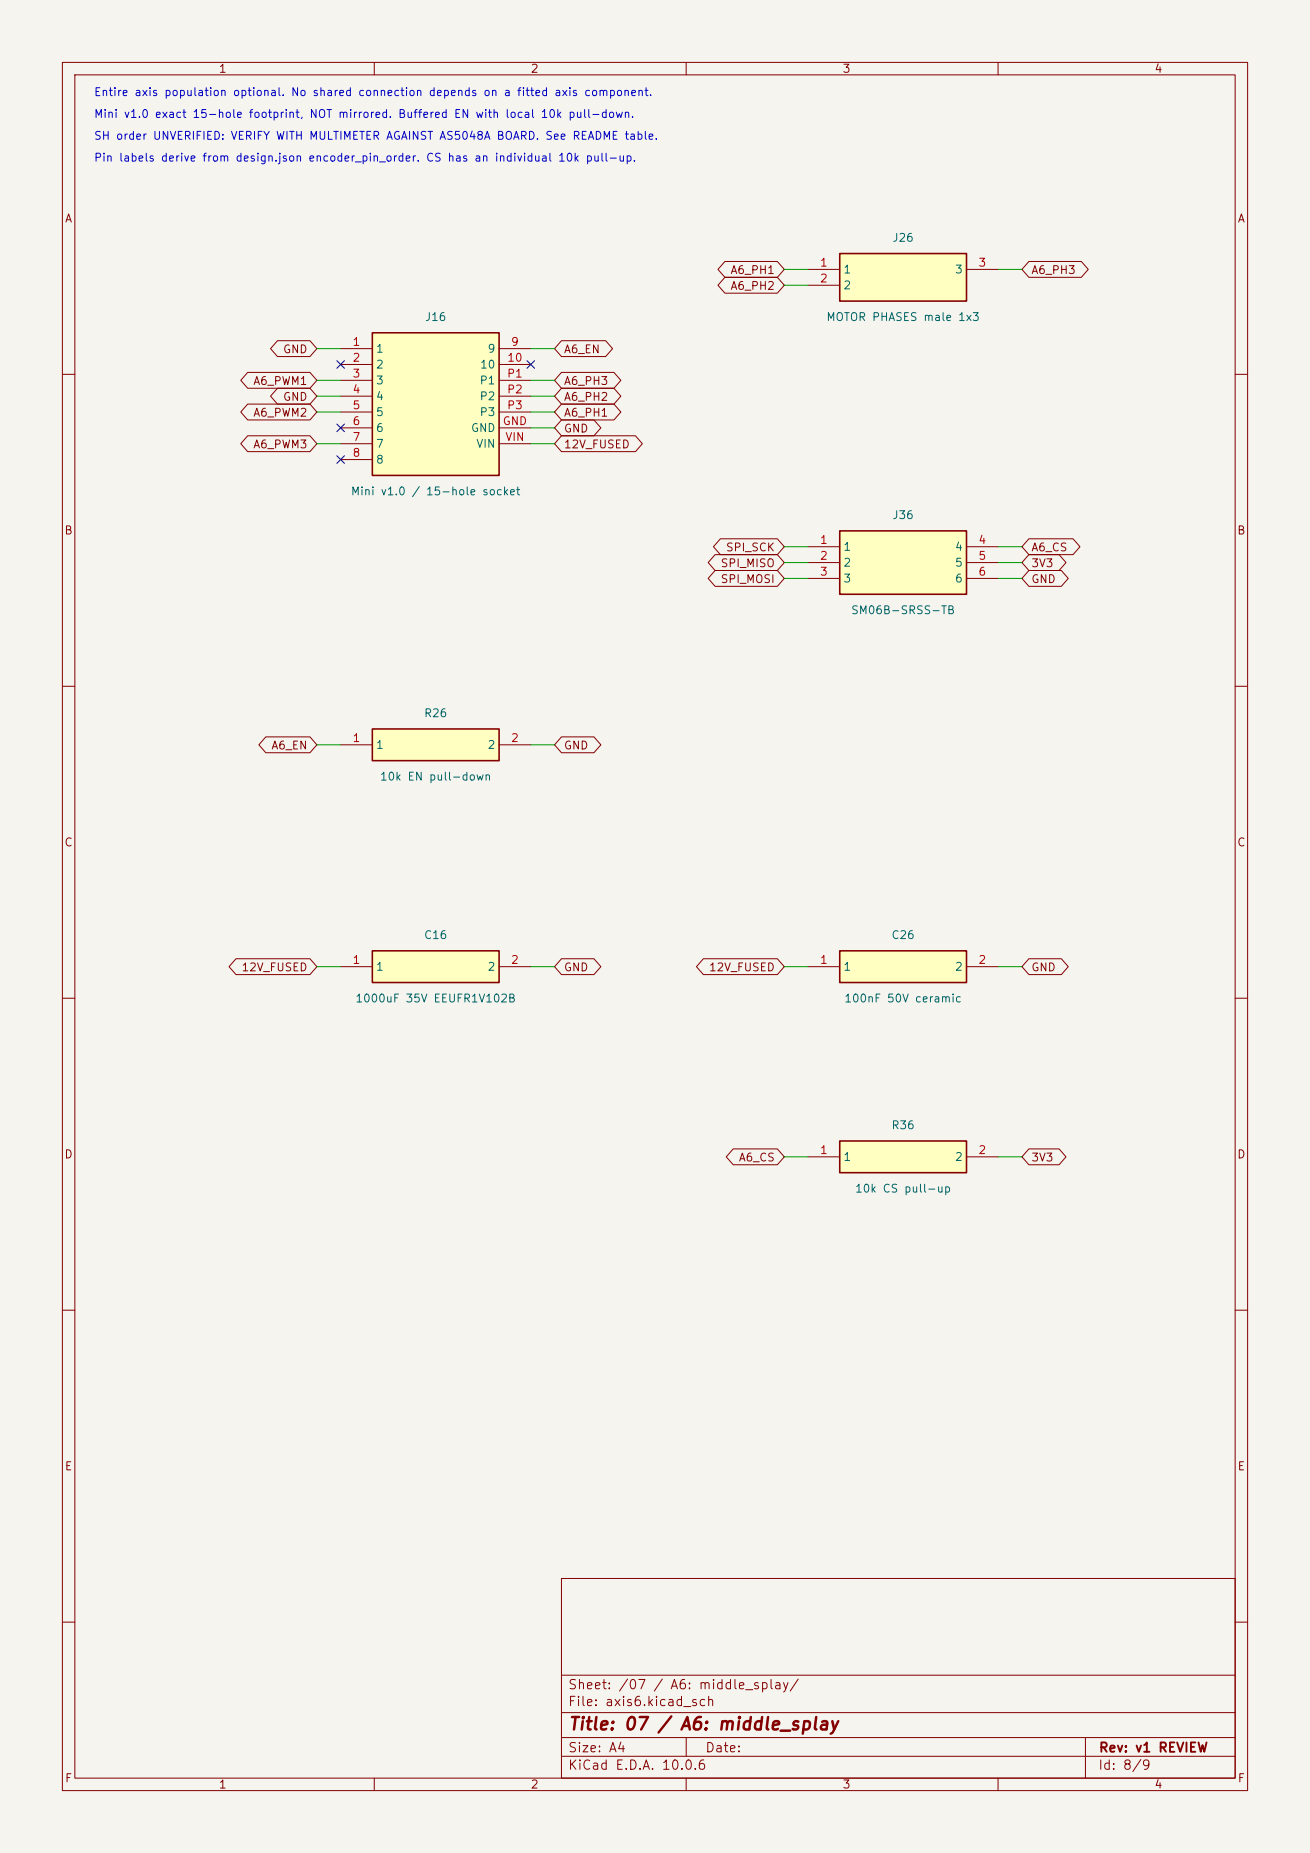
[picture p49: page 8]

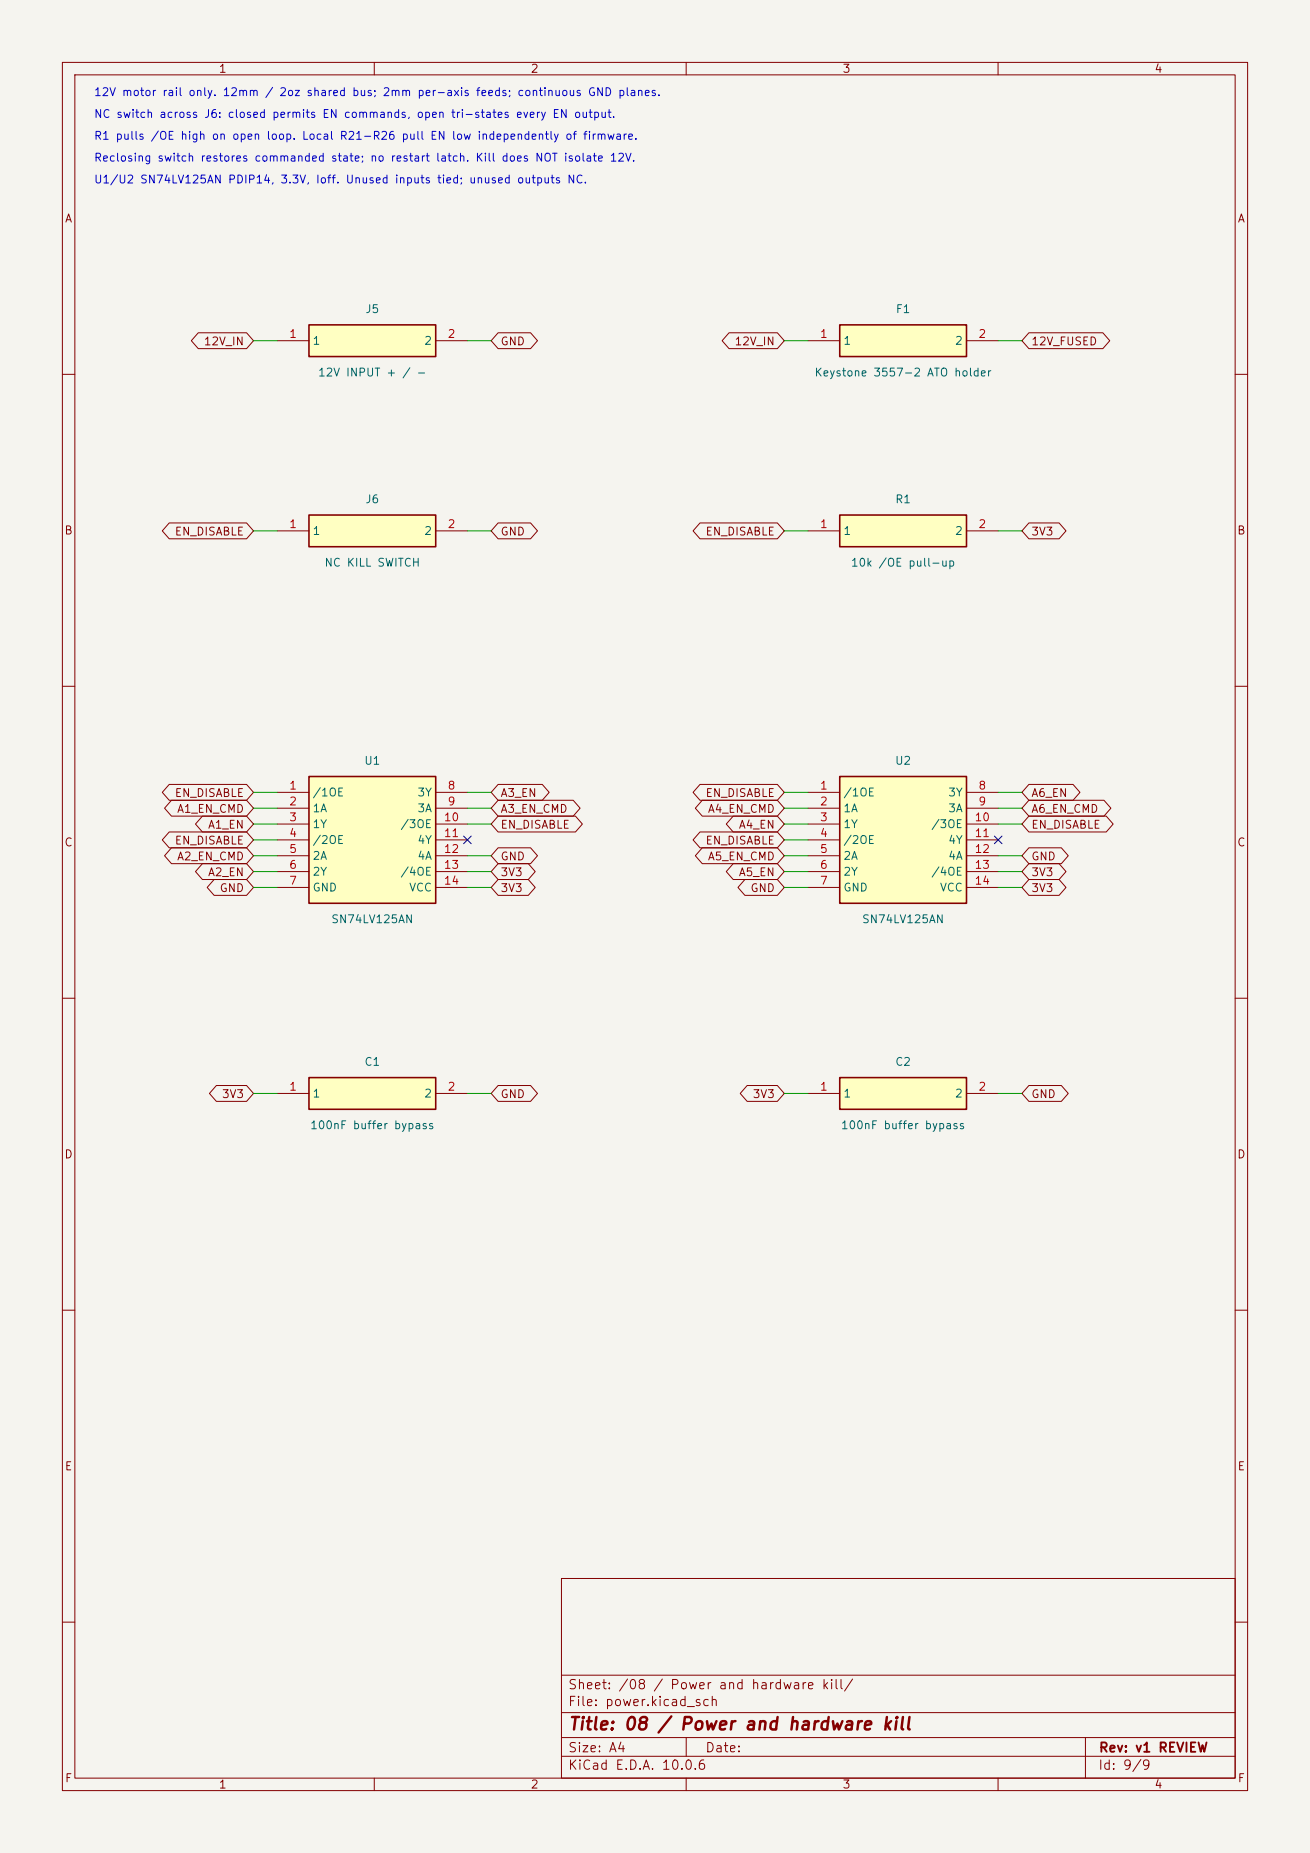
[picture p50: page 9]

12V motor rail only. 12mm / 2oz shared bus; 2mm per-axis feeds; continuous GND planes. NC switch across J6: closed permits EN commands, open tri-states every EN output. R1 pulls /OE high on open loop. Local R21-R26 pull EN low independently of firmware. Reclosing switch restores commanded state; no restart latch. Kill does NOT isolate 12V. U1/U2 SN74LV125AN PDIP14, 3.3V, Ioff. Unused inputs tied; unused outputs NC.

Sheet: /08 / Power and hardware kill/
File: power.kicad_sch
Title: 08 / Power and hardware kill
