AsherNoble/trueskate-ai-hardware/pcb/review/drawings/mechanical-fit-review.pdf

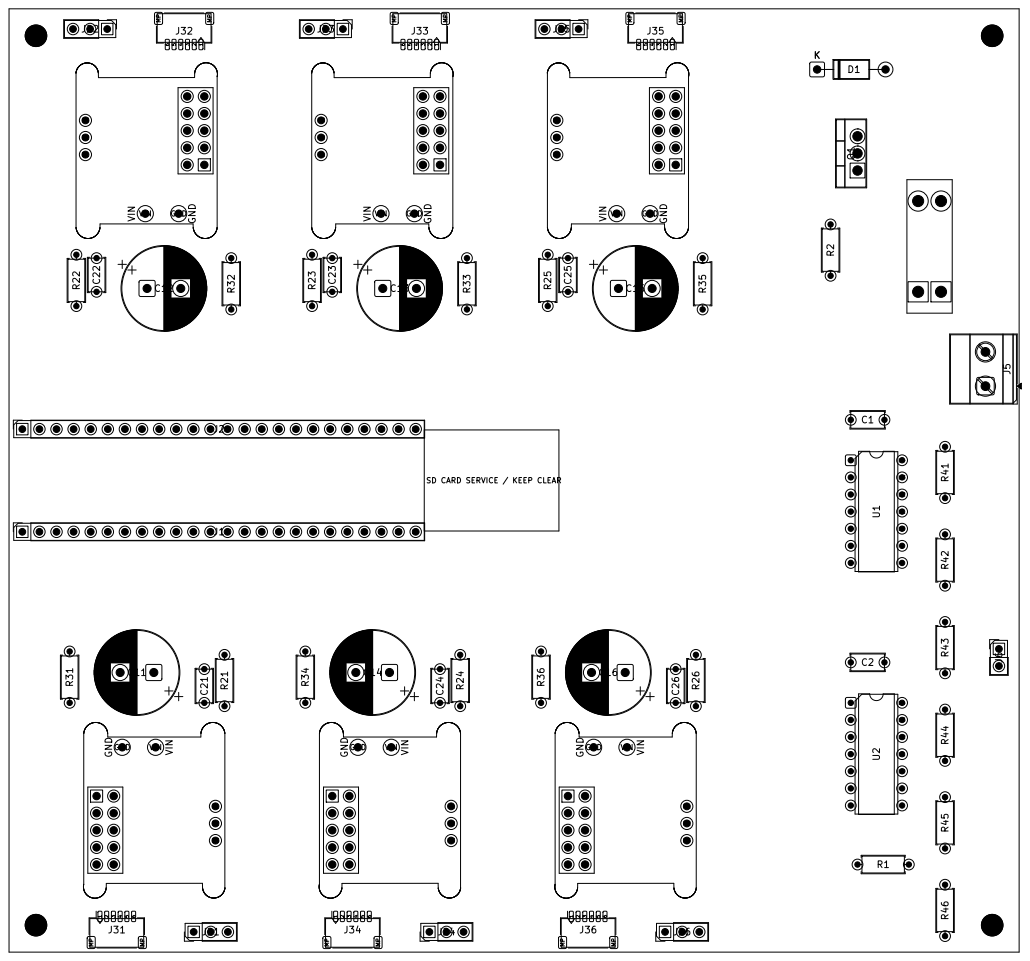
[picture p61: page 1]

SD CARD SERVICE / KEEP CLEAR
