AsherNoble/trueskate-ai-hardware/(list of files, drawings)

Other design files:
pcb/design/routing/signals.dsn
pcb/routing/signals.dsn
