AsherNoble/trueskate-ai-hardware/pcb/design/trueskate-main-v1.kicad_pcb

## KiCad design pcb/design/trueskate-main-v1.kicad_pcb (2026-10-28)

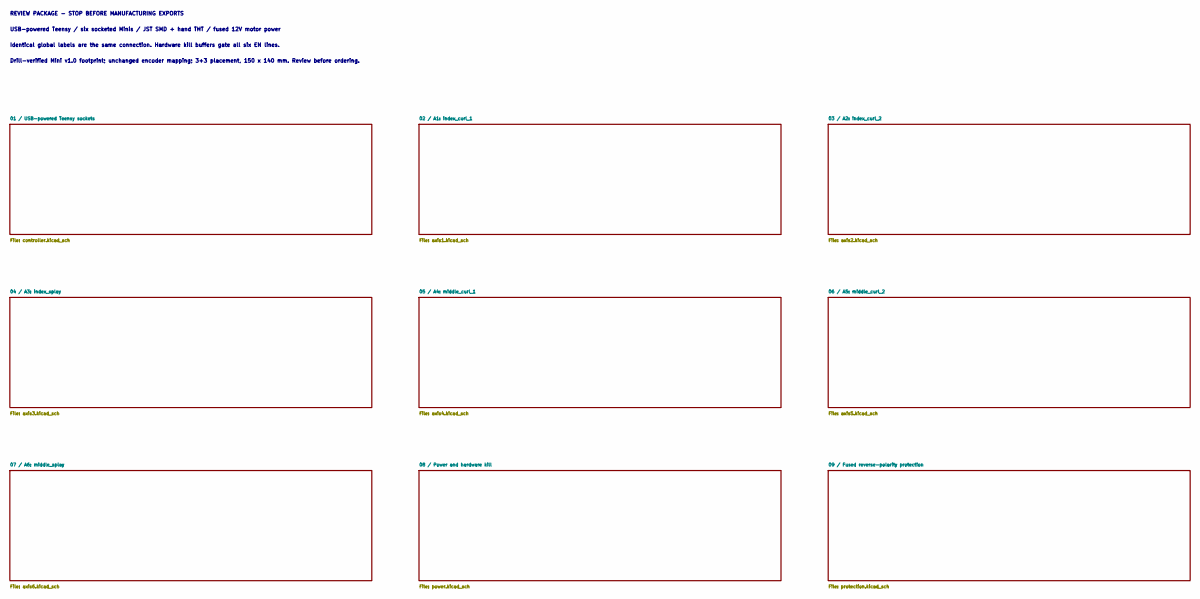
[picture p62: schematic trueskate-main-v1.kicad_sch, TrueSkate USB-powered six-axis carrier]

Notes on the sheet:
REVIEW PACKAGE - STOP BEFORE MANUFACTURING EXPORTS
USB-powered Teensy / six socketed Minis / JST SMD + hand THT / fused 12V motor power
Identical global labels are the same connection. Hardware kill buffers gate all six EN lines.
Drill-verified Mini v1.0 footprint; unchanged encoder mapping; 3+3 placement, 150 x 140 mm. Review before ordering.

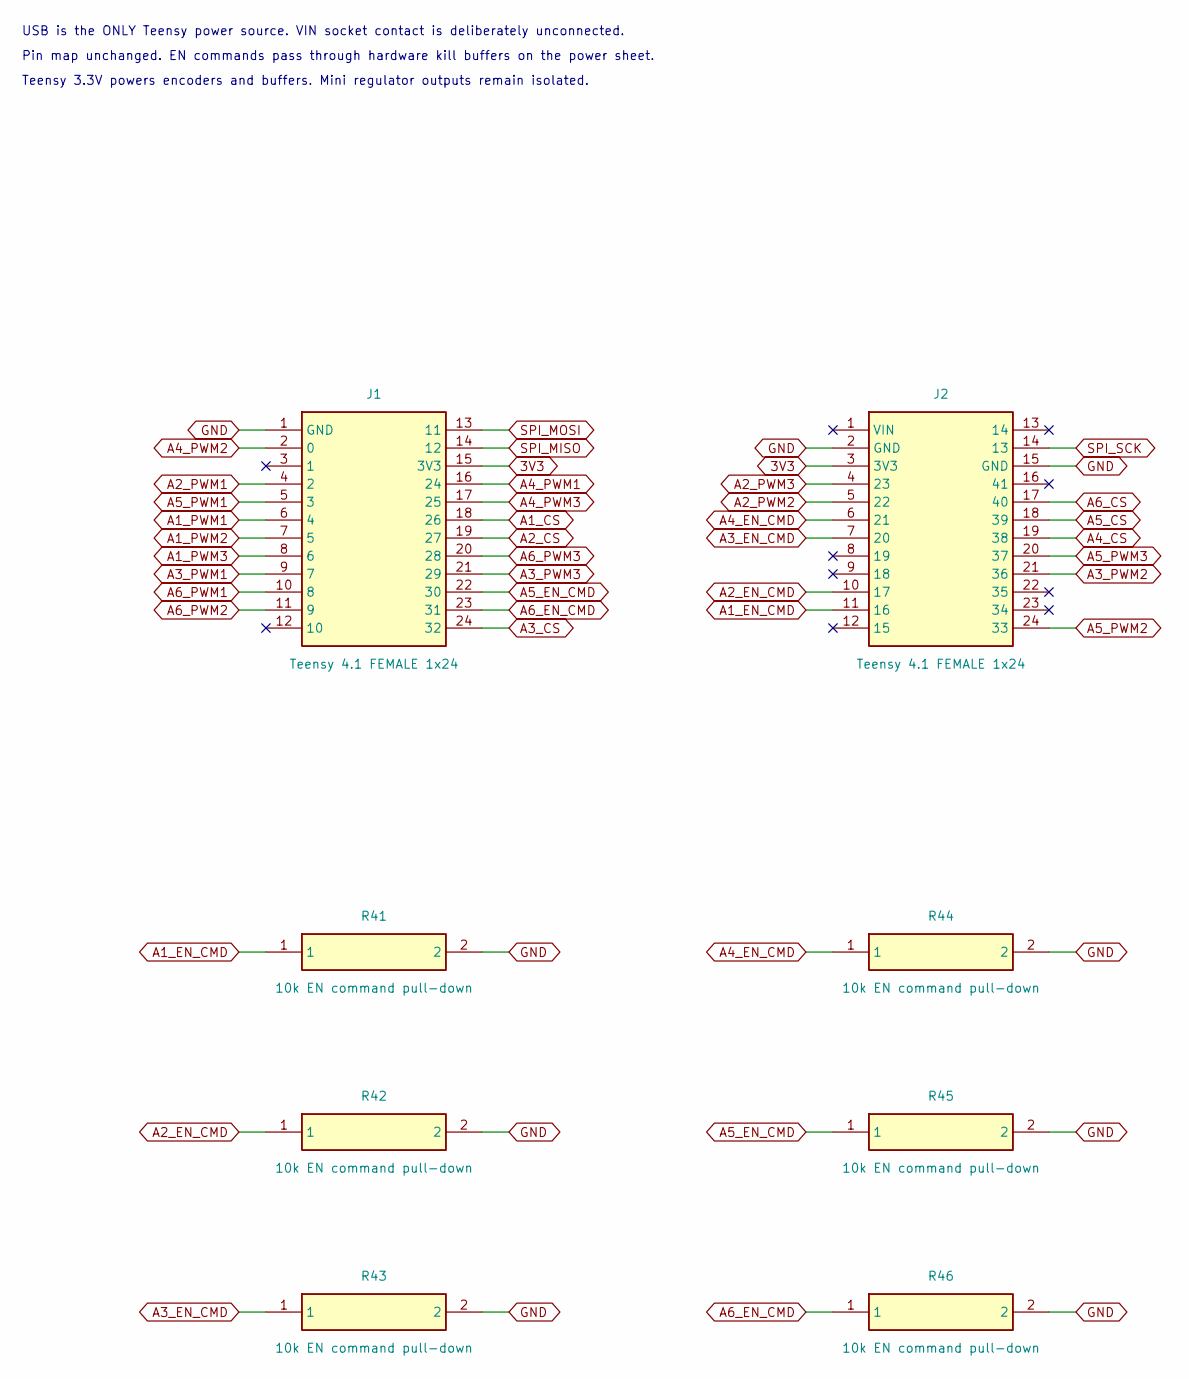
[picture p63: schematic controller.kicad_sch, 01 / USB-powered Teensy sockets]

Parts:
J1, J2: Teensy 4.1 FEMALE 1x24; Edge_PinSocket_1x24_P2.54mm_Vertical
R41, R42, R43, R44, R45, R46: 10k EN command pull-down; Edge_R_Axial_DIN0207_L6.3mm_D2.5mm_P7.62mm_Horizontal

Connections:
3V3: J1.15 (3V3), J2.3 (3V3); also elsewhere on the board
A1_CS: J1.18 (26); also elsewhere on the board
A1_EN_CMD: J2.11 (16), R41.1; also elsewhere on the board
A1_PWM1: J1.6 (4); also elsewhere on the board
A1_PWM2: J1.7 (5); also elsewhere on the board
A1_PWM3: J1.8 (6); also elsewhere on the board
A2_CS: J1.19 (27); also elsewhere on the board
A2_EN_CMD: J2.10 (17), R42.1; also elsewhere on the board
A2_PWM1: J1.4 (2); also elsewhere on the board
A2_PWM2: J2.5 (22); also elsewhere on the board
A2_PWM3: J2.4 (23); also elsewhere on the board
A3_CS: J1.24 (32); also elsewhere on the board
A3_EN_CMD: J2.7 (20), R43.1; also elsewhere on the board
A3_PWM1: J1.9 (7); also elsewhere on the board
A3_PWM2: J2.21 (36); also elsewhere on the board
A3_PWM3: J1.21 (29); also elsewhere on the board
A4_CS: J2.19 (38); also elsewhere on the board
A4_EN_CMD: J2.6 (21), R44.1; also elsewhere on the board
A4_PWM1: J1.16 (24); also elsewhere on the board
A4_PWM2: J1.2 (0); also elsewhere on the board
A4_PWM3: J1.17 (25); also elsewhere on the board
A5_CS: J2.18 (39); also elsewhere on the board
A5_EN_CMD: J1.22 (30), R45.1; also elsewhere on the board
A5_PWM1: J1.5 (3); also elsewhere on the board
A5_PWM2: J2.24 (33); also elsewhere on the board
A5_PWM3: J2.20 (37); also elsewhere on the board
A6_CS: J2.17 (40); also elsewhere on the board
A6_EN_CMD: J1.23 (31), R46.1; also elsewhere on the board
A6_PWM1: J1.10 (8); also elsewhere on the board
A6_PWM2: J1.11 (9); also elsewhere on the board
A6_PWM3: J1.20 (28); also elsewhere on the board
GND: J1.1 (GND), J2.2 (GND), J2.15 (GND), R41.2, R42.2, R43.2, R44.2, R45.2, R46.2; also elsewhere on the board
SPI_MISO: J1.14 (12); also elsewhere on the board
SPI_MOSI: J1.13 (11); also elsewhere on the board
SPI_SCK: J2.14 (13); also elsewhere on the board

Notes on the sheet:
USB is the ONLY Teensy power source. VIN socket contact is deliberately unconnected.
Pin map unchanged. EN commands pass through hardware kill buffers on the power sheet.
Teensy 3.3V powers encoders and buffers. Mini regulator outputs remain isolated.

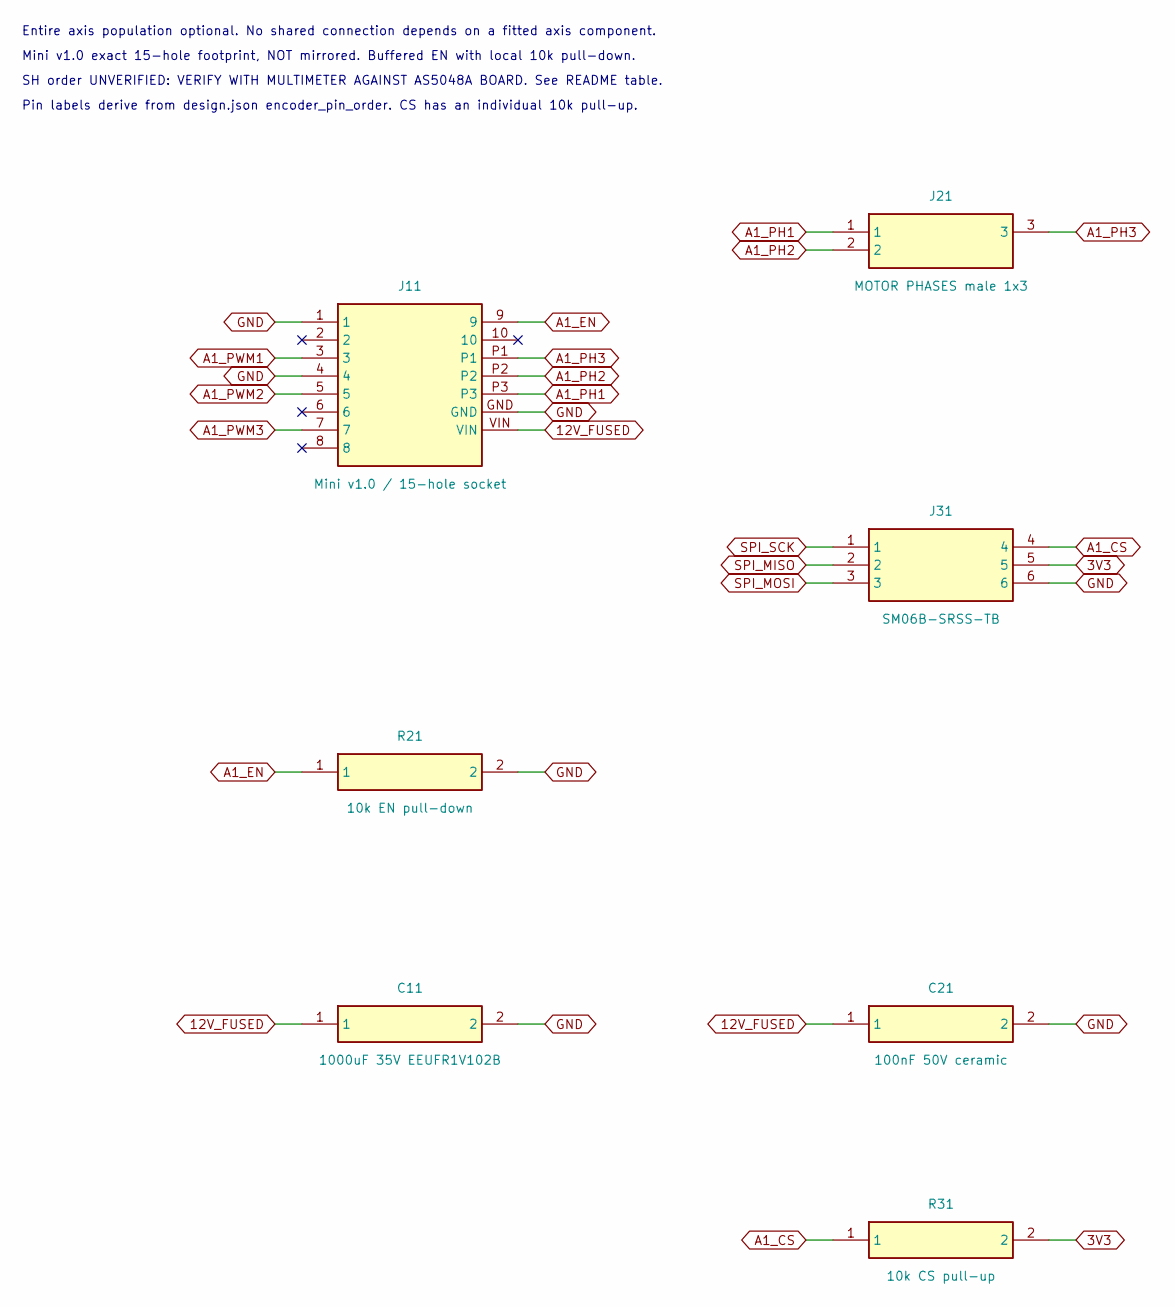
[picture p64: schematic axis1.kicad_sch, 02 / A1: index_curl_1]

Parts:
C11: 1000uF 35V EEUFR1V102B; Edge_CP_Radial_D12.5mm_P5.00mm
C21: 100nF 50V ceramic; Edge_C_Disc_D5.0mm_W2.5mm_P5.00mm
J11: Mini v1.0 / 15-hole socket; SimpleFOC_Mini_v1.0
J21: MOTOR PHASES male 1x3; Edge_PinHeader_1x03_P2.54mm_Vertical
J31: SM06B-SRSS-TB; Edge_JST_SH_SM06B-SRSS-TB_1x06-1MP_P1.00mm_Horizontal
R21: 10k EN pull-down; Edge_R_Axial_DIN0207_L6.3mm_D2.5mm_P7.62mm_Horizontal
R31: 10k CS pull-up; Edge_R_Axial_DIN0207_L6.3mm_D2.5mm_P7.62mm_Horizontal

Connections:
3V3: J31.5, R31.2; also elsewhere on the board
12V_FUSED: C11.1, C21.1, J11.VIN; also elsewhere on the board
A1_CS: J31.4, R31.1; also elsewhere on the board
A1_EN: J11.9, R21.1; also elsewhere on the board
A1_PH1: J11.P3, J21.1
A1_PH2: J11.P2, J21.2
A1_PH3: J11.P1, J21.3
A1_PWM1: J11.3; also elsewhere on the board
A1_PWM2: J11.5; also elsewhere on the board
A1_PWM3: J11.7; also elsewhere on the board
GND: C11.2, C21.2, J11.1, J11.4, J11.GND, J31.6, R21.2; also elsewhere on the board
SPI_MISO: J31.2; also elsewhere on the board
SPI_MOSI: J31.3; also elsewhere on the board
SPI_SCK: J31.1; also elsewhere on the board

Notes on the sheet:
Entire axis population optional. No shared connection depends on a fitted axis component.
Mini v1.0 exact 15-hole footprint, NOT mirrored. Buffered EN with local 10k pull-down.
SH order UNVERIFIED: VERIFY WITH MULTIMETER AGAINST AS5048A BOARD. See README table.
Pin labels derive from design.json encoder_pin_order. CS has an individual 10k pull-up.

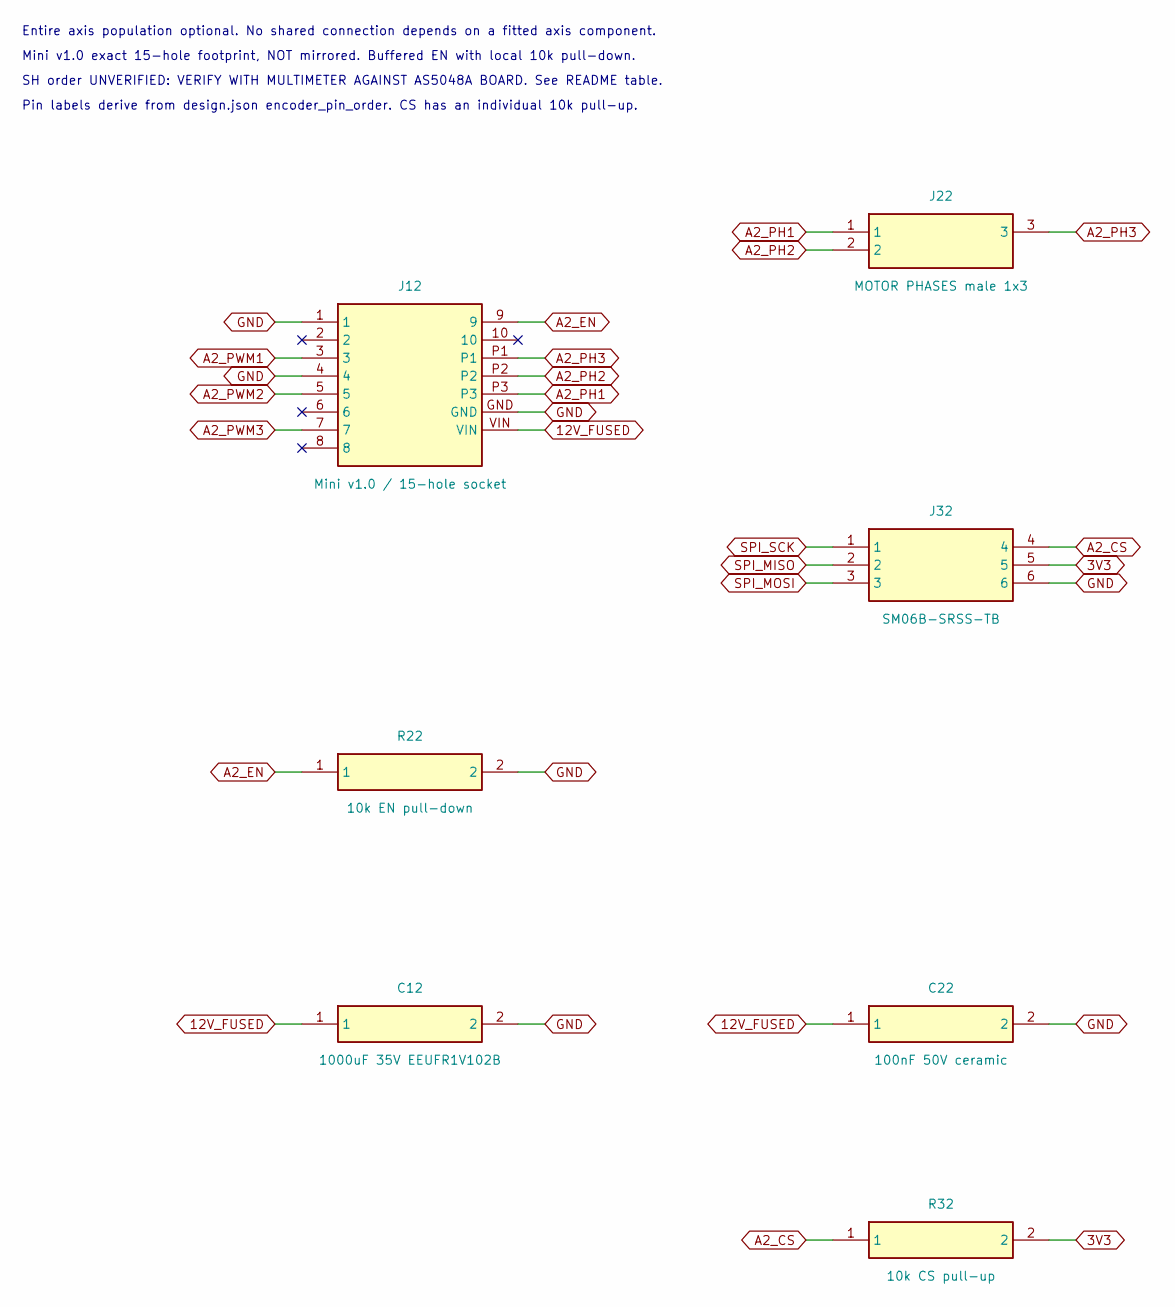
[picture p65: schematic axis2.kicad_sch, 03 / A2: index_curl_2]

Parts:
C12: 1000uF 35V EEUFR1V102B; Edge_CP_Radial_D12.5mm_P5.00mm
C22: 100nF 50V ceramic; Edge_C_Disc_D5.0mm_W2.5mm_P5.00mm
J12: Mini v1.0 / 15-hole socket; SimpleFOC_Mini_v1.0
J22: MOTOR PHASES male 1x3; Edge_PinHeader_1x03_P2.54mm_Vertical
J32: SM06B-SRSS-TB; Edge_JST_SH_SM06B-SRSS-TB_1x06-1MP_P1.00mm_Horizontal
R22: 10k EN pull-down; Edge_R_Axial_DIN0207_L6.3mm_D2.5mm_P7.62mm_Horizontal
R32: 10k CS pull-up; Edge_R_Axial_DIN0207_L6.3mm_D2.5mm_P7.62mm_Horizontal

Connections:
3V3: J32.5, R32.2; also elsewhere on the board
12V_FUSED: C12.1, C22.1, J12.VIN; also elsewhere on the board
A2_CS: J32.4, R32.1; also elsewhere on the board
A2_EN: J12.9, R22.1; also elsewhere on the board
A2_PH1: J12.P3, J22.1
A2_PH2: J12.P2, J22.2
A2_PH3: J12.P1, J22.3
A2_PWM1: J12.3; also elsewhere on the board
A2_PWM2: J12.5; also elsewhere on the board
A2_PWM3: J12.7; also elsewhere on the board
GND: C12.2, C22.2, J12.1, J12.4, J12.GND, J32.6, R22.2; also elsewhere on the board
SPI_MISO: J32.2; also elsewhere on the board
SPI_MOSI: J32.3; also elsewhere on the board
SPI_SCK: J32.1; also elsewhere on the board

Notes on the sheet:
Entire axis population optional. No shared connection depends on a fitted axis component.
Mini v1.0 exact 15-hole footprint, NOT mirrored. Buffered EN with local 10k pull-down.
SH order UNVERIFIED: VERIFY WITH MULTIMETER AGAINST AS5048A BOARD. See README table.
Pin labels derive from design.json encoder_pin_order. CS has an individual 10k pull-up.

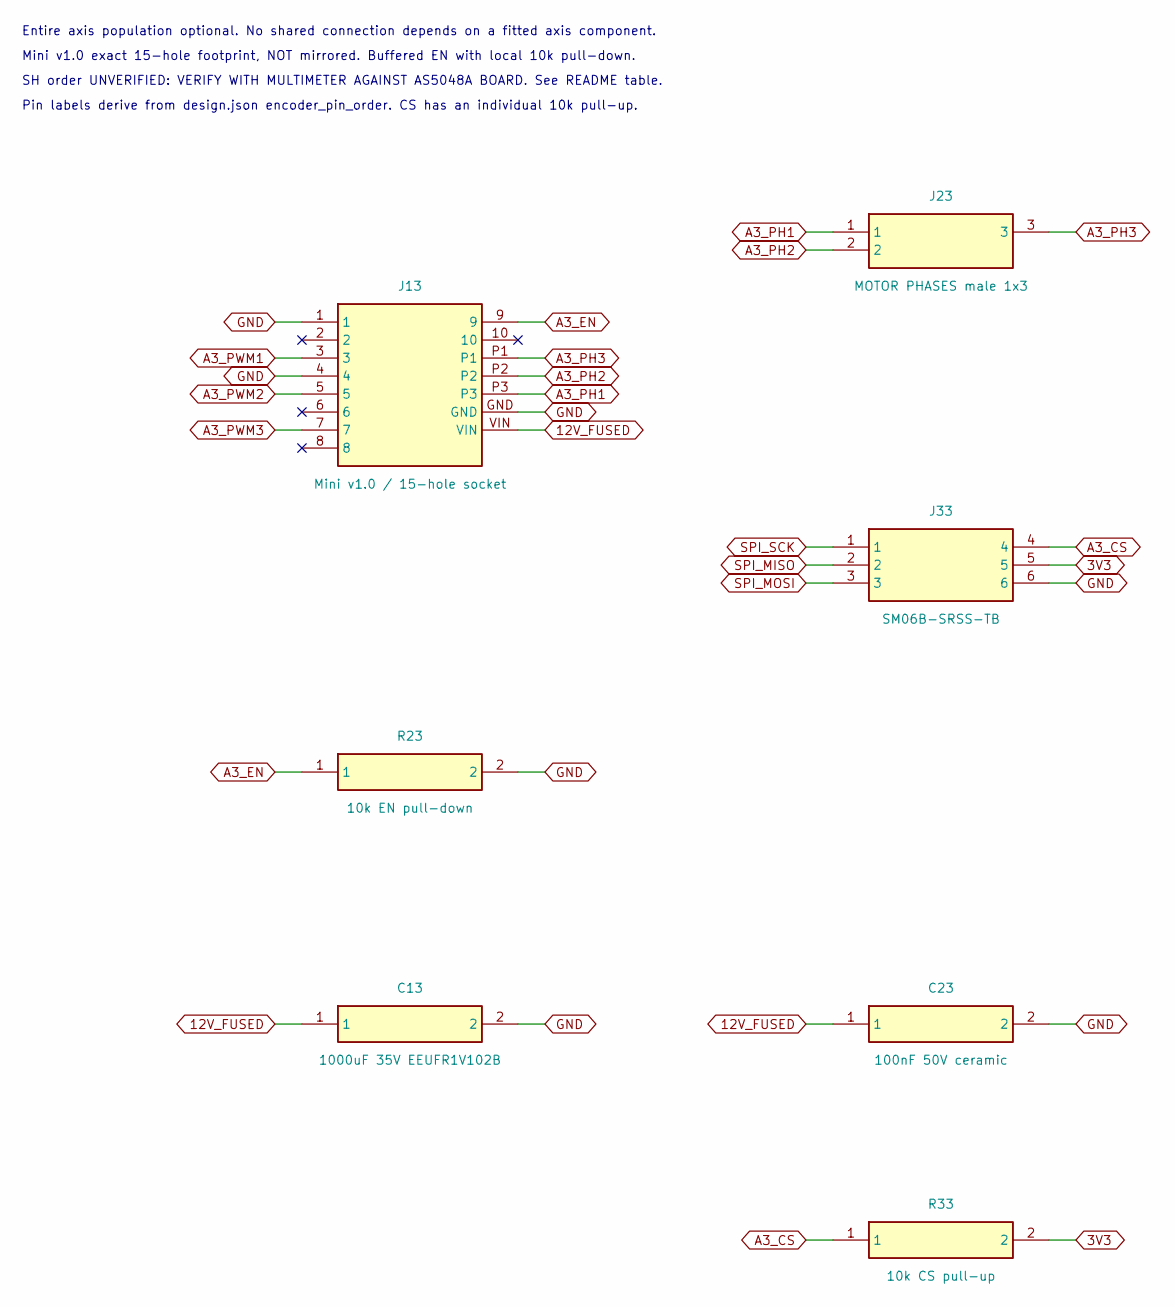
[picture p66: schematic axis3.kicad_sch, 04 / A3: index_splay]

Parts:
C13: 1000uF 35V EEUFR1V102B; Edge_CP_Radial_D12.5mm_P5.00mm
C23: 100nF 50V ceramic; Edge_C_Disc_D5.0mm_W2.5mm_P5.00mm
J13: Mini v1.0 / 15-hole socket; SimpleFOC_Mini_v1.0
J23: MOTOR PHASES male 1x3; Edge_PinHeader_1x03_P2.54mm_Vertical
J33: SM06B-SRSS-TB; Edge_JST_SH_SM06B-SRSS-TB_1x06-1MP_P1.00mm_Horizontal
R23: 10k EN pull-down; Edge_R_Axial_DIN0207_L6.3mm_D2.5mm_P7.62mm_Horizontal
R33: 10k CS pull-up; Edge_R_Axial_DIN0207_L6.3mm_D2.5mm_P7.62mm_Horizontal

Connections:
3V3: J33.5, R33.2; also elsewhere on the board
12V_FUSED: C13.1, C23.1, J13.VIN; also elsewhere on the board
A3_CS: J33.4, R33.1; also elsewhere on the board
A3_EN: J13.9, R23.1; also elsewhere on the board
A3_PH1: J13.P3, J23.1
A3_PH2: J13.P2, J23.2
A3_PH3: J13.P1, J23.3
A3_PWM1: J13.3; also elsewhere on the board
A3_PWM2: J13.5; also elsewhere on the board
A3_PWM3: J13.7; also elsewhere on the board
GND: C13.2, C23.2, J13.1, J13.4, J13.GND, J33.6, R23.2; also elsewhere on the board
SPI_MISO: J33.2; also elsewhere on the board
SPI_MOSI: J33.3; also elsewhere on the board
SPI_SCK: J33.1; also elsewhere on the board

Notes on the sheet:
Entire axis population optional. No shared connection depends on a fitted axis component.
Mini v1.0 exact 15-hole footprint, NOT mirrored. Buffered EN with local 10k pull-down.
SH order UNVERIFIED: VERIFY WITH MULTIMETER AGAINST AS5048A BOARD. See README table.
Pin labels derive from design.json encoder_pin_order. CS has an individual 10k pull-up.

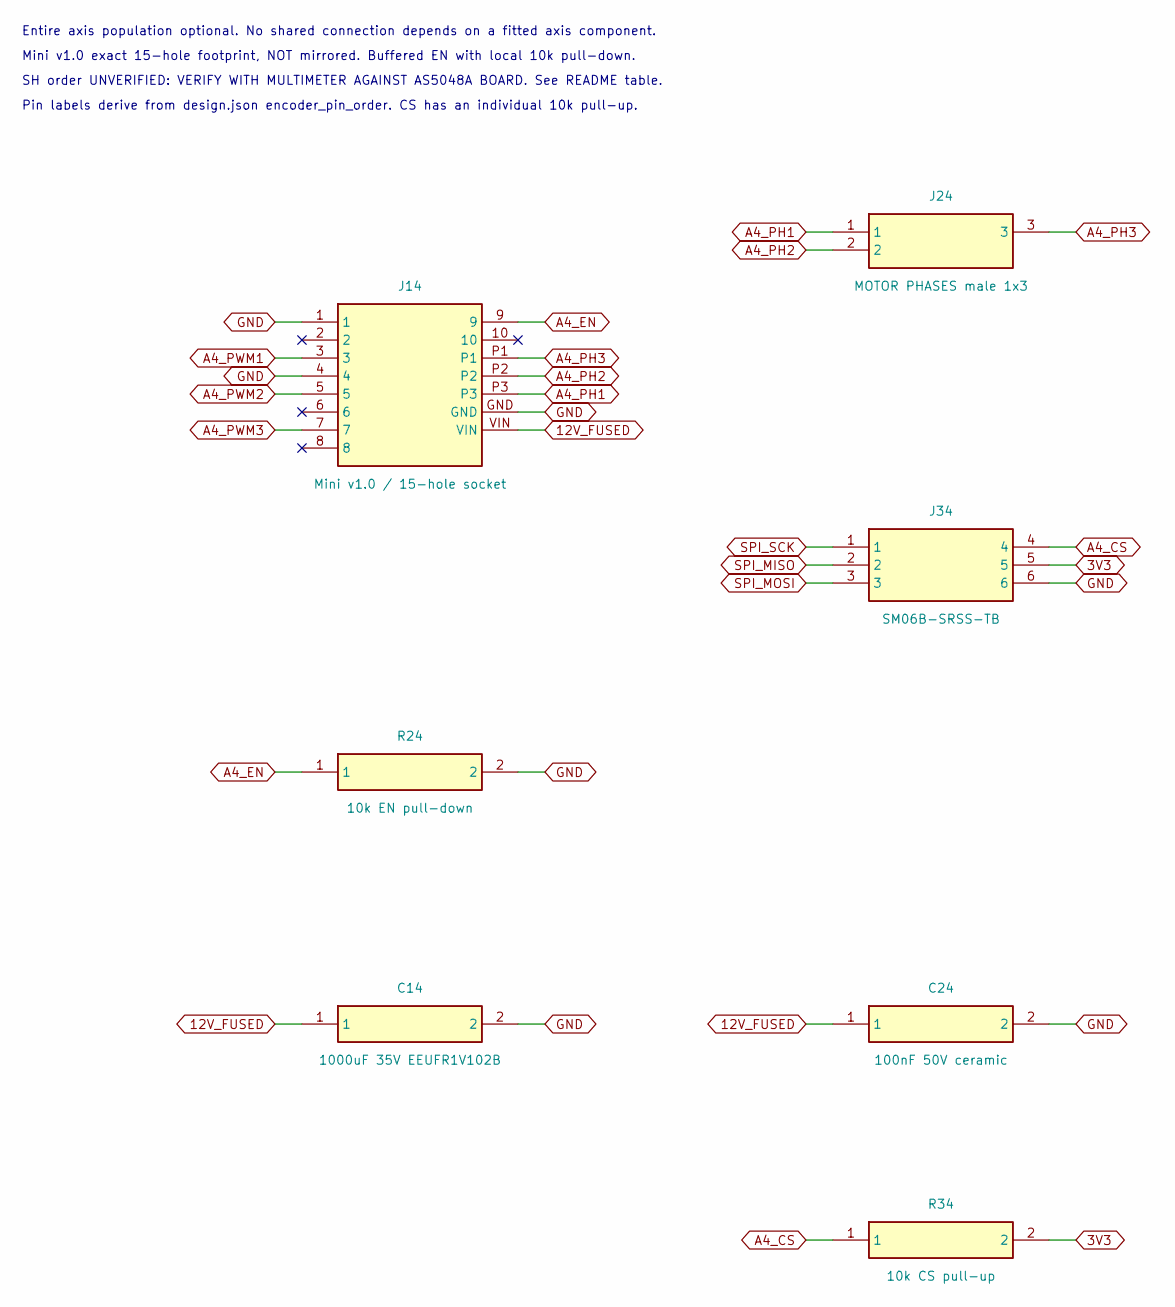
[picture p67: schematic axis4.kicad_sch, 05 / A4: middle_curl_1]

Parts:
C14: 1000uF 35V EEUFR1V102B; Edge_CP_Radial_D12.5mm_P5.00mm
C24: 100nF 50V ceramic; Edge_C_Disc_D5.0mm_W2.5mm_P5.00mm
J14: Mini v1.0 / 15-hole socket; SimpleFOC_Mini_v1.0
J24: MOTOR PHASES male 1x3; Edge_PinHeader_1x03_P2.54mm_Vertical
J34: SM06B-SRSS-TB; Edge_JST_SH_SM06B-SRSS-TB_1x06-1MP_P1.00mm_Horizontal
R24: 10k EN pull-down; Edge_R_Axial_DIN0207_L6.3mm_D2.5mm_P7.62mm_Horizontal
R34: 10k CS pull-up; Edge_R_Axial_DIN0207_L6.3mm_D2.5mm_P7.62mm_Horizontal

Connections:
3V3: J34.5, R34.2; also elsewhere on the board
12V_FUSED: C14.1, C24.1, J14.VIN; also elsewhere on the board
A4_CS: J34.4, R34.1; also elsewhere on the board
A4_EN: J14.9, R24.1; also elsewhere on the board
A4_PH1: J14.P3, J24.1
A4_PH2: J14.P2, J24.2
A4_PH3: J14.P1, J24.3
A4_PWM1: J14.3; also elsewhere on the board
A4_PWM2: J14.5; also elsewhere on the board
A4_PWM3: J14.7; also elsewhere on the board
GND: C14.2, C24.2, J14.1, J14.4, J14.GND, J34.6, R24.2; also elsewhere on the board
SPI_MISO: J34.2; also elsewhere on the board
SPI_MOSI: J34.3; also elsewhere on the board
SPI_SCK: J34.1; also elsewhere on the board

Notes on the sheet:
Entire axis population optional. No shared connection depends on a fitted axis component.
Mini v1.0 exact 15-hole footprint, NOT mirrored. Buffered EN with local 10k pull-down.
SH order UNVERIFIED: VERIFY WITH MULTIMETER AGAINST AS5048A BOARD. See README table.
Pin labels derive from design.json encoder_pin_order. CS has an individual 10k pull-up.

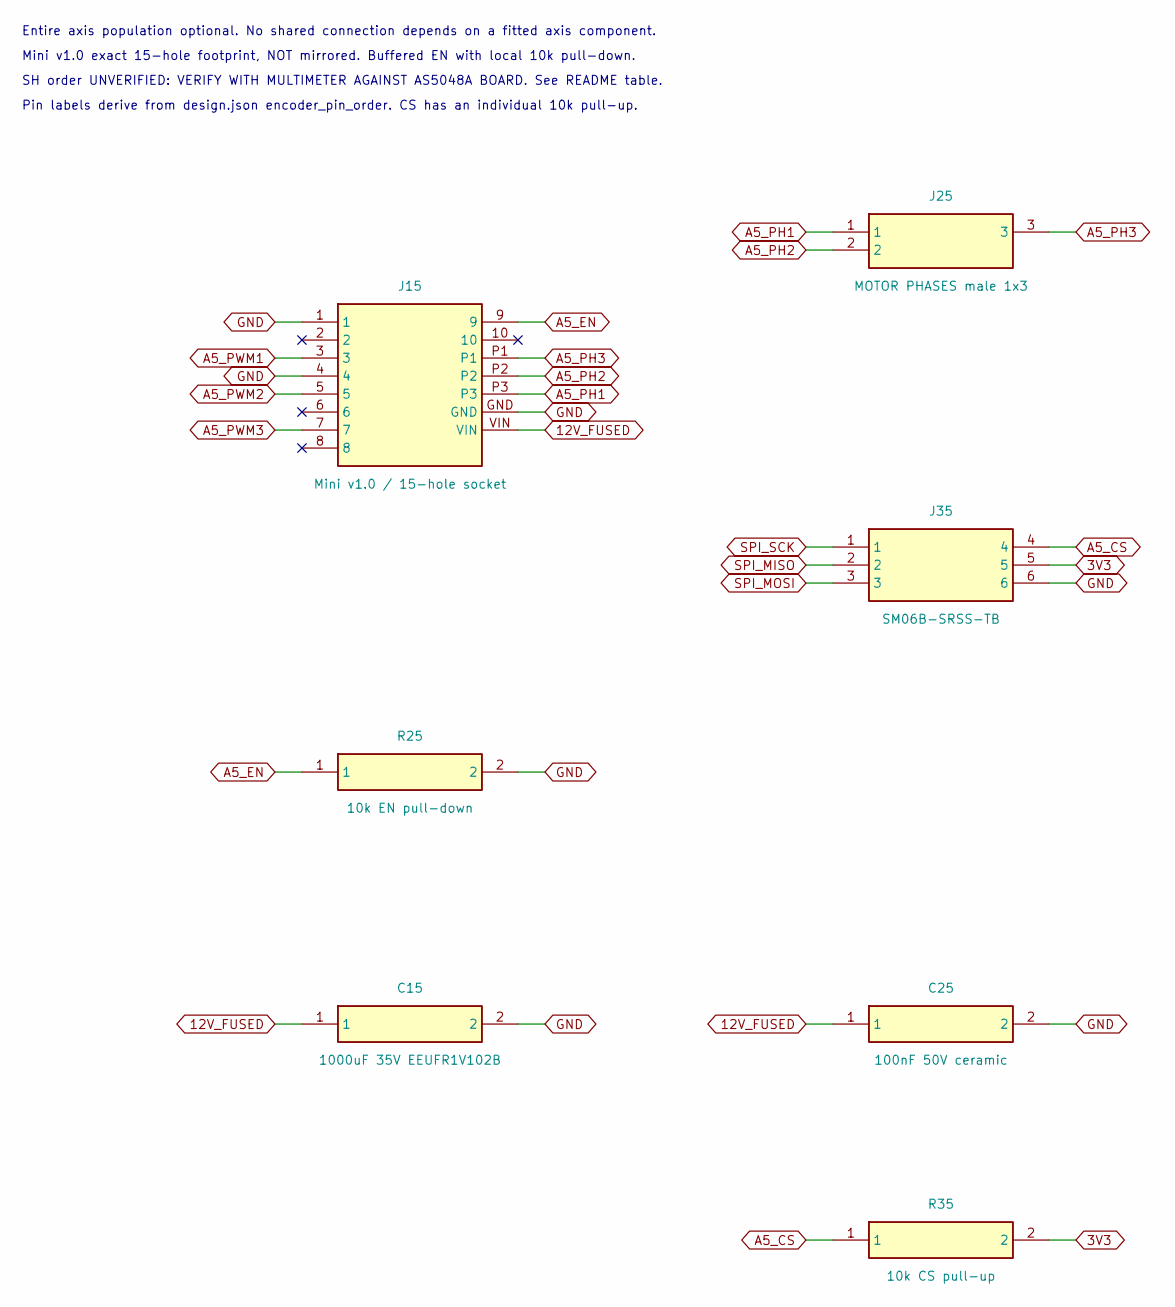
[picture p68: schematic axis5.kicad_sch, 06 / A5: middle_curl_2]

Parts:
C15: 1000uF 35V EEUFR1V102B; Edge_CP_Radial_D12.5mm_P5.00mm
C25: 100nF 50V ceramic; Edge_C_Disc_D5.0mm_W2.5mm_P5.00mm
J15: Mini v1.0 / 15-hole socket; SimpleFOC_Mini_v1.0
J25: MOTOR PHASES male 1x3; Edge_PinHeader_1x03_P2.54mm_Vertical
J35: SM06B-SRSS-TB; Edge_JST_SH_SM06B-SRSS-TB_1x06-1MP_P1.00mm_Horizontal
R25: 10k EN pull-down; Edge_R_Axial_DIN0207_L6.3mm_D2.5mm_P7.62mm_Horizontal
R35: 10k CS pull-up; Edge_R_Axial_DIN0207_L6.3mm_D2.5mm_P7.62mm_Horizontal

Connections:
3V3: J35.5, R35.2; also elsewhere on the board
12V_FUSED: C15.1, C25.1, J15.VIN; also elsewhere on the board
A5_CS: J35.4, R35.1; also elsewhere on the board
A5_EN: J15.9, R25.1; also elsewhere on the board
A5_PH1: J15.P3, J25.1
A5_PH2: J15.P2, J25.2
A5_PH3: J15.P1, J25.3
A5_PWM1: J15.3; also elsewhere on the board
A5_PWM2: J15.5; also elsewhere on the board
A5_PWM3: J15.7; also elsewhere on the board
GND: C15.2, C25.2, J15.1, J15.4, J15.GND, J35.6, R25.2; also elsewhere on the board
SPI_MISO: J35.2; also elsewhere on the board
SPI_MOSI: J35.3; also elsewhere on the board
SPI_SCK: J35.1; also elsewhere on the board

Notes on the sheet:
Entire axis population optional. No shared connection depends on a fitted axis component.
Mini v1.0 exact 15-hole footprint, NOT mirrored. Buffered EN with local 10k pull-down.
SH order UNVERIFIED: VERIFY WITH MULTIMETER AGAINST AS5048A BOARD. See README table.
Pin labels derive from design.json encoder_pin_order. CS has an individual 10k pull-up.

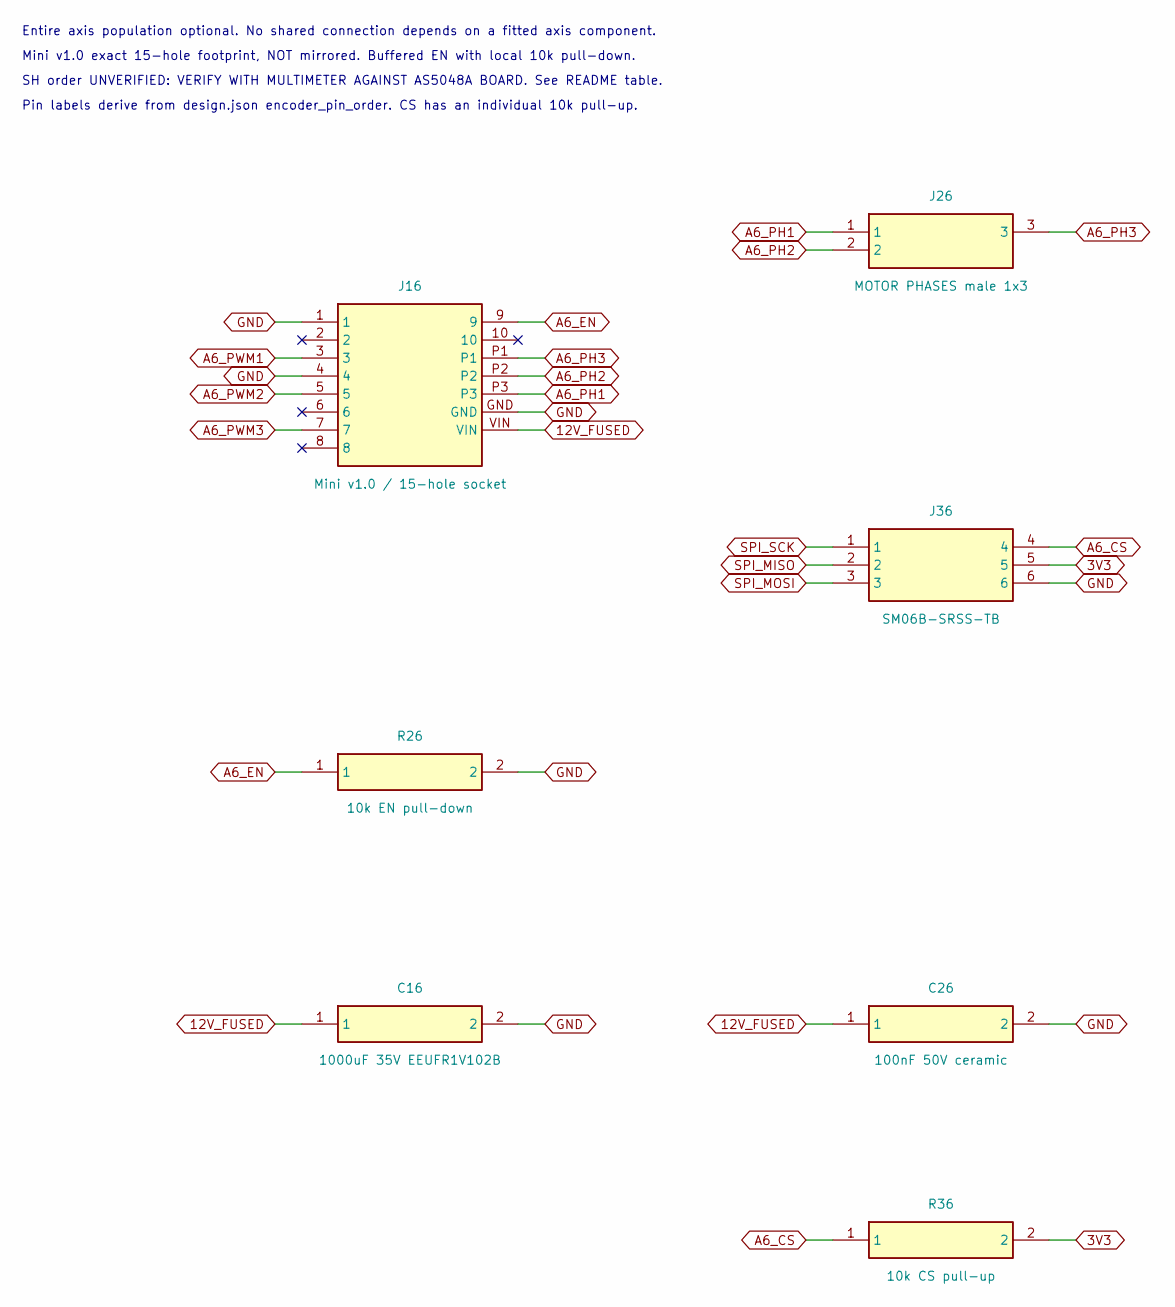
[picture p69: schematic axis6.kicad_sch, 07 / A6: middle_splay]

Parts:
C16: 1000uF 35V EEUFR1V102B; Edge_CP_Radial_D12.5mm_P5.00mm
C26: 100nF 50V ceramic; Edge_C_Disc_D5.0mm_W2.5mm_P5.00mm
J16: Mini v1.0 / 15-hole socket; SimpleFOC_Mini_v1.0
J26: MOTOR PHASES male 1x3; Edge_PinHeader_1x03_P2.54mm_Vertical
J36: SM06B-SRSS-TB; Edge_JST_SH_SM06B-SRSS-TB_1x06-1MP_P1.00mm_Horizontal
R26: 10k EN pull-down; Edge_R_Axial_DIN0207_L6.3mm_D2.5mm_P7.62mm_Horizontal
R36: 10k CS pull-up; Edge_R_Axial_DIN0207_L6.3mm_D2.5mm_P7.62mm_Horizontal

Connections:
3V3: J36.5, R36.2; also elsewhere on the board
12V_FUSED: C16.1, C26.1, J16.VIN; also elsewhere on the board
A6_CS: J36.4, R36.1; also elsewhere on the board
A6_EN: J16.9, R26.1; also elsewhere on the board
A6_PH1: J16.P3, J26.1
A6_PH2: J16.P2, J26.2
A6_PH3: J16.P1, J26.3
A6_PWM1: J16.3; also elsewhere on the board
A6_PWM2: J16.5; also elsewhere on the board
A6_PWM3: J16.7; also elsewhere on the board
GND: C16.2, C26.2, J16.1, J16.4, J16.GND, J36.6, R26.2; also elsewhere on the board
SPI_MISO: J36.2; also elsewhere on the board
SPI_MOSI: J36.3; also elsewhere on the board
SPI_SCK: J36.1; also elsewhere on the board

Notes on the sheet:
Entire axis population optional. No shared connection depends on a fitted axis component.
Mini v1.0 exact 15-hole footprint, NOT mirrored. Buffered EN with local 10k pull-down.
SH order UNVERIFIED: VERIFY WITH MULTIMETER AGAINST AS5048A BOARD. See README table.
Pin labels derive from design.json encoder_pin_order. CS has an individual 10k pull-up.

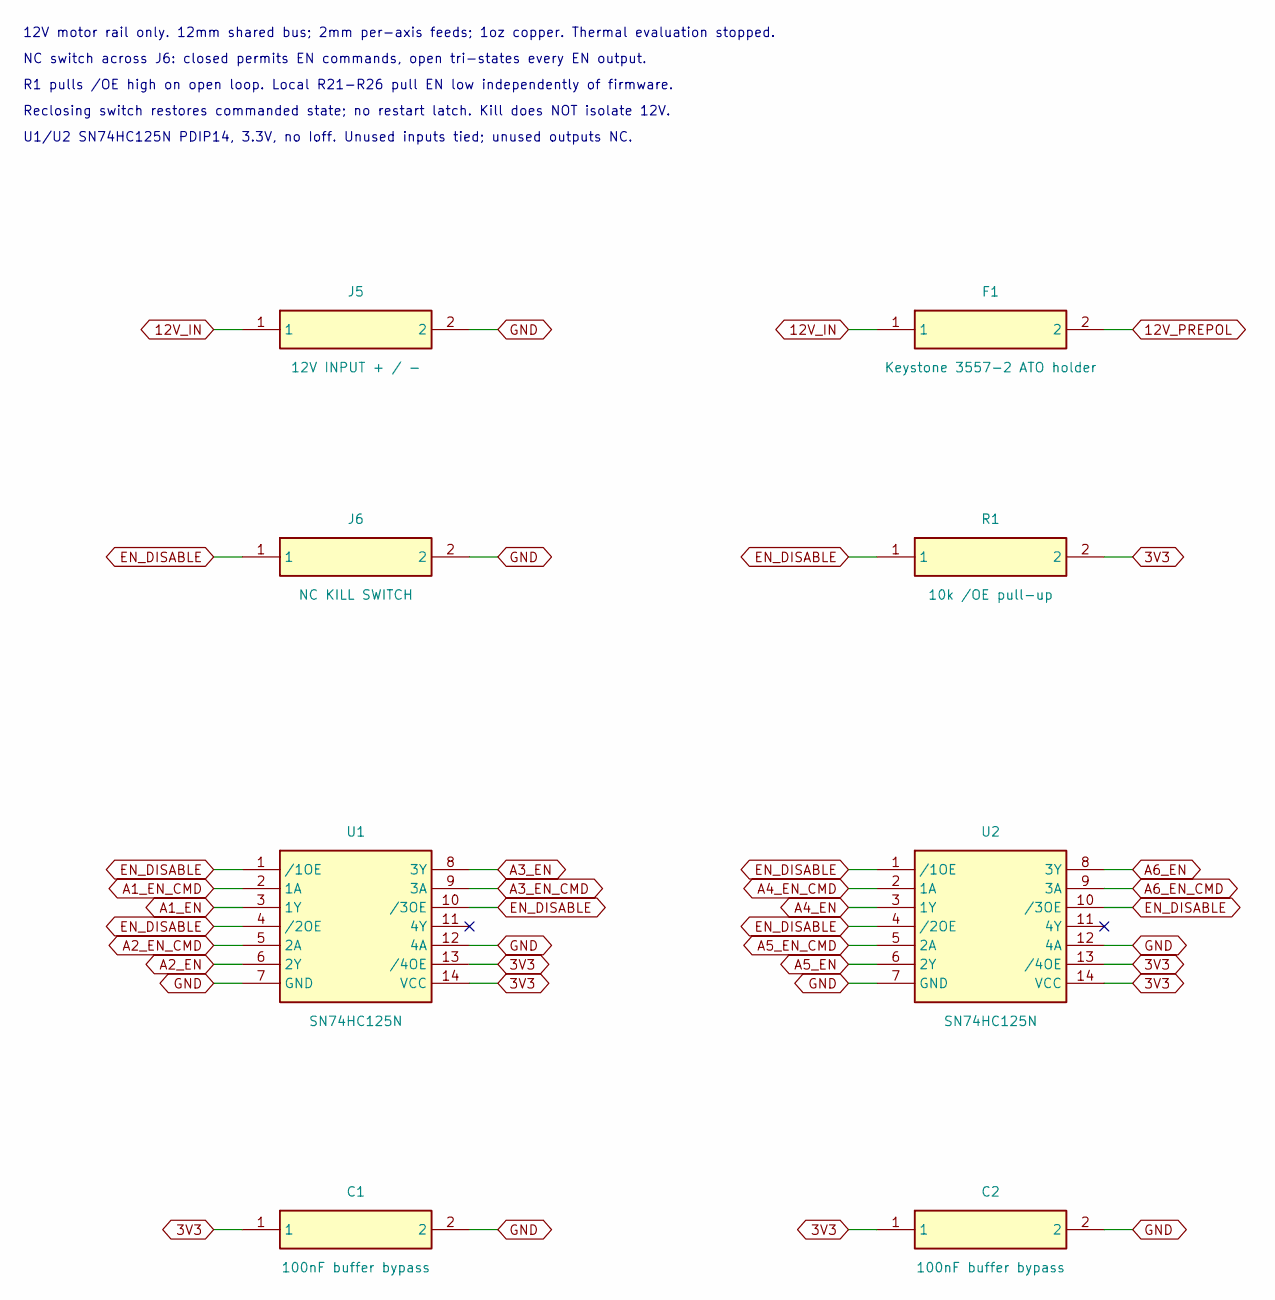
[picture p70: schematic power.kicad_sch, 08 / Power and hardware kill]

Parts:
C1, C2: 100nF buffer bypass; Edge_C_Disc_D5.0mm_W2.5mm_P5.00mm
F1: Keystone 3557-2 ATO holder; Keystone_3557-2_ATO
J5: 12V INPUT + / -; Edge_TerminalBlock_Phoenix_MKDS-1,5-2-5.08_1x02_P5.08mm_Hor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
J6: NC KILL SWITCH; Edge_PinHeader_1x02_P2.54mm_Vertical
R1: 10k /OE pull-up; Edge_R_Axial_DIN0207_L6.3mm_D2.5mm_P7.62mm_Horizontal
U1, U2: SN74HC125N; Edge_DIP-14_W7.62mm

Connections:
3V3: C1.1, C2.1, R1.2, U1.13 (/4OE), U1.14 (VCC), U2.13 (/4OE), U2.14 (VCC); also elsewhere on the board
12V_IN: F1.1, J5.1
12V_PREPOL: F1.2; also elsewhere on the board
A1_EN: U1.3 (1Y); also elsewhere on the board
A1_EN_CMD: U1.2 (1A); also elsewhere on the board
A2_EN: U1.6 (2Y); also elsewhere on the board
A2_EN_CMD: U1.5 (2A); also elsewhere on the board
A3_EN: U1.8 (3Y); also elsewhere on the board
A3_EN_CMD: U1.9 (3A); also elsewhere on the board
A4_EN: U2.3 (1Y); also elsewhere on the board
A4_EN_CMD: U2.2 (1A); also elsewhere on the board
A5_EN: U2.6 (2Y); also elsewhere on the board
A5_EN_CMD: U2.5 (2A); also elsewhere on the board
A6_EN: U2.8 (3Y); also elsewhere on the board
A6_EN_CMD: U2.9 (3A); also elsewhere on the board
EN_DISABLE: J6.1, R1.1, U1.1 (/1OE), U1.4 (/2OE), U1.10 (/3OE), U2.1 (/1OE), U2.4 (/2OE), U2.10 (/3OE)
GND: C1.2, C2.2, J5.2, J6.2, U1.7 (GND), U1.12 (4A), U2.7 (GND), U2.12 (4A); also elsewhere on the board

Notes on the sheet:
12V motor rail only. 12mm shared bus; 2mm per-axis feeds; 1oz copper. Thermal evaluation stopped.
NC switch across J6: closed permits EN commands, open tri-states every EN output.
R1 pulls /OE high on open loop. Local R21-R26 pull EN low independently of firmware.
Reclosing switch restores commanded state; no restart latch. Kill does NOT isolate 12V.
U1/U2 SN74HC125N PDIP14, 3.3V, no Ioff. Unused inputs tied; unused outputs NC.

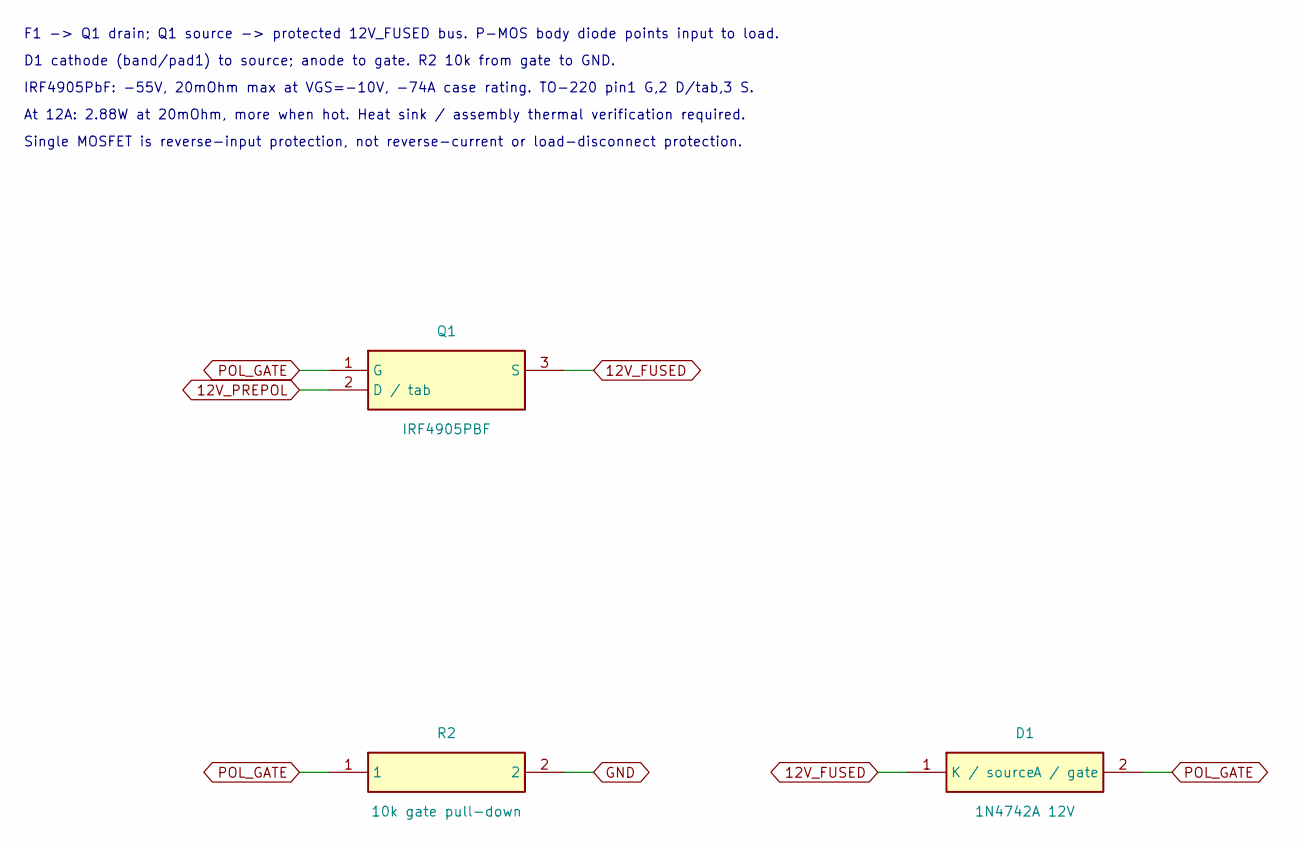
[picture p71: schematic protection.kicad_sch, 09 / Fused reverse-polarity protection]

Parts:
D1: 1N4742A 12V; Edge_D_DO-41_SOD81_P10.16mm_Horizontal
Q1: IRF4905PBF; Edge_TO-220-3_Vertical
R2: 10k gate pull-down; Edge_R_Axial_DIN0207_L6.3mm_D2.5mm_P7.62mm_Horizontal

Connections:
12V_FUSED: D1.1 (K / source), Q1.3 (S); also elsewhere on the board
12V_PREPOL: Q1.2 (D / tab); also elsewhere on the board
GND: R2.2; also elsewhere on the board
POL_GATE: D1.2 (A / gate), Q1.1 (G), R2.1

Notes on the sheet:
F1 -> Q1 drain; Q1 source -> protected 12V_FUSED bus. P-MOS body diode points input to load.
D1 cathode (band/pad1) to source; anode to gate. R2 10k from gate to GND.
IRF4905PbF: -55V, 20mOhm max at VGS=-10V, -74A case rating. TO-220 pin1 G,2 D/tab,3 S.
At 12A: 2.88W at 20mOhm, more when hot. Heat sink / assembly thermal verification required.
Single MOSFET is reverse-input protection, not reverse-current or load-disconnect protection.
