AsherNoble/trueskate-ai-hardware/pcb/design/trueskate-main-v1.kicad_pcb

## KiCad design pcb/design/trueskate-main-v1.kicad_pcb (continued)

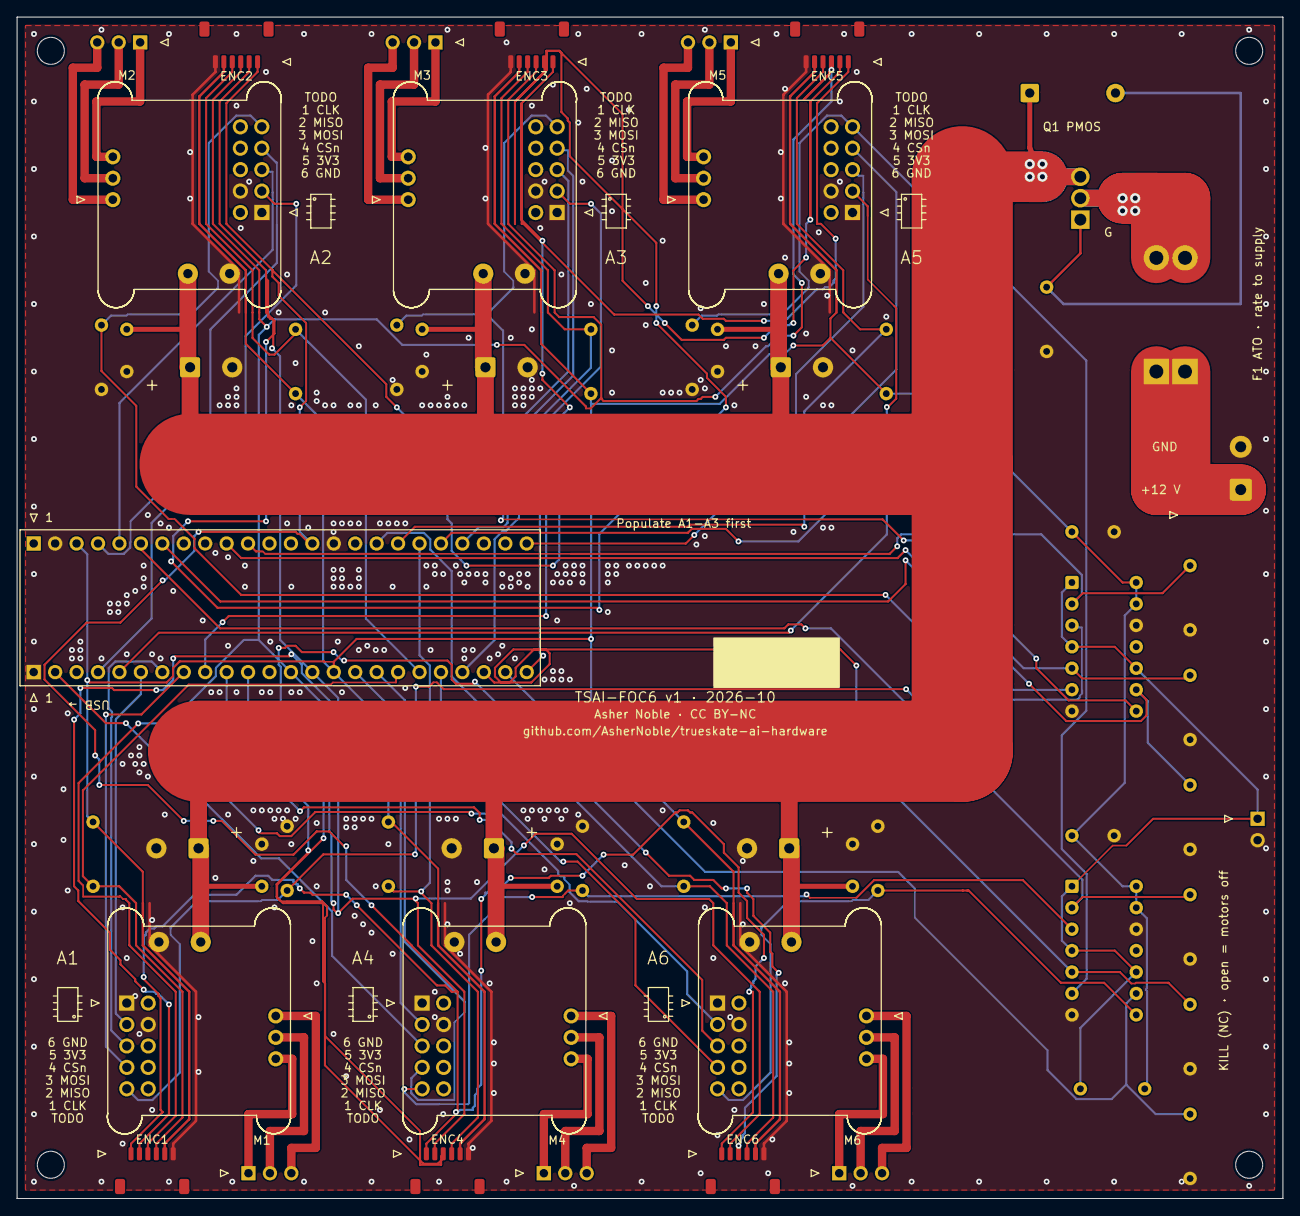
[picture p72: board trueskate-main-v1.kicad_pcb from above]

Board: 2 copper layers, 150.0 x 140.0 mm, 65 parts (0 on the bottom side), 64 nets.

Other parts of the board:
H1, H2, H3, H4: MountingHole_3.2mm_M3
