AsherNoble/trueskate-ai-hardware/(commit log)

2026-09-22 feat: add loop-timing benchmark as its own PlatformIO env
    Measures per-iteration cost of sensor.update(), loopFOC(), move() and the
    whole loop body using ARM_DWT_CYCCNT, converted through F_CPU_ACTUAL. No
    serial output during collection: samples go into online stats plus a 1 us
    histogram, rendered afterwards.
    Lives in firmware/bench/loop_timing and builds as env:loop_timing via
    build_src_filter, so it can never end up in a controller build. Safety
    matches the main firmware: motor disabled at boot, initFOC only on 'I',
    voltage_limit 2 V.
    Measured on the index axis, 20000 iterations per phase:
    - sensor.update() is 34.79 us at 1 MHz and dominates everything; FOC
    compute is 1.93 us (torque)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
2026-09-22 docs: add PCB requirements draft, archive Chihai bring-up
    PCB requirements v1 (docs/pcb-requirements.md): board split, actuator
    inventory, power, pin allocation, connectors, grounding, safety and ten
    open decisions. Draft -- TBD items are unresolved, not omissions.
    Move the Chihai CHR-RK520 + DRV8871 bench project in from a sibling
    directory to firmware/bringup/chihai_rk520_drv8871/. Files are unchanged;
    the .pio build output was dropped as regenerable. This is the
    beautification-finger motor family (brushed DC, incremental AB encoder,
    Mega 2560), not the driven axes, so it has its own platformio.ini and is
    excluded from both repo envs by build_src_filter.
    Its README flags what SESSION_NOT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
2026-09-25 fix: link the Teensy PWM driver by disabling lib_archive
    SimpleFOC ships its generic PWM implementations as WEAK symbols and the
    MCU-specific ones as strong. Archived (PlatformIO's default), the linker
    scans members in order, generic_mcu.cpp.o sorts first, its weak
    _configure3PWM satisfies the reference, and teensy_mcu.cpp.o is never
    extracted. Strong-beats-weak only arbitrates between objects that are
    actually linked, so the Teensy driver silently never ran and
    SIMPLEFOC_TEENSY4_FORCE_CENTER_ALIGNED_3PWM did nothing.
    Neither firmware.elf contained a single TEENSY-DRV string before this.
    The arduino-cli builds did link it, which is why the bench bring-up
    behaved -- but any PlatformIO-flashe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
2026-09-25 pcb: correct the encoder connector pinout to the verified order
    Read from the working bench breakout, pin 1 being the square pad with the
    traces running straight from socket to header:
    1 CLK, 2 MISO, 3 MOSI, 4 CSn, 5 VDD 3.3V, 6 GND
    CSn is contact 4, not contact 1. The previous assumed order had CSn first
    and every signal shifted one position, so all six sockets J31-J36 were
    wrong. Updated generate.py, regenerated the schematic, board, ERC, DRC,
    schematic PDF, fit template and renders. Netlist now confirms J31 pin 1
    SPI_SCK_CABLE, pin 4 A1_CS_CABLE.
    Cleared the provisional flag on the signal order. Deliberately kept a
    narrower one: the measurement settles the order along the connector,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
2026-09-25 feat: add the flick-and-reset bench test for axis 1
    Decides whether voltage-mode FOC without current sensing tracks a fast
    out-and-back, or whether per-motor current control is needed.
    Step (90 deg), single flick (60 deg out and straight back) and 20 flicks
    back to back, in angle mode with velocity_limit deliberately high so that
    voltage is the binding constraint. Logs at 1 kHz into a 336 KB DMAMEM
    buffer -- never live serial, which would dominate the timing it measures
    -- and dumps CSV after each run. voltage_limit adjustable 2 to 6 V via
    updateVoltageLimit(), which unlike a bare assignment also moves
    PID_velocity.limit.
    Not yet run. Gains are SimpleFOC defaults, so a poor result could be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
2026-09-25 feat(bench): P_angle sweep — settable gains and binding-limit reporting
    Adds 'P' (P_angle) and 'L' (velocity_limit) commands alongside 'V', and a
    per-run summary classifying every stroke sample as velocity-cap-limited,
    Uq-saturated, or neither. velocity_limit held at 200 rad/s throughout: peak
    demand is P_angle x 1.047 rad, so 167.6 rad/s at P_angle 160, cleared by
    19%. It never bound (0.0% in every run), so P_angle stayed the only
    variable.
    Sweep results, single 60 deg flick, motor unloaded:
    P_angle V cycle rise overshoot Uq sat
    20 2 417 ms 118ms 0.0% 3.9%
    40 2 225 ms 58ms 0.0% 12.8%
    40 4 219 ms 56ms 0.0% 6.3%
    8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
2026-09-25 data(bench): 20-flick endurance at P_angle 160 / 4 V
    Closes the gap the sweep left: the only previous repeatability run was at
    P_angle 20 / 2 V with 3.9% Uq saturation, a gentle duty. This is 20 flicks
    at the fastest clean operating point, 42.6% saturated, 7.0 s continuous.
    out rise 20.15 ms sd 0.36
    back rise 19.95 ms sd 0.38
    full cycle 95.00 ms sd 2.30
    peak reach 61.39 deg sd 0.24
    Uq sat 42.70% sd 2.51
    No thermal droop. First five vs last five: rise -1.96%, cycle -0.43%, peak
    reach +0.64%, saturation -3.14%. Every one of those either moved the
    opposite way to droop or stayed flat -- a warming winding would show slower
    rise, longer cycle, shorter reach and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
2026-10-11 feat: finish through-hole six-axis carrier review design
2026-10-23 chore: checkpoint PCB fabrication and mockups (WIP)
2026-10-23 feat: use exact Mini v1.0 footprints with direct power routing
2026-10-24 feat: relayout carrier with edge connectors and hardware kill
2026-10-24 feat: convert carrier to four layers with dedicated power and ground planes
2026-10-24 feat: restore two-layer 1 oz carrier with ground stitching
2026-10-24 chore: organize PCB design, review assets and tooling
2026-10-25 feat: export validated JLCPCB Gerber package
2026-10-25 chore: checkpoint carrier before 3+3 relayout
2026-10-25 feat: finalize 3+3 carrier and bare PCB fabrication package
2026-10-28 chore: update buffer selection, sourcing BOM and repository rules
    Select TI SN74HC125N C2890 without layout changes and document the unresolved powered-off EN guarantee.
    - Update design metadata, BOMs, assembly planning and EN verification.
    - Include the formatted sourcing workbook and purchasing documentation.
    - Add the requested commit and push rules.
